P3drOk/P3drOk/ferramentas/RS485_T3D.md

# RS485 com o driver HLTNC T3D — por que não responde

Ferramenta: [`teste_rs485/teste_rs485.ino`](teste_rs485/teste_rs485.ino).
Sketch avulso, não faz parte do firmware da máquina.

---

## Antes de tudo: uma ressalva que pode te poupar dias

Você quer o encoder para detectar perda de passo. **Modbus não é o
caminho certo para isso**, mesmo que funcione.

Cada leitura Modbus custa entre 5 e 20 ms (pergunta, silêncio de quadro,
resposta). Isso dá umas 50 leituras por segundo no melhor caso, e com
jitter. Para mostrar a posição na tela, ótimo. Para pegar o motor
perdendo passo no meio de um cordão, é lento e irregular demais.

O caminho certo para malha fechada é a **saída de pulsos do encoder do
próprio driver** (PA/PB, quadratura) entrando num contador PCNT do
ESP32 — hardware contando, sem software no meio, sem latência. É o que
está no [`ROADMAP.md`](../ROADMAP.md) §1.4.

Então: RS485 vale para ler posição, alarme e parâmetros. Para perda de
passo, PA/PB. Se o RS485 estiver te custando muito tempo, vale trocar de
frente.

---

## 1. O suspeito número um: o conversor de nível

**Só UMA linha precisa de conversão de nível, e o conversor da foto é o
tipo errado para ela.**

Olhe as quatro linhas entre o ESP32 e o MAX485:

| Linha | Sentido | Precisa converter? |
|---|---|---|
| `DI` | ESP32 → MAX485 | **não** |
| `DE` | ESP32 → MAX485 | **não** |
| `RE` | ESP32 → MAX485 | **não** |
| `RO` | MAX485 → ESP32 | **sim**, 5 V → 3,3 V |

As três primeiras são entradas do MAX485, e o `VIH` dele é **2,0 V**. Os
3,3 V do ESP32 são lidos como nível alto sem problema. Passar essas
linhas pelo conversor só adiciona coisa para dar errado.

A quarta, `RO`, sai em 5 V e não pode entrar direto no ESP32.

### Por que aquele conversor azul não serve bem aqui

O módulo da foto é o de MOSFET (BSS138) com resistores de 10 kΩ. Ele foi
desenhado para **I²C**, que é dreno aberto: o barramento é puxado para
baixo ativamente e para cima por resistor.

UART é **push-pull**. Nesse conversor, a subida do sinal depende do
resistor de 10 kΩ carregando a capacitância do fio. Isso arredonda a
borda. A 9600 costuma sobreviver; a 115200, não. E é fácil ligar HV e LV
trocados sem perceber — aí ele simplesmente não passa nada.

### O que usar no lugar

Dois resistores, direto no `RO`:

```
  RO (5 V) ──┬── R1 1 kΩ ──┬── GPIO 22 (ESP32 RX)
             │             │
             │           R2 2 kΩ
             │             │
            ─┴─           GND
```

`5 V × 2 / (1 + 2) = 3,33 V`. Serve qualquer par na proporção 1:2 —
1 k/2 k, 1,5 k/3,3 k, 2,2 k/4,7 k.

Simples, rápido, sem borda arredondada. **Guarde o conversor de MOSFET
para I²C**, que é para o que ele é.

### Alternativa melhor ainda

Trocar o chip do módulo por um **MAX3485** (mesmo encapsulamento SO-8,
mesma pinagem) e alimentar o módulo com **3,3 V**. Aí não precisa de
conversão nenhuma em lado nenhum.

Alimentar um MAX485 comum com 3,3 V está **fora de especificação** (o
mínimo é 4,75 V). Às vezes funciona, às vezes funciona só até certa
distância, e às vezes funciona no bancada e falha na oficina. Não é
lugar de economizar.

---

## 2. Trocar A com B

Segunda causa mais comum, e o teste custa 30 segundos: **desligue,
inverta os dois fios do par, ligue e rode a varredura de novo.**

RS485 é diferencial. Invertido, o receptor lê o complemento de tudo — não
dá erro, não dá aviso, simplesmente nada faz sentido e o CRC nunca bate.

Não confie na serigrafia: fabricantes chamam de `A`/`B`, `D+`/`D-`,
`RS485+`/`RS485-`, e nem todos concordam sobre qual é qual.

---

## 3. GND comum

**O GND do ESP32 tem que estar ligado ao GND de sinal do driver.**

RS485 é diferencial, mas não é mágico: o receptor tem uma faixa de modo
comum (tipicamente −7 V a +12 V). Dois equipamentos com fontes separadas
e sem referência comum saem dessa faixa com facilidade, e aí o receptor
não lê nada — ou lê lixo intermitente, que é pior.

Se o cabo for longo ou o ambiente for de solda, ligue o GND por um
resistor de 100 Ω em vez de direto, para não fechar laço de terra.

---

## 4. Terminação e polarização

- **Terminação:** 120 Ω entre A e B nas **duas pontas** do barramento.
  Em cabo curto de bancada raramente faz diferença; em cabo de oficina,
  faz. Muitos módulos azuis já trazem um 120 Ω soldado — se você puser
  um em cada ponta e o módulo já tiver o dele, ficam três, o que carrega
  demais a linha.
- **Polarização:** com o barramento parado e ninguém dirigindo, A e B
  flutuam e a saída do receptor treme, gerando bits de início falsos.
  Resistores de polarização (tipicamente 10 kΩ de A para VCC e 10 kΩ de B
  para GND) seguram a linha no estado ocioso. Os módulos azuis costumam
  trazer isso; confira com o multímetro se A fica acima de B com o
  barramento em repouso.

---

## 5. O driver pode simplesmente estar com a porta desligada

Esta é a que mais me faria apostar depois do conversor de nível.

Servo driver chinês costuma sair de fábrica com a comunicação **desativada**,
ou num protocolo proprietário em vez de Modbus. Procure no manual, nos
parâmetros do teclado do driver:

- número da estação / endereço do escravo
- velocidade de comunicação (baud)
- protocolo (Modbus RTU × proprietário)
- às vezes um parâmetro separado de *habilitar comunicação*

Enquanto isso não estiver certo, nenhum código do mundo vai receber
resposta.

E confira **quais pinos do RJ45** são A e B. Isso está no manual e não dá
para adivinhar. Vários desses drivers têm dois RJ45 (entrada e saída, para
ligar em cadeia) — os dois são o mesmo barramento.

---

## 6. O atalho que vale mais que tudo isso

Se o driver veio com **software de configuração para PC + adaptador
USB-RS485**:

1. Ligue o adaptador do fabricante e faça o software falar com o driver.
2. Com o barramento funcionando, ligue o seu MAX485 **em paralelo** (A no
   A, B no B, GND comum) — RS485 é multiponto, dá para escutar.
3. Rode o **modo 2 (escutar)** do sketch.

Você vê os quadros que o software do fabricante manda, com endereço,
função e número de registrador. **O mapa Modbus aparece pronto na tela**,
em vez de você ter que descobrir por varredura.

É de longe o caminho mais rápido, e resolve também a dúvida de baud,
paridade e endereço de uma vez só.

---

## 7. Como usar o sketch

Grave `teste_rs485/teste_rs485.ino` sozinho (não é o firmware da máquina)
e abra o monitor serial em **115200**, com final de linha *Nova linha*.

### Ligação

| MAX485 | vai para |
|---|---|
| `RO` | divisor 1 k / 2 k → **GPIO 22** |
| `DI` | **GPIO 21** |
| `DE` | **GPIO 4** |
| `RE` | **GPIO 26** |
| `VCC` | 5 V |
| `GND` | GND, **comum com o ESP32** |
| `A`, `B` | par trançado até o driver |

`DE` e `RE` em pinos **separados** de propósito: é o que permite o
autoteste. Em operação normal eles andariam juntos.

Os quatro pinos estão livres no mapa do firmware
([`LIGACOES.md`](../LIGACOES.md) §1), então dá para migrar isto para a
máquina depois sem remexer em nada.

### A ordem dos testes

**`1` — autoteste do módulo.** Não precisa do driver ligado. Com `DE=1` e
`RE=0` ao mesmo tempo, o MAX485 dirige o par A/B e lê de volta o que ele
mesmo colocou lá.

> Se este falhar, **pare aqui**. O problema está entre o ESP32 e o
> módulo, e procurar o driver é perda de tempo. O sketch diz o que
> costuma ser.

**`3` — procurar o driver.** Varre velocidade × paridade × endereço e
anota **todos** os achados numa tabela, que ele imprime no fim. Depois
adota sozinho a primeira combinação com resposta válida (ou a primeira
com exceção, se não houver nenhuma válida) — os modos seguintes já saem
apontados para o lugar certo.

Reporta três coisas diferentes, e as três são úteis:

| O que aparece | O que quer dizer |
|---|---|
| resposta válida | achou |
| resposta de **exceção** | **achou também.** O driver respondeu "esse registrador não existe" — ou seja, ele está aí e falando. Só faltou o endereço certo. |
| bytes com CRC ruim | a velocidade está perto; a paridade provavelmente está errada |
| silêncio total | veja as seções 1 a 5 acima |

**`4` — varrer registradores.** Lê um por um e mostra o conteúdo.
Exceção **não** é escondida: se o driver recusar a faixa inteira, isso
aparece com o código e o significado. Tela vazia não ensina nada.

**`7` — caçar o encoder.** É o que responde à pergunta de verdade:

1. `7 0 255`
2. Ele lê tudo e pede: *"GIRE O EIXO A MÃO, bastante, e aperte qualquer
   tecla"*
3. Lê de novo e lista **só os registradores que mudaram**, com antes,
   depois e a variação

O que variou muito é a parte baixa da posição; o vizinho que variou
pouco ou nada é a parte alta.

**`6` — monitorar ao vivo.** Confirma o achado: `6 100` lê o registrador
100 e o 101 dez vezes por segundo e mostra, lado a lado, **as duas
montagens possíveis de 32 bits** mais a velocidade em unidades por
segundo.

```
  reg      +1       32b alto|baixo   32b baixo|alto   unid/s
  --------------------------------------------------------
  1204     0        78905344         1204             0.00
  1387     0        90898432         1387             1830.00
```

Isto importa mais do que parece: **muito driver Modbus manda a palavra
baixa primeiro**. Olhando só uma das montagens, a posição parece pular
sem sentido e você conclui que achou o registrador errado. A coluna que
cresce **suave** ao girar o eixo é a certa; a outra dá saltos de dezenas
de milhares — é o sinal clássico de palavra alta e baixa trocadas.

**`5` — quadro cru.** Para o dia em que você tiver o manual: digite os
bytes em hexadecimal sem o CRC, que ele calcula e mostra a resposta crua.

```
5 01 03 00 00 00 02
```

---

## 8. Um erro que este arquivo já cometeu

Na primeira versão, o resumo do modo `3` imprimia `baudAtual` e
`paridadeAtual` — que são as **variáveis do laço da varredura**. No fim
elas ficam com a última combinação *tentada*, não com a que funcionou.

Resultado: a varredura achava o driver de verdade em algum lugar, e o
resumo anunciava `250000 8O1` — que era só a última célula do laço. Os
modos seguintes iam falar em 250000 8O1, não ouviam nada, e a tela
ficava vazia.

Corrigido: os achados vão para uma tabela e o resumo lista **todos**.
Se o seu resultado antigo dizia 250000 8O1, ele provavelmente estava
errado — rode o modo `3` de novo com a versão nova.

## 9. Um detalhe de código que derruba muita gente

Vale conhecer porque é invisível no osciloscópio se você não procurar.

Depois de mandar o quadro, é preciso baixar o `DE` para poder ouvir a
resposta. Mas `Serial.flush()` só garante que a **fila** esvaziou — o
último bit ainda pode estar saindo do registrador de deslocamento. Baixar
o `DE` nesse instante corta o fim do quadro, o CRC não bate no escravo, e
ele **descarta em silêncio**.

Do lado de cá parece que o driver simplesmente não responde.

O sketch espera dois tempos de caractere depois do `flush()` antes de
soltar o `DE`. Se você escrever o seu próprio código depois, não esqueça
disso.

---

## O que foi medido nesta máquina

| | |
|---|---|
| velocidade | **19200 8N1** |
| endereço | **1** |
| função | **3 — holding registers** |
| posição | **registrador 90 (baixa) e 91 (alta)** |
| ordem | **palavra baixa primeiro** |

**Como se provou.** Três caçadas separadas, em posições diferentes do
eixo, montadas como 32 bits com a baixa primeiro:

| caçada | de | para | variou |
|---|---|---|---|
| A | 9 361 | 15 841 | +6 480 |
| B | 15 842 | 124 571 | +108 729 |
| C | 124 574 | 42 069 | −82 505 |

Repare nas emendas: A termina em 15 841 e B começa em 15 842. B termina
em 124 571 e C começa em 124 574. **O valor é contínuo entre caçadas** —
coincidência não é contínua três vezes seguidas.

Na caçada B o registrador 90 deu a volta (passou de 65 535) e o 91 subiu
de 0 para 1, exatamente como uma palavra baixa e uma alta fazem. Na
caçada A, que andou pouco, o 91 nem se mexeu.

### Os registradores 92, 93 e 94 não são a posição

Eles aparecem nas caçadas e confundem. Repare no comportamento: andam
**juntos** (os dois +6, depois os dois −23) e vão para valores negativos
(65 530 = −6). Isso é **erro de seguimento** e velocidade, não posição.
A diferença prática: eles voltam para perto de zero quando o eixo para;
a posição não volta.

É por isso que a caçada, nos modos 7 do programa e no painel, deixou de
listar candidatos e passou a **provar o par**: monta r/r+1 das duas
maneiras e só aponta quando a montagem certa é pelo menos 8× mais mansa
que a errada. Um par que não é de 32 bits não passa nesse crivo.

## Modos novos

| | |
|---|---|
| `8 90` | **mede as contagens por volta.** Marca, você dá uma volta completa no eixo do motor, marca de novo. É o único número do encoder que não dá para descobrir olhando — sem ele a leitura não vira grau |
| `9 90` | **grava a posição em CSV** (`ms,contagem,delta`) para colar numa planilha. É assim que se enxerga passo perdido, folga e ruído, que número na tela não mostra |

O modo 8 encaixa no valor redondo mais próximo quando está dentro de 3%:
uma volta dada à mão nunca fecha exata, e é mais provável que a mão tenha
ficado torta do que o encoder ter um número quebrado.

## Um defeito do próprio programa, corrigido

O autoteste (modo 1) passeia por todas as velocidades e **não devolvia a
linha como estava** — terminava deixando 115200 8O1, e o menu passava a
mentir logo depois de dizer "MODULO OK". Aparece nos logs como
`atual: 115200 8O1` logo abaixo do autoteste. Agora ele guarda e
restaura.

## Escrever no driver — e por que isso mora aqui, e não no firmware

O firmware da máquina **lê e só lê**: `encoder.h` diz isso no cabeçalho e
o banco reprova quem tentar configurar uma função de escrita. Não é
timidez. Ler no registrador errado dá um número errado na tela; escrever
no registrador errado num servo drive pode trocar a engrenagem eletrônica,
o modo de controle, o sentido do eixo ou o limite de torque — e o eixo
pode sair andando.

Enquanto não se souber **com certeza** qual registrador é o quê neste
driver, escrever é experimento de bancada, com o motor desacoplado da
mecânica, e não função de painel. Por isso os modos abaixo estão neste
sketch avulso.

| | |
|---|---|
| `d` / `d 4096 4351` | **foto da faixa.** Lê tudo e guarda. Nada é escrito |
| `d2` | **compara** com a foto e lista o que mudou |
| `w 98 1` | **escreve** 1 no registrador 98 pela função 06, e confere relendo |
| `W 98 1` | o mesmo pela função 16 — há driver que recusa a 06 mesmo para um registrador só |
| `s 98` / `s 98 1 0` | **testa o SON**: habilita, você confere o eixo, desabilita |

### Achar um parâmetro sem escrever nada

É o mesmo raciocínio do modo 7 (achar o encoder movendo o eixo), só que o
que se mexe é um parâmetro em vez do braço:

1. `d` — tira a foto dos registradores.
2. Vá ao **painel do driver** e mude o parâmetro (P098, por exemplo).
3. `d2` — o que mudou entre as duas fotos é o endereço daquele parâmetro.

Zero escrita: se o endereço estiver errado, o pior que acontece é não
achar nada. Deixe o eixo **parado** — a posição muda sozinha e apareceria
na lista junto com o parâmetro.

### Toda escrita é conferida relendo

Driver que responde *aceitei* e guarda outra coisa existe: registrador só
de leitura, escrita bloqueada por nível de acesso, parâmetro que só vale
com o servo desabilitado. Sem reler, o programa diria "pronto" e nada
teria mudado. `w`, `W` e `s` releem e comparam.

### O SON pelo Modbus — agora é assim que a máquina funciona

Este arquivo dizia, com razão, que o `SON` era um **fio** e que trocá-lo
pelo barramento não valia a pena. Na bancada desta máquina o argumento
caiu por baixo: o **P098** do painel governa o torque, e com ele em 1 o
terminal externo não tinha efeito nenhum. O fio do GPIO 23 já era
decorativo antes de sair.

O habilita foi para o Modbus. Medido aqui:

| | |
|---|---|
| registrador | **98** (é o P098 do painel) |
| habilita | **1** |
| desabilita | **0** |
| função | **06** |

**O que isso custa continua verdade e não mudou.** Fio de SON rompido
desabilitava o motor. Fio de RS485 rompido **não desabilita nada** —
deixa o eixo como estava. O caminho do habilita deixou de ser falha
segura.

O que se pôs no lugar:

1. **Contator** em série com a potência dos drivers, aberto pelo contato
   NC da emergência. É o único corte que funciona com o ESP32 morto, e
   deixou de ser recomendação. Ver `LIGACOES.md` §6.
2. Toda escrita é conferida **relendo**, e desabilitar que não confirma
   derruba a máquina em `FALHA` — ver os cenários **V01 a V05** do banco.

O modo `s` continua sendo por onde se descobre o registrador antes de
gravá-lo em **Ajustes → Habilita (SON)**.

## O alarme pelo Modbus

O `ALM` continua sendo fio (GPIO 34/35). Pelo barramento dá para ler o
**código** da falha, e não só "tem falha" — o fio é um bit, o registrador
é o motivo.

| | |
|---|---|
| `a 100` | **ler ao vivo**: mostra o valor em número, hex e bits, e avisa quando muda. Não escreve |
| `a 100 0` | **rearmar**: escreve 0 no 100 e confere se limpou |
| `A 100 0` | o mesmo pela função 16 |

### Achar o registrador do alarme

Mesma receita do P098, com o gatilho trocado:

1. `d` — foto da faixa.
2. **Provoque um alarme de verdade**: desligue o cabo do encoder do
   driver, ou force sobrecarga.
3. `d2` — o que mudou é o alarme.

Depois `a <reg>` com a falha indo e voltando: anote o valor **com** falha
e o valor **sem**. São eles que dizem o que é alarme neste driver.

### Ler e rearmar são coisas diferentes

**Ler** não muda nada e roda com a máquina montada. **Rearmar** escreve, e
só limpa alarme cuja causa já foi resolvida — se o motivo continua lá, o
driver rearma e alarma de novo no mesmo instante. Isso não é defeito do
rearme: é o driver fazendo o trabalho dele.

> **Nunca rearme em laço.** Alarme que volta sozinho é informação: alguma
> coisa está errada na máquina. Rearmar repetido esconde exatamente o que
> você precisa ver, gasta a EEPROM do driver, e deixa o eixo energizando
> e desenergizando sem ninguém no controle.

O firmware **não** rearma alarme. Isso é decisão de quem está na frente
da máquina, com os olhos nela.
