P3drOk/P3drOk/(list of files, cad)

Other CAD files:
testes/interface/amostras/peca.dxf
