P3drOk/P3drOk/MANUAL.md

# Robo2dof — manual do sistema

Braço de solda de **dois eixos**, comandado por um ESP32 que serve um
painel web pela sua própria rede Wi-Fi. Sem nuvem, sem internet, sem
aplicativo para instalar: entra-se na rede do robô e abre-se o painel.

Este documento é o mapa completo. Para a explicação de *como as coisas
foram descobertas* (e dos defeitos que apareceram no caminho), veja
[`ACHADOS.md`](ACHADOS.md).

---

## 1. O que é a máquina

| | |
|---|---|
| Estrutura | braço planar de 2 graus de liberdade (dois eixos girando no mesmo plano horizontal) |
| Motores | 2 × servo AC **80AST-A1C04025** |
| Drivers | 2 × **HLTNC T3D-L20A** |
| Cérebro | ESP32 (WROOM-32), dois núcleos |
| Realimentação | encoder do próprio servo, lido pelo driver por **Modbus RTU / RS485** |
| Interface | página web servida pelo ESP32, na rede Wi-Fi que ele mesmo cria |
| Armazenamento | NVS interna (configuração) + cartão microSD (programas e trajetórias) |

### A regra de ouro do projeto

> **O núcleo 1 manda no motor. O núcleo 0 nunca toca no motor.**

O núcleo 1 roda o `loop()`: geração de pulso, estado da máquina, relé de
solda. O núcleo 0 roda tudo que espera por alguém: servidor web, Wi-Fi,
cartão, leitura do encoder.

A comunicação entre eles é de mão única e por duas estruturas apenas:

- **`Comando`** — o núcleo 0 enfileira, o núcleo 1 consome.
- **`Snapshot`** — o núcleo 1 publica, o núcleo 0 lê.

Nenhum handler web chama `posicaoJ1()`. Nenhuma tarefa de rede move um
eixo. Quando essa regra foi quebrada (aconteceu duas vezes), o sintoma
foi leitura corrompida e quadro perdido — está registrado em `ACHADOS.md`.

---

## 2. Ligações

A tabela oficial e conferida por teste é [`LIGACOES.md`](LIGACOES.md) —
o script `testes/conferir_ligacoes.py` reprova se ela discordar de
`Robo2dof/config.h`. Resumo:

### Motores

| Sinal | GPIO | Observação |
|---|---|---|
| J1 pulso | 16 | vai para `PUL+` via buffer 5 V |
| J1 direção | 17 | `DIR+` |
| J2 pulso | 18 | |
| J2 direção | 19 | |
| Alarme J1 | 34 | **só entrada**, precisa de pull-up externo de 10 k |
| Alarme J2 | 35 | idem |

> **O habilita não está nesta tabela.** Ele deixou de ser fio: vai por
> **Modbus**, no registrador **98** (o `P098` do painel), pelo mesmo
> RS485 que lê o encoder. O GPIO 23 ficou livre. Em troca, o **contator**
> da emergência passou a ser obrigatório — é o único corte que funciona
> com o ESP32 travado. Ver `LIGACOES.md` §3.3 e §6.

> GPIO 34 e 35 não têm pull-up interno. Sem o resistor externo, o pino
> flutua e o firmware lê ruído. O flag `ALARME_FISICO_INSTALADO` fica
> `false` até a fiação existir — foi exatamente esse o travamento da v2.1.

### Solda e emergência

| Sinal | GPIO | Observação |
|---|---|---|
| Relé da solda | 2 | ativo em ALTO, com **pull-down físico de 10 k** para GND |
| Botão de emergência | 27 | contato NC: LOW = emergência |

> O GPIO 2 é o LED da placa — útil na bancada, ruim na máquina: é
> *strapping pin* e pisca sozinho durante o boot, o que num relé de solda
> significa abrir arco na hora de energizar. Na máquina de verdade,
> troque para o 26 (e então `PIN_LED_STATUS` tem de ficar em 255).

### Cartão microSD (SPI)

| Módulo | GPIO | |
|---|---|---|
| 3V3 | 3V3 | **nunca no 5 V** neste módulo: ele não tem regulador |
| CS | 5 | |
| SCK | 14 | |
| MOSI | 13 | |
| MISO | **25** | *não* o 12 |

> O GPIO 12 é o MISO "padrão" do HSPI, e o módulo tem pull-up de 10 k
> nessa linha. O 12 é strapping (MTDI): alto no boot programa o regulador
> do flash para 1,8 V e a placa não dá mais boot. Por isso o MISO vai
> para o 25 — o ESP32 remapeia SPI por matriz, então não se perde nada.
>
> Ponha 10 µF cerâmico entre 3V3 e GND junto ao módulo: o cartão puxa
> picos de ~100 mA na escrita.

### RS485 (leitura do encoder)

| MAX485 | GPIO | |
|---|---|---|
| RO | 22 | via **divisor de 2 resistores**, não conversor de MOSFET |
| DI | 21 | |
| DE | 4 | 1 = transmitindo |
| RE | 26 | 0 = ouvindo |
| A / B | driver | trocados = silêncio absoluto |
| GND | comum | obrigatório |

> **A UART2 do ESP32 tem 16 e 17 como pinos padrão** — que neste projeto
> são o passo e a direção da junta 1. Todo `begin()` deste projeto passa
> RX e TX explicitamente, e o cenário `L01c` reprova se alguém esquecer.

---

## 3. Configuração do driver T3D-L20A

O mapa Modbus do T3D **não é publicado** e muda por versão de firmware.
Os valores abaixo foram **medidos** nesta máquina com
`ferramentas/teste_rs485`.

| | |
|---|---|
| Velocidade | **19200 8N1** |
| Endereço Modbus | **1** (junta 1) |
| Função | **3 — holding registers** |
| Posição | registrador **90** (palavra baixa) e **91** (alta) |
| Ordem | **palavra baixa primeiro** |
| Contagens por volta | **131 072** (encoder de 17 bits) |

### Como esses números foram provados

Três caçadas separadas, em posições diferentes do eixo, montando 90/91
como 32 bits com a baixa primeiro:

| caçada | de | para | variou |
|---|---|---|---|
| A | 9 361 | 15 841 | +6 480 |
| B | 15 842 | 124 571 | +108 729 |
| C | 124 574 | 42 069 | −82 505 |

O valor é **contínuo entre caçadas** — A termina em 15 841 e B começa em
15 842. Coincidência não é contínua três vezes. E na caçada B o
registrador 90 deu a volta e o 91 subiu de 0 para 1, que é exatamente o
que uma palavra baixa e uma alta fazem.

### Registradores que enganam

**92, 93 e 94 não são a posição.** Eles mudam quando o eixo gira e
chegam a dar o maior salto da lista, mas:

- andam **juntos** (os dois +6, depois os dois −23);
- vão para valores negativos (65 530 lidos sem sinal são **−6**);
- **voltam para perto de zero quando o eixo para**.

É erro de seguimento e velocidade. A posição não volta. Por isso a
caçada do sistema exige **dois giros no mesmo sentido** antes de apontar
um par.

### Parâmetros do driver a conferir

Pelo painel do próprio driver (não pelo Modbus — este sistema **nunca**
escreve registrador):

| | |
|---|---|
| Porta RS485 | **habilitada** — muitos T3D saem de fábrica com ela desligada |
| Endereço | 1 na junta 1, 2 na junta 2 (endereços diferentes no mesmo barramento) |
| Velocidade | 19200, 8N1 |
| Engrenagem eletrônica | define os **pulsos por volta** que o firmware precisa saber (`PASSOS_POR_VOLTA_PADRAO`, 10000 de fábrica) |
| Modo de comando | pulso + direção, coletor aberto |

---

## 4. Como o firmware é organizado

| Arquivo | O que faz |
|---|---|
| `Robo2dof.ino` | `setup()`, `loop()`, máquina de estados dos modos, `processarComando()` |
| `config.h` | pinos, limites elétricos e mecânicos, padrões de fábrica |
| `estado.h/.cpp` | `Junta`, `Snapshot`, fila de comandos, configuração e NVS |
| `motores.h/.cpp` | FastAccelStepper, jog, movimento coordenado, parada |
| `cinematica.h/.cpp` | direta e inversa do braço 2R, validação de postura e de caminho |
| `trajetoria.h/.cpp` | gravação e reprodução a mão livre |
| `programa.h/.cpp` | pontos, cordões em reta interpolada, deslocamentos |
| `calibracao.h/.cpp` | as quatro marcas de curso das juntas |
| `solda.h/.cpp` | relé, com as proteções |
| `armazenamento.h/.cpp` | cartão SD, tarefa própria no núcleo 0 |
| `rede.h/.cpp` | ponto de acesso, mDNS, DNS de captura |
| `servidor_web.cpp` | todas as rotas HTTP |
| `encoder.h/.cpp` | mestre Modbus, tarefa própria no núcleo 0 |
| `correcao.h/.cpp` | assentamento de posição pelo encoder, seguir o eixo solto, zero absoluto |
| `aprender.h/.cpp` | modo aprendizado e o botão físico da ponteira |
| `ota.h/.cpp` | atualização de firmware pela rede |
| `pagina_web.h` | a interface inteira, um arquivo — **é aqui que se edita** |
| `pagina_web_gz.h` | gerado; `testes/gerar_pagina_gz.py` refaz |

### Modos da máquina

| Modo | O que acontece |
|---|---|
| `MANUAL` | jog liberado, ajustes permitidos |
| `GRAVANDO` | jog + amostragem da trajetória a mão livre |
| `REPRODUZINDO` | repete a trajetória gravada |
| `EXECUTANDO` | roda o programa de pontos |
| `POSICIONANDO` | indo para um alvo — e, ao chegar, **assentando pelo encoder** |
| `CALIBRANDO` | assistente de curso |
| `FALHA` | parada suave, nada anda |

---

## 5. Funcionalidades

### 5.0 Onde fica cada coisa na tela

A tela de trabalho tem cinco abas, e só elas:

| aba | para quê |
|---|---|
| **Mesa** | traçado, desenho e a vista 2D/3D do braço |
| **Mover** | joystick, ir para ângulo, atalhos |
| **Mão livre** | **ensinar o caminho com a mão** — por pontos ou contínuo |
| **Programa** | editar a lista, ensaiar, soldar, produção |
| **Encoder** | a leitura ao vivo, análise e diagnóstico da linha |

Abaixo das abas há uma **tira fixa** com três coisas: a calibração do braço e
da área da mesa, a **velocidade** e a **partida**. A calibração era a tela mais
procurada e a que morava mais fundo, e agora está a um toque de qualquer aba —
a tira também diz de relance se a máquina já está calibrada. A velocidade e a
partida estão ali porque são os dois ajustes que se mexe **com a máquina
andando**, olhando o braço: um morava dentro da aba Mover e o outro três toques
dentro da gaveta.

É uma tira, e não um cartão, porque no telefone a barra de abas já ocupa o
rodapé — um segundo rodapé gordo comeria a altura mais escassa que a tela tem.
No telefone os três cabem numa linha só: a palavra "velocidade" sai (o `mm/s`
ao lado já diz o que o campo é) e o botão de calibrar encolhe com reticências.

A **Mão livre** vem antes do Programa porque é ali que o trabalho começa:
primeiro se ensina o caminho, depois ele roda. Quem **grava** é ela; quem
**executa** continua sendo o Programa, e os pontos são os mesmos — uma
lista só, vista dos dois lados.

> **Configuração:** cada página da gaveta abre com o **primeiro cartão** à
> vista, e só ele. Antes abriam todos na tela larga, e quem procurava uma coisa
> lia todas. Para varrer os ajustes existe a **busca**, que lê o texto inteiro
> de todos os cartões de todas as páginas.

**Arquivos** saiu daqui: era um terço de coluna ao lado do braço, e ali
uma lista de trabalhos nunca cabia. Virou **gaveta de tela cheia**, no
mesmo molde da Configuração, e se abre pelo atalho **Arquivos** do
cabeçalho. Guardar e abrir trabalho é uma biblioteca — biblioteca quer
largura, e não se olha para o braço enquanto se escolhe arquivo. As duas
gavetas se comportam igual: mesmo lugar do título, mesmo botão Fechar,
**Esc** fecha, tocar fora fecha, e só uma fica aberta por vez.

Tudo que se ajusta **uma vez** mora atrás da **engrenagem** do cabeçalho,
numa gaveta com quatro páginas:

| página | o que tem |
|---|---|
| **Máquina** | **por onde começar**, elos, velocidades, acelerações, resolução, sentido dos eixos, proteções |
| **Calibração** | resolução e redução medidas, curso das juntas, área da mesa |
| **Encoder** | correção de posição, zero absoluto, ligação Modbus |
| **Sistema** | saúde, registro de eventos, QR de conexão, firmware, cópia no cartão, idioma, apagar tudo |

A divisão é essa: **operar** fica nas abas, **instalar** fica na gaveta.

Duas coisas ajudam quem chega:

- **Por onde começar**, no alto da página Máquina: os cinco passos da
  instalação em ordem — medidas, torque, calibração, área da mesa, zero
  absoluto —, cada um dizendo se **já está feito** (lido do estado real
  da máquina) e levando ao cartão onde se faz.
- A **busca**, logo abaixo do título: digite "aceleração" e a gaveta
  mostra os cartões que falam disso, de todas as páginas ao mesmo tempo,
  já abertos. Ela varre o texto inteiro do cartão e ignora acento.

> O **cabeçalho e a barra de abas ficam acima da gaveta**, e continuam
> clicáveis com ela aberta.

> **Onde fica o PARAR.** Ele morava no cabeçalho, visível de toda tela.
> A pedido de quem opera, mudou para a **linha de comando da aba Mover**,
> junto do torque de cada eixo — os três botões que mexem na máquina,
> lado a lado, no alto do painel que a mão já está usando.
>
> O que isso custa, dito claramente: **o PARAR não aparece na aba
> Programa nem com a gaveta de Configuração aberta.** O que para a
> máquina de qualquer lugar passou a ser a **tecla de espaço**, que vale
> em qualquer aba e com a gaveta aberta.
>
> Nada disso é a parada de emergência. A parada de emergência sempre foi
> o **contator no fio**, comandado pelo botão físico NC do GPIO 27: é o
> único corte que funciona com o ESP32 travado, e é ele que a norma
> cobra. O botão da tela é conveniência.

A gaveta fecha pelo X, pelo **Esc**, tocando fora dela, ou escolhendo uma
aba de trabalho. Ela tem o **próprio** botão `?` de explicações, que nasce
desligado: na tela de trabalho as notas são poucas e curtas, mas aqui são
dezenas de parágrafos de manual e cabia uma página de texto entre um
campo e o próximo.

### 5.1 Comando manual

**Joystick** dos dois eixos: quanto mais longe do centro, mais rápido.
Zona morta de 12 %. Exige confirmação a cada 350 ms — se o navegador
travar ou a tela apagar, **o eixo para sozinho**.

**Passo a passo**: setas ↺ / ↻ por junta. O sentido de cada eixo é
invertível (Ajustes, ou durante a etapa de referência da calibração):
nem sempre o sentido das setas bate com o do motor.

**Ir para um ângulo**: um campo **por junta**, e o botão leva as duas numa
tacada. Preencher só um campo move só aquela junta — a outra recebe a própria
contagem do firmware e não anda um pulso. Antes era um campo só, agindo na
junta selecionada em outro canto da tela: quem esquecia de trocar a seleção
mandava a junta errada para o ângulo certo.

**Velocidade: um controle, em mm/s.** Ele está na tira do rodapé e vale para o
jog *e* para o ir-para-ângulo — são o mesmo gesto para quem opera. A conversão
é a do braço esticado (`R = elo1 + elo2`), então é exata com o braço aberto e
conservadora quando dobrado: nunca mais rápido do que se pediu. O equivalente
em `°/s` na junta fica ao lado, pequeno, para conferir.

> Havia quatro maneiras de escolher esse mesmo número — cinco degraus, os
> apelidos *lento/normal/rápido*, o botão **Precisão** e os perfis da aba
> Máquina. Trocar de escala era o que fazia a velocidade parecer que "não
> pegava". Ficou **uma**. O modo Precisão saiu inteiro, firmware incluído:
> "precisão" agora é digitar um número menor, o que é mais direto do que
> lembrar em que modo a máquina está.

**Partida**: ao lado da velocidade, na mesma tira. Quanto maior, mais macia a
partida e a parada. Vale na hora — é olhando o braço arrancar que se decide.
As acelerações por junta continuam na página **Máquina** da gaveta, com o
resto do ajuste direto.

### 5.2 Calibração

Página **Calibração** da gaveta. No topo, o cartão **Calibração guiada**:
quatro passos, **nesta ordem**, porque cada um usa o resultado do
anterior.

| | passo | por que aqui |
|---|---|---|
| 1 | **Sentido dos eixos** | o braço tem de girar para o lado que o desenho mostra — se estiver trocado, tudo o que vier depois é medido ao contrário |
| 2 | **Redução de cada eixo** | é ela que faz o desenho bater com o braço |
| 3 | **Curso das juntas** | até onde cada junta pode ir; é medido em **graus**, então depende da redução |
| 4 | **Área da mesa** | onde a peça fica; os cantos são gravados com a ponta, e a ponta só vai aonde o curso deixa |

O que já estiver pronto aparece marcado, e o cartão diz em palavras qual
é o próximo. **Ele não refaz nenhum passo**: toca-se num e ele abre o
cartão que faz o trabalho, logo abaixo. Duplicar a ação ali seria
duplicar a regra, e regra duplicada é regra que diverge.

O passo do sentido não tem medida — é uma conferência, e a marca dela
fica no navegador, não na máquina.

Gaveta da engrenagem, página **Calibração**. Cinco coisas, medidas em
ordem.

#### A conta que a máquina faz

```
passosPorGrau = passosPorVolta × redução ÷ 360
```

São **dois** números, e cada um erra de um jeito diferente. Por isso os
passos 1 e 2 medem um de cada vez.

#### Passo 1 — Engrenagem eletrônica (sem instrumento)

Quantos passos o driver precisa para dar uma volta no motor. É parâmetro
do T3D e é o número que mais se erra: troca-se o driver, refaz-se um
parâmetro, e o declarado deixa de bater. O sintoma é o braço andar menos
(ou mais) do que a tela diz, sem nada apontar para o culpado.

O encoder mede isso **sozinho**: manda-se um tanto conhecido de passos e
pergunta-se quantas voltas o motor deu.

#### Passo 2 — Redução mecânica

> **Leia isto antes de achar que o encoder resolve sozinho.**
>
> O encoder está no eixo do **motor**, antes do redutor. O ângulo que ele
> mostra na tela já é calculado assim:
>
> `graus da junta = voltas do motor × 360 ÷ redução`
>
> Ou seja: **o ângulo lido já depende da redução.** Não dá para tirar a
> redução dele — seria tirar o número de uma conta que usa o próprio
> número. Isso é física, não limitação de programa: com um sensor só, e
> antes do redutor, a relação do redutor é invisível.

O que o encoder dá de graça, e com muita precisão, é a contagem de
**voltas do motor**. Falta **uma** referência do lado da junta. Com ela a
redução sai exata:

```
redução = voltas do motor × 360 ÷ ângulo real da junta
```

**De onde tirar a referência**, da melhor para a pior:

| | método | por quê |
|---|---|---|
| 1 | **Esquadro (90°)** | preciso, e todo mundo tem um. É o recomendado |
| 2 | **Curso entre batentes** | maior ângulo disponível → menor erro relativo |
| 3 | **Volta completa** | se a junta der uma, não precisa de instrumento nenhum |

**Por que isto é melhor do que a medida antiga.** A anterior contava
*pulsos comandados*: ela erra junto com a engrenagem eletrônica (se
`passosPorVolta` estiver errado, a redução sai errada na mesma proporção)
e erra junto com perda de passo (o eixo escorrega e a conta nem fica
sabendo). Contar voltas reais do motor não tem nenhum dos dois problemas
— o encoder mede o eixo, não a intenção. Cenário **U01** prova exatamente
isso: mede certo com o eixo escorregando metade do caminho.

O que a medida **recusa** (cenário **U02**): menos de um quarto de volta
do motor, ângulo de referência menor que 5°, e qualquer resultado fora de
0,5:1 a 1000:1 — que só pode significar que a referência informada não
bate com o que o eixo andou.

#### Passo 3 — Curso das juntas

O assistente de sempre, agora acessível de dentro da aba. Ver §5.2.1.

#### Passo 4 — Área da mesa

A área útil deixou de ser dois números digitados e passou a ser
**ensinada**: leva-se a ponta a cada canto e grava. O retângulo é a caixa
que contém os cantos ensinados (dois opostos bastam; mais cantos só
melhoram).

Dali para fora **o braço não anda** — nem por programa, nem pelas setas.
A checagem é da **ponta**, não do cotovelo: o cotovelo passa por cima da
mesa o tempo todo e não solda nada.

> Se a ponta parar fora da área, só o movimento que a traz de volta é
> liberado. A área entra na mesma conta de gravidade que os limites de
> curso, então o jog de recuperação funciona igual — **o braço nunca se
> prende do lado de fora da própria mesa**. Cenário **U03f**.

Sem área ensinada a máquina se protege como antes, pelo **Y mínimo** e
pelo **raio morto da base** — que continuam valendo em qualquer caso: o
raio da base é mecânica, não mesa.

#### Passo 5 — Conferir

O quadro do topo da página mostra **comandado × medido** para as duas
juntas, ao vivo. Se os dois andarem juntos depois de um movimento, a
resolução está certa. Se o medido andar menos, a redução declarada está
maior que a real.

#### Onde isto fica guardado

Tudo — resolução, redução, curso, referência e a área da mesa — vai para
a memória da máquina assim que se confirma, e sobrevive à queda de
energia. No cartão, o backup em **Arquivos → ajustes** leva a calibração e
a mesa **junto**. Backup gravado por uma versão anterior não apaga
nenhuma das duas: o que o arquivo não traz, ele não mexe.

### 5.2.1 Calibração: dois batentes, e é opcional

O braço tem **limite físico**: sem saber onde ele está, o firmware não
tem como impedir uma batida. A calibração ensina isso — e **só isso**.

**Calibrar é opcional.** Sem limites medidos a máquina opera igual: jog,
ir para um ângulo, ponto gravado, programa, trajetória, aprendizado e
área da mesa, tudo funciona. O que falta é a proteção de curso. Nada é
recusado por falta de calibração.

**São dois gestos, e nada a digitar:**

1. Toque em **Calibrar**. Os motores **soltam na hora**, e o braço fica
   onde está — ele não sai do lugar.
2. Leve o braço com a mão até o extremo **negativo** — os dois eixos de
   uma vez, que com o braço solto os dois estão soltos — e toque em
   **Salvar**.
3. Dali mesmo, leve até o extremo **positivo** e toque de novo.
4. A máquina grava, religa o torque, espera o rotor segurar
   (`CAL_ESPERA_RELIGAR_MS`) e volta ao zero.

Com o motor solto o operador **sente** o batente. Com torque ele empurra
o eixo contra o ferro e só descobre pelo barulho.

> **Qual lado é o negativo?** A tela diz, por junta, qual seta vai para
> lá — o sentido depende da chave de inversão de cada eixo, e adivinhar
> isso não é trabalho de quem opera.

#### O que a calibração grava — e o que ela não toca

Ela grava **uma coisa só**: até onde cada junta pode ir.

| | |
|---|---|
| **limites** | exatamente os dois batentes marcados |
| **ângulo** | **não muda** |
| **escala do encoder** | **não muda** |
| **origem (zero)** | **não muda** |
| **pulsos por volta** | **não muda** |

Isso é o conserto de um defeito real de bancada: *"os ângulos quando
calibrados ficam todos errados"*. A versão anterior media a escala do
encoder entre os dois extremos e a adotava, remedia os pulsos por volta
nas viagens ao zero e zerava a origem. Como `grausMin`/`grausMax` saem
dos **passos divididos pela régua**, mexer na régua logo depois de gravar
os limites muda o ângulo que esses limites descrevem — marcar 90 e 270 e
depois ver **91 ser recusado como fora de curso** era exatamente isso.
Cenário **V26**.

> **Os limites são os dois batentes, e ponto.** A versão anterior
> esticava o intervalo até incluir o zero. Com os dois batentes do mesmo
> lado — 90 e 270 — ela inventava 90° de percurso que o ferro não tem. Se
> o zero ficar fora do curso, quem diz isso é a ida ao zero, com todas as
> letras: *"o zero está fora do curso calibrado"*.

O único número que continua declarado é a **redução do redutor**. Ela é
mecânica, está escrita no que você comprou, e com um sensor só antes do
redutor nenhuma medida a revela.

> A proteção de curso é **por software**. Ela vale enquanto a calibração
> corresponder à máquina. Trocar a montagem, afrouxar o acoplamento ou
> mexer na redução invalida a calibração — recalibre.

#### Encoder absoluto: a máquina se localiza sozinha

O encoder do servo **guarda a posição com a máquina desligada**. Se
alguém empurrar o braço à mão com tudo apagado, ao ligar ele sabe. Isso
**dispensa fim de curso**: em vez de procurar batente, a máquina lê onde
está.

Para isso ela precisa saber uma coisa só: **qual contagem crua do encoder
corresponde a 0°**. Ensina-se uma vez, na página avançada (aba Encoder →
*Zero absoluto* → cadeado).

| | |
|---|---|
| **Ensinar** | leve o braço a uma postura que você sabe medir, informe o ângulo real. Não precisa ser 0 |
| **Ao ligar** | a contagem de passos é acertada pelo encoder, e a máquina já nasce sabendo onde está |
| **Ir para 0°** | opcional: depois de se localizar, o braço vai para o zero |

**De fábrica o zero NÃO vem ensinado.** Uma máquina recém-montada
acreditaria que a contagem crua 0 do encoder é o zero da junta — um
número arbitrário — e iria para lá sozinha. Enquanto ninguém ensinar, a
máquina liga exatamente como antes.

**O que impede a ida automática ao zero:**

| | |
|---|---|
| zero não ensinado | não há referência em que acreditar |
| **servos desabilitados** | é o intertravamento: habilitar servos é uma ação sua na tela, e enquanto ninguém habilitar o braço não tem como andar |

### Os botões do motor

No alto da tela, ao lado do **PARAR**, visíveis de qualquer aba. São
**dois, um por eixo**: cada driver é um escravo Modbus próprio, e com um
driver só no barramento você precisa poder trabalhar no eixo que existe.

O que cada torque libera:

| | precisa |
|---|---|
| jog de um eixo | o torque **daquele** eixo |
| programa, trajetória, ir ao zero | **os dois** eixos |

Um eixo sem torque não recebe pulso, de propósito: o gerador contaria
passos com o eixo parado e todo limite de curso passaria a apontar para o
lugar errado.

As mesmas duas chaves aparecem em *Ajustes → Preparar a máquina*, uma por
eixo. É o mesmo comando: os botões do cabeçalho são o atalho.

> **Um motor só na bancada.** Habilite o eixo que existe e trabalhe nele.
> Desabilitar o eixo que não está no barramento avisa que aquele driver
> não respondeu e segue — não derruba a máquina, porque um driver que
> nunca teve torque não tem o que cortar.

| cor | o que significa |
|---|---|
| verde | aquele eixo tem torque |
| cinza | sem torque |
| laranja, *...* | pedido feito, os drivers ainda não responderam |
| vermelho, *FALHOU* | o barramento não confirmou — veja `LIGACOES.md` §3.3 |
| vermelho, *SEM REG* | registrador do habilita não configurado |

O laranja é o que importa entender: desde que o habilita foi para o
RS485, **"mandei" e "tem torque" deixaram de ser a mesma coisa**. Enquanto
o botão estiver laranja, ninguém garante que o braço tem torque — e o
firmware não garante também: ele só diz verde depois de reler o
registrador no driver e ver o valor lá.
| sem leitura do encoder | desiste depois de 5 s e avisa — máquina que não liga é pior que máquina desorientada |
| zero fora do curso calibrado | não vai: furar a proteção seria pior que não ir |
| solda ligada, ou fora do manual | não vai |

> A página fica atrás de um cadeado, e o cadeado **volta a fechar em toda
> visita**. Não é senha: é um tranco para não se mexer sem querer. O que
> está atrás dele é a origem de onde os limites de curso são contados —
> errar ali desloca a área útil inteira.

#### Detecção de travamento

Antes do encoder, encostar no batente era invisível para o firmware: ele
continuava contando pulsos, o driver continuava recebendo, e o motor
ficava **forçando contra o ferro**.

Agora isso é mensurável: comando andando + medido parado = o eixo
encostou em alguma coisa (ou o acoplamento soltou, ou o driver desarmou).
O sistema **para o eixo** e avisa. O aviso fica na tela até você dizer que
resolveu — aviso que some sozinho é aviso que ninguém leu.

É deliberadamente conservador, porque um falso positivo pararia o braço
no meio de um cordão:

| | |
|---|---|
| só julga com o comando **claramente** andando | perto de zero a conta não distingue parado de travado — e parado não está forçando nada |
| exige o medido **claramente** parado | menos de um quinto do esperado |
| por **meio segundo** | a leitura vem a 20 Hz: menos que isso seria julgar com duas ou três amostras |
| **sem leitura, se cala** | cabo solto no encoder não pode parar o braço no meio de um cordão |
| **parar exige régua medida** | ele só corta o movimento quando a escala do encoder foi medida (a calibração mede). Sem ela, avisa e não encosta no braço — julgar por número digitado foi o que fazia a máquina travar do nada |
| **silêncio não acusa** | meio segundo de suspeita só vale se tiver sido preenchido por leituras que **chegaram**. Leitura que falha tem a velocidade zerada de propósito (a tela não pode dizer que o eixo gira depois que o fio caiu), e um zero desses é o encoder calado, não o eixo parado. Num barramento ruim uma rajada de falhas enchia a janela sozinha e o braço parava no meio do cordão |

### 5.2.2 O desenho mostra onde o braço ESTÁ

O boneco 2D e o 3D eram desenhados com o ângulo **comandado** — a conta de
pulsos do firmware. Isso desenha a intenção, não o braço: se o eixo
escorregou, a tela continua mostrando tudo no lugar enquanto a peça sai
torta.

Agora o boneco é a posição **medida pelo encoder**, e **só ela**. A
legenda do rodapé diz de onde vem a postura desenhada.

> **O fantasma tracejado saiu.** O comandado chegou a ser desenhado por
> trás, em vermelho tracejado, quando os dois discordavam de mais de meio
> grau — a ideia era dar a *ver* o desvio em vez de obrigar a ler um
> número. Saiu a pedido de quem opera, e o motivo é bom: durante **todo**
> movimento a contagem vai à frente do braço por causa da rampa, então o
> tracejado piscava a cada viagem. Alarme que toca em condição normal
> ensina a ignorar alarme.
>
> Quem compara comandado com medido agora é a **régua do rodapé**, que
> mostra os dois números lado a lado, e o **aviso de desvio** da saúde da
> máquina, que conta e denuncia sem precisar de ninguém olhando.

> **E o comandado não decide para onde o braço vai.** "Ir para o zero" e
> "ir para um ângulo" mandam um destino absoluto **em pulsos**, calculado
> sobre a contagem. Com a contagem adiantada do braço, mover a contagem
> até o alvo deixava o braço parado no tanto do erro. Por isso a contagem
> é **ancorada no encoder antes** de o destino ser calculado, e a máquina
> diz em que conta o movimento saiu. Ver `ACHADOS.md`, R147 e R153, e os
> cenários **V25** e **V26**.

Sem leitura confiável (encoder desligado, cabo solto, leitura fora do
curso) o boneco **congela** na última postura que de fato foi medida —
nunca volta a seguir o comandado. Passo perdido, folga do redutor ou uma
escala mal medida não aparecem no comandado; só aparecem no braço de
verdade, que é o que o encoder vê, e desenhar pelo comandado escondia
justo o caso em que mostrar a diferença importa. A legenda do rodapé diz
qual dos três estados vale: medido, "sem leitura ainda" (nunca mediu) ou
"última posição medida" (mediu, perdeu a leitura agora).

A área da mesa ensinada aparece nas duas vistas, tracejada.

**O 3D também mudou por dentro.** A ordem de desenho era fixa — base, elo
1, cotovelo, elo 2 — e com o cotovelo dobrado *para trás* o elo 2 era
pintado por cima do elo 1 mesmo estando atrás dele na cena. O braço saía
recortado errado em metade das posturas, e era isso que fazia o desenho
parecer quebrado. Agora cada peça declara a profundidade do seu ponto
médio e o conjunto é pintado do fundo para a frente. As caixas dos elos
ganharam tampa nas pontas e as laterais também são ordenadas.

> O achatamento vertical do 3D é **exagero declarado**: um braço de 850 mm
> de alcance tem 110 mm de altura, e na proporção real ele sai achatado a
> ponto de não se ler qual elo passa por cima de qual. O exagero é só no
> Z — X e Y saem na escala.

### 5.3 Mesa de traçado

Vista de cima, em milímetros de verdade. Mostra o braço, o alcance, o
curso calibrado, o programa e a trajetória gravada.

> **Tocar na mesa não move o braço.** O único efeito de um toque é
> **escolher o eixo**: tocando num elo, aquela junta passa a ser a
> selecionada. Existiram aqui um botão `IR` (ligado, o toque mandava a
> ponta até o ponto tocado) e um `DES` (riscar o caminho com o dedo);
> os dois saíram a pedido de quem opera. Levar o braço a um lugar se faz
> pelas setas e por "ir para um ângulo", que dizem para onde vão **antes**
> de ir; o caminho se ensina por pontos gravados ou importando um DXF.

**Explicações ocultáveis** (botão `?` no cabeçalho): as notas em cinza
ensinam quem está começando e atrapalham quem opera todo dia — elas
ocupam mais coluna que os controles. O `?` esconde todas de uma vez, os
controles ficam, e a escolha é gravada.

**Vista 3D** (botão `3D`): a mesma máquina de outro ângulo, com a altura
dos elos e a ferramenta descendo até a peça. Serve para enxergar a
máquina; **escolher pontos continua na vista de cima**, porque
um traço em perspectiva não tem onde cair na mesa.

### 5.4 Programa de pontos

Até **120** pontos. Entre dois pontos, o trecho é:

- **cordão** — reta cartesiana interpolada a cada 1,5 mm, com a solda
  ligada;
- **deslocamento** — interpolação nas juntas, mais rápida, sem solda.

O sistema **recusa** cordões que o braço não consegue percorrer e diz
qual trecho e por quê — inclusive quando o ponto é alcançável mas o
*caminho até ele* não é.

> O ramo do cotovelo é **travado por segmento**. Sem isso a cinemática
> inversa reescolhia o cotovelo a cada 1,5 mm e o braço fazia uma
> circunferência no meio da reta. Está em `ACHADOS.md`, achado A13.

### 5.4.0 Mão livre: os dois modos de ensinar

Aba **Mão livre**. A única função em que o operador **ensina** em vez de
digitar: solta o braço, leva a ponta com a mão e a máquina guarda o
caminho. Os dois modos não diferem em conforto, diferem em o que
conseguem guardar.

| modo | o que grava | quando usar |
|---|---|---|
| **Por pontos** | os vértices; entre eles a ponta anda em **reta** | o caminho que se edita depois, ponto a ponto |
| **Contínuo** | o percurso inteiro, amostrado enquanto o botão está pressionado | curva, contorno, forma livre — o que não cabe em vértices |

**A tecla `G` marca o ponto.** Com o braço solto as duas mãos estão nele,
e alcançar o mouse é justamente o gesto que move a ponta que se acabou de
posicionar. A tecla vale só com esta aba aberta, e nunca dentro de um
campo de digitação.

**No modo contínuo se SEGURA para gravar.** Com um botão para começar e
outro para terminar, o operador tem de largar o braço para encerrar — e o
último pedaço do caminho sai a mão dele voltando para a tela. Segurando, a
gravação acaba onde a mão acaba.

> **Reta precisa de dois eixos.** Entre dois pontos a ponta anda em linha
> reta, com arco ou sem — num caminho ensinado à mão, quem levou o braço
> quase sempre desviou de alguma coisa, e uma curva passaria por fora do
> que ele mostrou. Um trecho cujo **meio** saia da área alcançável é
> recusado na partida, em vez de o braço dar a volta por fora.
>
> Com **uma junta só**, porém, a ponta não tem como andar em reta: o único
> caminho que existe é o arco que ela descreve. Ali o movimento volta a ser
> a interpolação nas juntas — e é o mesmo critério que valida e que executa.

**Com um eixo só funciona.** Uma junta que não está no barramento não tem
peso próprio para cair nem contagem para desencontrar: o braço solta, os
pontos gravam com 0 naquela junta, e a reprodução move o eixo que existe.
A proteção continua inteira onde ela tem sentido — junta que **está** no
barramento e ninguém mede segura o torque, e a tela diz qual é.

### 5.4.1 Modo aprendizado: ensinar o caminho com a mão

Módulo `aprender.h/.cpp`. Um botão físico na ponteira (GPIO 32) com dois
gestos, e o mesmo modo disponível na tela para quem não instalou o botão.

| gesto | o que faz |
|---|---|
| **segurar 1,5 s** | entra ou sai do modo aprendizado |
| **toque curto** | grava o ponto onde a ponta está agora |

Dentro do modo, se der para soltar o braço, o torque cai e você leva a
ponteira com a mão: encosta no início do cordão e toca, leva até o fim e
toca. O programa nasce da peça, não da tela.

**O que faz isso ser possível.** Motor solto anda sem que nenhum pulso
saia no fio — a contagem do firmware ficaria parada e todo ponto sairia
gravado no mesmo lugar. Quem resolve é `seguirEixoSolto()`
(`correcao.h`), que acerta a contagem pelo encoder absoluto enquanto o
braço está solto. É por isso que o modo depende do encoder, e não de
mais um sensor.

**Quando o braço NÃO é solto.** Só quando as duas juntas estão no
barramento com o zero absoluto ensinado. O habilita é um comando só para
os dois drivers: soltar por causa da junta 1 solta a 2 junto, e uma junta que
cai sem ninguém medindo grava ponto torto sem avisar. Faltando isso o
modo entra assim mesmo, com torque — você posiciona pelas setas e grava
igual. A tela diz qual dos dois está valendo.

**As regras duras:**

1. Só a partir do modo `MANUAL` e com o braço parado. **Calibração não é
   exigida**: um ponto gravado é um par de contagens na mesma régua com
   que será perseguido.
2. O arco é desligado ao entrar. Ninguém ensina caminho soldando.
3. Sair do modo manual (executar, reproduzir, calibrar, falha) encerra o
   aprendizado. O botão vermelho também.
4. **O torque não volta sozinho na saída.** Habilitar servo é ação
   explícita do operador em todo o resto do sistema, e aqui — com a mão
   dele dentro da área do braço — mais ainda.
5. Botão preso desde o boot não vale como gesto: sem isso um fio em
   curto soltaria o braço na hora de ligar.
6. Contato mecânico repica; o filtro de 40 ms garante **um toque, um
   ponto**. Sem ele um toque viraria meia dúzia de pontos, e o operador
   só descobriria na hora de soldar.

> Com o braço solto ele desce pelo próprio peso. Apoie a ponta antes de
> entrar no modo.

Banco de testes: cenários **P01 a P06** (o gesto, o repique, o toque
fora do modo, o botão preso no boot, o caso sem encoder, o que encerra o
modo, e a mesma coisa pela tela) e **M05** (quando a contagem segue o
eixo movido à mão — e quando não segue).

### 5.4.2 Produção: pausa, repetição, contagem e desfazer

O que separa um braço de bancada de um equipamento de produção não é
precisão — é o que acontece na centésima peça.

**Pausar** (`progPausar`) guarda em que trecho e **a que fração dele** o
cordão parou, e retomar continua dali em vez de refazer por cima do que
já foi soldado. O arco **fecha** na pausa, sempre: arco aberto com o
braço parado fura a chapa em segundos, então não existe pausa "segurando
o arco". Ao retomar ele reabre com o mesmo tempo de abertura do início de
qualquer cordão, porque a poça esfriou. Cenário **Q01**.

**Mais uma peça** (`/api/prog/repetir`) roda o mesmo programa sem
reabrir o arquivo. É o caso normal de produção, e exige a mesma
confirmação do arco.

**Contador de peças** (`Producao`, em `estado.h`), gravado em NVS:

| | |
|---|---|
| peças prontas | execução **com arco** que chegou ao fim |
| interrompidas | execução com arco parada no meio |
| tempo de arco | segundos de arco aberto acumulados — é o número que diz quando trocar bico e difusor |
| desde a manutenção | zerado pelo botão **Registrar manutenção feita** |

Ensaio **não** conta: não gasta consumível nem produz peça. Cenário
**Q02**.

**Desfazer** (`progDesfazer`), um nível, cobre o estrago que não tem
volta pela tela: apagar um programa de trinta pontos ensinados à mão, ou
remover um ponto no meio de um cordão. Desfazer duas vezes volta ao que
estava — um Ctrl+Z apertado sem querer não pode deixar o operador pior do
que começou. Cenário **Q03**.

**Abrir o arco pede dois toques** na tela — *e* `conf=1` na requisição. A
tela pedir confirmação não protege nada se a rota abre o arco para
qualquer chamada, e ela é alcançável por qualquer coisa na rede da
máquina. Cenário **Q04**.

### 5.4.3 Biblioteca do cartão, com miniatura

A gaveta **Arquivos** tem **uma** lista, com programas e trajetórias
juntos: um campo de nome, um **Salvar** e as linhas do cartão, cada uma
com a etiqueta do seu tipo. O tipo é informação de conferência, não uma
decisão a tomar antes de começar.

O que o **Salvar** vai gravar se decide sozinho quando a máquina só tem
uma das duas coisas — e só aparece como escolha na tela quando ela tem
as duas ao mesmo tempo.

Cada programa do cartão tem um botão **ver**: ele lê
o arquivo para uma área de troca e **desenha** a peça — cordões em linha
grossa, deslocamentos tracejados — sem tocar no programa que está na
máquina. Ver a peça errada é barato; abrir a peça errada custa uma
chapa.

A miniatura também acende o **aviso de peça errada**: um programa feito
com outros comprimentos de elo aponta para outro lugar da chapa com os
mesmos ângulos, e o aviso mostra os dois pares de números.

### 5.5 Leitura do encoder

Aba/coluna **Encoder**. No computador ela fica **aberta o tempo todo** ao
lado da mesa: a leitura existe para ser acompanhada *enquanto* se mexe no
resto. No celular volta a ser aba.

Mostra: comandado, medido, erro, velocidade, RPM, sentido, passos
andados, inversões, faixa percorrida, gráficos de erro e de posição,
tabela das amostras e **CSV** com a janela inteira.

Ferramentas de diagnóstico embutidas:

| | |
|---|---|
| **quadro cru** | os bytes que saíram e voltaram, em hexadecimal |
| **Testar a linha agora** | eco no MAX485 + sondagem do driver, *dentro* do sistema rodando |
| **Procurar o registrador** | acha o par da posição movendo o braço duas vezes no mesmo sentido |
| **Voltar aos padrões medidos** | desfaz configuração antiga herdada do NVS |

O diagnóstico sai **também no monitor serial**, uma linha a cada 5 s
enquanto falha.

#### A leitura que teleporta

Um quadro pode passar no CRC e ainda assim não ser o eixo: palavra baixa
de um instante casada com a alta do seguinte, contador dando a volta,
corrupção que calhou de fechar a conta. Chegam como um inteiro
perfeitamente plausível — o que os denuncia não é o valor, é a
**distância até a leitura anterior**.

Obedecer é caro, porque essa leitura vira tudo: o desenho salta, a
contagem de passos é reescrita com o número errado e o movimento seguinte
arranca de um lugar onde o braço nunca esteve.

Então a leitura passa por um limite de **velocidade**: no máximo 3 voltas
de motor por segundo de variação, medidas sobre o intervalo real entre as
amostras (com um piso, para o barramento poder atrasar uma resposta). Em
voltas de motor, e não em graus de junta, o limite não depende da redução
configurada — que é justamente uma das coisas que podem estar erradas.

**Mas um salto não é descartado de cara.** Alguém empurrando o braço com
a mão produz uma variação igualmente grande, e verdadeira — recusá-la
deixaria a máquina cega na hora em que ela mais precisa enxergar. O que
separa os dois casos não é o tamanho, é a **repetição**: o quadro
corrompido vem uma vez e o seguinte volta para perto; o eixo que foi mesmo
para longe continua lá. Por isso o salto fica **pendente** e a amostra
seguinte decide — se confirmar, a posição é aceita e o custo total foi
uma amostra (50 ms); se voltar, era defeito e nada foi obedecido.

Essas recusas aparecem como **saltos** junto das outras na tela do
encoder. Saltos ocasionais são a proteção funcionando. Saltos constantes
são o barramento pedindo cabo, terminação ou aterramento — e aí veja
também a taxa de acerto em **Máquina → Saúde**.

#### A máquina mede a própria engrenagem

`passos por grau = pulsos por volta × redução / 360`. Os dois são **digitados**,
e o mais errado dos dois costuma ser o primeiro: pulsos por volta é parâmetro do
**drive**, muda quando alguém troca o drive ou refaz uma configuração, e nada na
tela denuncia. O sintoma é o braço passar do ângulo pedido — sempre pelo mesmo
fator.

O encoder mede esse número sozinho, e a conta dispensa a redução:

```
pulsos por volta = |pulsos| × contagens por volta / |contagens|
```

Os dois lados são por volta do **motor**, que é justamente onde o encoder está.
Entre o pulso e a contagem não há mecânica nenhuma, então nem folga nem redutor
entram — e não é preciso ter calibrado a máquina, nem saber a redução.

A medida acontece no fim de **todo movimento**, com o eixo parado e antes de
qualquer retoque. A máquina exige um décimo de volta do motor e 200 pulsos para
aceitar; abaixo disso a medida seria curta demais.

> **O primeiro movimento depois de instalar ainda passa do ponto.** É ele que
> carrega a medida — o assentamento traz o braço de volta e a régua fica certa.
> Do segundo em diante o braço cai no ângulo pedido sozinho. Se isso se repetir
> em todo movimento, o encoder não está sendo lido: veja a taxa de acerto em
> **Máquina → Saúde**.

A régua corrigida é gravada quando muda mais de meio por cento, então ela
sobrevive ao desligamento e converge em dois ou três movimentos.

### 5.6 Correção de posição pelo encoder

**O encoder é a posição.** O braço desenhado na tela é o desenho do
encoder: se ele diz 3°, o braço está em 3°. Pedir "ir para 3°" é ler onde
o braço está, andar a diferença e parar — **um tiro**.

Para o tiro acertar, `passosPorGrau` tem de bater com o ferro. Ele sai de
dois números digitados (`passosPorVolta × redução ÷ 360`), e o mais
errado dos dois costuma ser o primeiro: é parâmetro do **driver**, muda
quando alguém troca o drive, e nada na tela denuncia. Com ele errado por
um fator de dois, pedir 3° manda o braço a 6° e o assentamento o traz de
volta em passos de no máximo 3° — o braço vai, volta e hesita para fechar
três graus.

**A máquina mede esse número sozinha.** Todo movimento tem pulso contado
de um lado e voltas do motor do outro; a redução cancela na divisão. A
medida aparece na página Máquina, ao lado do campo, sempre que discorda
dele — e **quem escreve a régua é você**.

> **Por que ela não adota sozinha.** Foi tentado duas vezes. No fim de
> cada movimento, fazia o braço perseguir um destino que andava junto com
> a régua — *passa do ponto e nunca chega*. Com o braço parado, antes do
> movimento seguinte, foi pior: numa bancada com 7 % de falha no
> barramento, uma leitura **parada** enquanto o eixo anda produz uma
> engrenagem enorme, e régua enorme faz o braço **dar voltas** para um
> pedido de três graus. Duas medidas concordando não salvam: se a causa é
> leitura parada, as duas concordam no mesmo número errado.

#### A rampa leva o eixo, e o encoder confere

Ir a um ângulo são **três coisas em ordem**, e nenhuma delas adivinha nada:

1. **Ancorar.** Com o eixo parado, a contagem de passos é reescrita pelo que
   o encoder mede. Dali em diante ela descreve o braço, e não a soma dos
   pulsos que o firmware acha que emitiu.
2. **Uma rampa.** O destino em passos se calcula a partir dessa medida e sai
   um `moveTo()`: o gerador acelera, cruza, desacelera e para **exatamente**
   no passo comandado. A distância de frenagem é a biblioteca que calcula —
   não há nada a inventar aqui.
3. **Assentar.** Parado, o encoder diz onde o braço ficou de verdade, e o que
   sobrou fecha em retoques curtos e cada vez mais lentos.

##### O que isto substituiu, e por quê

Havia aqui uma **busca**: o eixo andava em velocidade constante e parava
quando a medida batia no alvo. Ela nasceu de um pedido legítimo —

> *"Não quero uma matemática complexa pra tentar acertar a posição, só quero
> que ele acerte."*

— e de uma propriedade real: não dependia de `passosPorGrau` estar certo.

Mas ela é um controlador **liga-desliga com sensor atrasado**, e isso não
para num ponto. O comando de parar só sai quando a medida diz que **já
passou**, e até a medida chegar o eixo andou. O excesso era assumido em
"cerca de um grau"; na bancada, com o barramento real, virava o vai-e-vem
que o operador descreveu. Não é defeito de ajuste — é o desenho. Nenhuma
constante conserta tempo morto.

E ela **cancelava a rampa**: `buscaDefinir()` mandava `runForward()`, que
descarta o alvo do `moveTo()` que acabara de ser programado. Os dois
controladores brigavam pelo mesmo eixo dentro do mesmo movimento.

A troca não é matemática complexa: é usar o `moveTo()` que a biblioteca já
calcula sozinha, e apagar a busca — **menos** código. É o mesmo mecanismo
que programa, DXF e trajetória sempre usaram, e não é de posicionamento que
ninguém reclama neles.

Medido no banco, cinco ângulos seguidos (3, 45, −30, 0 e 12,5):

| | erro final | passou do alvo | inversões de sentido |
|---|---|---|---|
| régua certa | **0,012°** | **0,000°** | **0** |
| régua errada por 2×, da 2ª viagem em diante | **0,012°** | **0,000°** | **0** |
| régua errada por 2×, **na 1ª viagem** | 0,048° | 3,05° (o freio pega) | 2 |

Cenário **V29**. A primeira viagem é contada à parte de propósito: antes de
andar, a máquina não tem como saber que a régua digitada está errada — a
razão entre passo e grau só aparece depois de um percurso. O que fica preso
é que **isso não se repete** depois que ela se mediu.

#### O freio de fuga: a rede, não a lei de controle

Com `passosPorGrau` muito errado o destino em passos cai longe do ângulo
pedido, e a rampa levaria o eixo até lá sem hesitar. Era esta a propriedade
boa da busca, e ela continua de pé — por outro caminho.

Enquanto o braço anda, a cada ciclo:

```
a medida passou do alvo, no sentido da viagem, em mais de 1,0°?
   isso se confirmou em DUAS leituras NOVAS seguidas?
                                        então para, pela rampa.
```

Não há ganho, não há velocidade escolhida ali, não há alvo sendo reescrito.
Quem leva o eixo continua sendo o `moveTo()` programado na largada; o freio
só pode **encurtar** a viagem, nunca redirecioná-la.

> **As duas confirmações são o conserto do "para do nada".** A busca decidia
> por **uma** amostra: bastava um quadro corrompido que passasse pelas
> guardas e caísse além do alvo para ela mandar parar, e o braço congelava
> onde estivesse, num ponto aleatório. Um glitch não se repete; um destino
> errado se repete. Cenário `W05`.

A margem de 1,0° existe para o freio **nunca** encostar num movimento
saudável: com a régua certa a rampa para no alvo sem nunca passar dele, e o
freio termina a viagem sem ter feito nada — que é como ele deve terminar
quase sempre.

E ele não age calado: ao chegar, a tela diz *"Posicionado — mas o encoder
teve de FREAR a viagem"*. É a única pista, no instante em que acontece, de
que `passosPorVolta` está errado.

#### O fator da régua: dois usos da mesma medida

`passosPorGrau` errado escala **tudo** — a distância (pedir 40 graus anda
160) e a velocidade (pedir 12 °/s anda 48). O encoder mede a **junta**,
então ele é o único que sabe a verdade.

No fim de cada viagem a máquina faz **uma** conta: quantos graus a régua
mandou andar, contra quantos graus o encoder mediu. A razão entre os dois é
o exagero da régua.

**Uma conta por viagem, e não uma por leitura.** A viagem dura segundos e usa
as duas pontas; medir dentro de uma janela de 217 ms usa dois números
vizinhos e ruidosos, e dá um resultado diferente a cada vez.

Três detalhes decidem se ela funciona:

- **as duas pontas se tomam com o eixo parado.** Uma leitura de 217 ms atrás
  conta onde a junta *estava*. Parado isso não importa; a 48 °/s importa dez
  graus;
- **o teto vale no resultado, nunca na medida.** O ruído de uma régua *certa*
  cai dos dois lados de 1; travando um dos lados, só o outro entra na conta e
  o fator desce sozinho viagem após viagem;
- **a primeira medida entra inteira**, as seguintes pela metade. Antes de
  andar, o 1,0 não é conhecimento — é a suposição de que a régua está certa.

Dessa medida saem **dois** números, com limites diferentes porque servem a
coisas diferentes:

| | onde entra | limites | o que resolve |
|---|---|---|---|
| `govFator` | na **velocidade** | ≤ 1,0 (só segura) | régua grande demais fazia o eixo sair no talo |
| `Junta.fatorEscala` | na **distância** | 0,25 a 4,0 | é o que faz a rampa cair no ângulo pedido |

O teto de 1,0 do primeiro é deliberado — ele só pode conter o eixo, nunca
acelerá-lo. Para a distância isso não serve: régua **menor** que a real faz o
braço andar de menos, e ali o fator precisa passar de 1. Cenário `W06`, com a
régua quatro vezes menor: a primeira viagem chega pelo assentamento e mede
`fatorEscala = 4,0`; a terceira cai no ponto com **zero** retoques.

> **Por que isto não é a adoção automática que já deu errado duas vezes.**
> Ela reescrevia `passosPorVolta`, mudando **todos** os ângulos da máquina
> por baixo dos limites e dos pontos gravados; media a cada leitura, dentro
> de uma janela de 217 ms, onde uma leitura parada com o eixo andando produz
> uma engrenagem enorme; e o teto que havia era 200 vezes o valor real.
> Este fator multiplica **um deslocamento**, uma vez, naquele movimento; sai
> de uma conta por viagem entre duas pontas com o eixo parado; e acima dele
> está o freio de fuga — mesmo no teto, o eixo para quando a medida diz que
> passou.

O fator é **persistido**, porque a régua da máquina também é: sem isso o
primeiro movimento depois de cada boot repetiria o erro inteiro. E ele
**cai sozinho quando alguém corrige `passosPorVolta`** — corrigir a régua é o
conserto de verdade, e um fator sobrevivente passaria a compensar um erro que
acabou de deixar de existir.

> **A tela avisa.** Quando qualquer um dos dois sai de 1, a página de Encoder
> passa a dizer, em destaque, quantas vezes a régua digitada está fora e em
> que percentual o eixo está sendo segurado ou corrigido. O firmware contém o
> estrago; quem escreve `passosPorVolta` é uma pessoa.

#### O ritmo do barramento

Corrigir o eixo **enquanto ele anda** a partir de uma medida só converge se a
próxima medida chegar a tempo de mostrar o resultado. Num barramento lento a
máquina age, o eixo anda, e só muito depois ela vê onde parou.

Com a rampa levando, isso deixou de importar durante o voo: o encoder é usado
na **largada** (ancorar) e na **chegada** (assentar), e não entre as duas. É a
arquitetura que menos depende do cabo.

O assentamento só age com o eixo **parado**, e já espera uma leitura nova de
depois da parada — uma leitura a cada 100 ms é de sobra para quem precisa de
uma. Ele **não** é mais gateado pelo ritmo.

> **Isto já esteve errado, e de um jeito difícil de ver.** O portão exigia 10
> leituras por segundo. Mas o ciclo de leitura pergunta a **uma junta por
> vez**, com o intervalo valendo para o ciclo inteiro: com as duas juntas
> ligadas, cada uma é lida a cada **dois** períodos, mais a transação Modbus.
> A máquina de duas juntas não conseguia satisfazer o próprio portão com
> nenhum período confortável — e dizia *"barramento lento"* sobre um
> barramento saudável, deixando o braço onde a rampa o largou. Com um driver
> só o ritmo cabia; era por isso que o defeito aparecia depois de ligar o
> segundo. Cenário `W03`.

O ritmo **medido pelo firmware** — com as falhas incluídas, e não o período
configurado — agora aparece na aba Encoder como *"ritmo real"*, por junta,
com a palavra *lento* ao lado quando passa de 100 ms. É esse número que
descreve o barramento, e não o que está digitado no campo.

> Um barramento a 4,6 leituras por segundo é um problema de bancada, não de
> firmware: cabo, terminação de 120 Ω nas duas pontas, ou aterramento. O que
> o firmware faz é não depender dele mais do que precisa.

Cenário **V30**: com o barramento a 217 ms, o braço para em 45,000° com
**zero** inversões e **zero** retoques.

### O assentamento fecha o que a rampa deixou

Chegando o braço, o encoder diz onde ele **realmente** parou e o sistema dá
um retoque curto no que sobrou.

> **Ele vale para as duas juntas, sempre.** Havia aqui uma exceção: a junta
> que a busca tivesse levado era dada como chegada, qualquer que fosse o
> erro. Fazia sentido enquanto a busca existia — duas malhas discutindo pelo
> mesmo eixo eram o vai-e-vem —, mas custava caro: no caminho "ir a um
> ângulo", que era o único que buscava, o assentamento ficava **desligado por
> construção**. Quando a busca desistia, ninguém fechava o resto, e a máquina
> ainda escrevia *"Posicionamento concluído"* com o braço fora do ponto.
> Agora quem leva o eixo é a rampa, que não é malha nenhuma: ela para onde
> foi mandada, e o assentamento não tem com quem discutir.

**Não é malha fechada de servo.** Cada leitura Modbus custa 5 a 20 ms com
jitter — corrigir o eixo *enquanto ele anda* faria o braço oscilar. É
assentamento no fim do movimento, e é isso que resolve o incômodo real:
*sair de uma posição e voltar cair no mesmo lugar*.

Duas coisas fazem isso funcionar de verdade:

1. **O erro se mede contra o alvo, não contra o comandado.** O comandado
   sai da contagem de passos, e a contagem anda junto com o retoque:
   medir contra ela daria sempre a mesma diferença e o retoque nunca
   fecharia.
2. **No fim, a contagem volta ao alvo** (sem emitir pulso). Sem isso o
   desvio não some — ele só muda de lugar, e o próximo movimento absoluto
   nasce errado pelo mesmo tanto.

**Oito regras, todas com cenário no banco de testes:**

| | |
|---|---|
| 1 | só com o eixo **parado** |
| 2 | só com leitura **válida e recente** |
| 3 | nunca fora do curso — **quando o limite está ligado** |
| 4 | **nunca com a solda ligada** |
| 5 | erro grande se fecha **em passos**, nunca de uma vez |
| 6 | insiste enquanto **aproxima** |
| 7 | a chegada é **suave** |
| 8 | o retoque **aprende a escala** da própria máquina |

As regras 5 e 6 já foram outra coisa, e a troca vale explicar. Elas
diziam "erro acima do teto não se corrige, se denuncia" e "no máximo
três tentativas". A intenção era boa — vários graus de erro não é folga,
e empurrar o braço achando que está consertando é a maneira mais rápida
de bater a ferramenta. Só que **recusar deixava o braço parado no tanto
do erro**, que era exatamente o defeito: pedia-se zero grau e quem
chegava era a contagem, não o braço.

Hoje o teto é o tamanho de **um passo**: cada retoque anda no máximo
`maxCorrecaoGraus`, relê o encoder e repete. O braço nunca lança vários
graus de uma vez — e o erro fecha assim mesmo. E o que denuncia
acoplamento solto deixou de ser um número de tentativas: é o retoque
**não diminuir o erro**. Enquanto cada passo aproxima pelo menos 15%,
continua; parou de aproximar, desiste e diz.

A regra 8 é a que resolve "chega perto, passa do ponto e não volta". O
retoque anda em **pulsos** (graus ÷ `passosPorGrau`, do catálogo), mas o
erro é medido em graus do **encoder**. Quando as duas réguas discordam —
e discordar é o normal antes de calibrar — pedir "ande 2 graus" faz o
eixo andar 4: passa, volta passando, e o assentamento desiste. Não há por
que adivinhar essa razão: **o retoque anterior a mede**. Pediu tanto, o
encoder andou tanto; o seguinte já sai dividido por ela e cai no ponto. O
ganho é propriedade da máquina, então o segundo posicionamento já nasce
certo.

Se o eixo simplesmente não seguir, o assentamento nem chega a rodar: o
**vigia de travamento** pega antes (comando andando, medido parado) e
para o eixo dizendo qual junta. Esse vigia exige **duas coisas** para
acusar: o pulso claramente correndo **e** o encoder claramente parado.
A conta proporcional (que compara o esperado com o medido) só *refina* —
ela pega escorregão parcial, mas nunca inventa um travamento sozinha.
Fazia: dividindo pelo catálogo e comparando com o medido, uma régua
discordante transformava braço andando em braço travado meio segundo
depois de arrancar. Ver `ACHADOS.md`, R156, e o cenário **M09**.

Ajustes: tolerância (0,10° de fábrica), tamanho do passo do retoque
(3°), aviso de desvio (1°), tentativas sem progresso (3). Tudo
desligável.

**Vigilância**: com o eixo parado, se o erro passar do limite por mais de
um segundo, o painel avisa. Não mexe no motor — só conta e avisa.

**Leitura de ângulo na tela.** A régua do topo mostra, para cada junta,
o ângulo **comandado** (a conta de pulsos do firmware) e logo abaixo o
**medido** pelo encoder, com a diferença. Abaixo de 0,5° a diferença fica
discreta — é o tremor normal de um encoder de 17 bits; acima disso fica
vermelha. É o que transforma "acho que está em 30 graus" em "está em
30,12 graus", e o que denuncia um desvio antes de ele virar peça torta.

**Braço movido à mão** (`seguirEixoSolto()`): com o torque **desligado**
o braço está solto e o encoder é a única coisa que sabe onde ele foi
parar. A contagem é acertada pela leitura, e "movi com a mão" passa a
dar o mesmo resultado que "mandei ir".

> **Toda leitura passa por um teste de possibilidade física.** Nenhuma
> junta desta máquina está a 170 mil graus: leitura além de **720°** é
> defeito de configuração (registrador do vizinho, contagens por volta
> erradas, 32 bits trocado) e nunca vira posição. Esse teto vale sempre,
> calibrado ou não. Sem ele, uma leitura errada virava a posição oficial
> da máquina e o "ir ao zero" mandava um curso inteiro de pulso contra o
> batente. Ver `ACHADOS.md`, R78 e R103, e os cenários **T01** e **V12**.
>
> **O curso medido só confere quando o limite está ligado.** Enquanto o
> limite de curso é opção desligada, o braço anda livre pela mesa — e
> leitura fora da faixa medida é leitura *boa* de um lugar onde o braço
> legitimamente está. Conferir assim mesmo produzia o pior defeito
> possível: uma calibração abortada, com quatro graus de faixa, calava o
> encoder da máquina inteira — sem reancoragem, sem seguir o braço à
> mão, sem assentamento, e com o desenho congelado. Ligado o limite, a
> conferência volta (10° de folga para o batente) e a leitura de fora é
> denunciada com o número. Ver `ACHADOS.md`, R143, e o cenário **V24**.

> **Só com o torque desligado.** Com servo ligado o motor segura a
> posição: se o eixo saiu do lugar mesmo assim, isso é **perda de
> passo**, não movimento à mão. Seguir a contagem ali esconderia o
> defeito e o assentamento nunca traria o braço de volta — seria trocar
> uma correção por um disfarce. Cenário **M05** do banco.

### 5.7 Solda

Relé com proteções: não liga sem servos, não fica ligado com o braço
parado por engano, e a parada de emergência corta o arco antes de
qualquer outra coisa.

### 5.8 Cartão SD

Programas, trajetórias e cópias de configuração. Tarefa própria no núcleo
0. Ver [`CARTAO_SD.md`](CARTAO_SD.md).

### 5.9 Rede

A máquina **cria** a rede `Robo2dof`. Não entra na rede de ninguém, não
procura roteador, não fala com a internet.

| Como chegar | |
|---|---|
| IP | `192.168.4.1` |
| Nome | `robo2dof.local` (precisa de mDNS/Bonjour no Windows) |

Ao entrar na rede, **o painel abre sozinho**: as sondas de captive portal
do Windows, Android e iPhone levam redirecionamento para 192.168.4.1.

---

### 5.10 Apagar tudo, e o que ele não apaga

Na gaveta, página **Sistema**, cartão *Apagar tudo*. São **dois botões no
mesmo cartão**, de propósito — a diferença entre eles é a instalação
inteira, e o operador precisa vê-los lado a lado antes de escolher.

| | apaga | não apaga |
|---|---|---|
| **Restaurar padrões** | velocidades, aceleração, resolução, medidas dos elos, proteções | calibração, mesa ensinada, zero absoluto, encoder |
| **Apagar tudo** | a memória interna **inteira** — inclusive calibração, mesa, zero, encoder e contadores | o cartão SD |

**Apagar tudo limpa o espaço de NVS inteiro e reinicia a placa.** Limpar o
espaço, em vez de reescrever chave por chave, é o que faz sumir também
uma chave deixada por uma **versão anterior** do firmware — que é
exatamente o tipo de resíduo que ninguém lista e ninguém encontra.

Reinicia porque metade das variáveis vivas só nasce no `setup()`: zerar o
NVS sem reiniciar deixaria a RAM com a configuração velha e o NVS vazio,
um terceiro estado que ninguém pediu. Antes de reiniciar, o comando
**desliga o torque** — reiniciar com o eixo energizado deixa o driver
sozinho por um segundo.

**O cartão SD não é tocado.** As peças salvas são trabalho seu, não
configuração da máquina; um botão de reset que levasse junto meses de
programa gravado seria uma armadilha. Apagar peça continua sendo na aba
Arquivos, uma a uma.

Para confirmar é preciso **digitar a palavra APAGAR** — não basta um
toque. Toque errado na tela acontece; digitar APAGAR por engano, não. A
rota exige o texto de novo (`conf=APAGAR`): a tela pode ter um defeito, a
porta não pode confiar nela. Só funciona com o robô parado no modo
manual.

Depois de apagar, **o braço opera sem proteção de curso** até ser
calibrado de novo. Antes de
trabalhar.

### 5.11 Máquina: saúde, registro, conexão, firmware e idioma

Aba **Máquina**.

### Saúde (`GET /api/saude`)

Uma tela só com tudo que se pergunta quando algo está estranho: há quanto
tempo está ligada, peças prontas e interrompidas, tempo de arco,
memória, ocupação da partição, cartão, travamentos, e — o mais
útil — a **taxa de acerto** de cada encoder. 100% é barramento saudável;
60% não é "meio quebrado", é cabo, terminação ou aterramento, e vai
piorar.

Antes disso, a resposta a "está tudo bem?" era abrir o monitor serial com
um cabo — que só existe na bancada, nunca na fábrica.

### Registro de eventos (`GET /api/registro`)

As últimas 24 linhas saem de um **anel na RAM**, então funcionam sem
cartão — que é justamente quando a pergunta "o que aconteceu?" é feita. O
registro completo continua indo para `/log/s####.csv` no cartão.

### Conectar (QR)

Dois códigos: o primeiro entra na rede Wi-Fi da máquina (formato
`WIFI:...`, lido por Android e iPhone), o segundo abre o painel.

O gerador de QR é **próprio** — a máquina não tem internet, então CDN não
é opção — e é conferido por `testes/conferir_qr.py`, que renderiza os
códigos e os **lê de volta com um decodificador de verdade**. Um QR
desenhado errado fica quadradinho e bonito e não abre em celular nenhum;
nenhuma inspeção visual pega isso.

### Atualizar o firmware (OTA)

> **Limite real.** O `partitions.csv` deste projeto dá 3 MB de app e
> **não tem partição de OTA**. Gravado assim, o robô não tem para onde
> escrever a imagem nova, e o painel diz isso em vez de fingir.

Para ter OTA, grave **uma vez pelo USB** com `partitions_ota.csv` (duas
partições de 1,9 MB); daí em diante as atualizações vão pela rede. Não há
meio-termo: a imagem nova é escrita na partição que **não** está rodando.
Com uma partição só, gravar seria escrever por cima do próprio código em
execução — o processador trava no meio, com o relé de solda em estado
indefinido.

O `nvs` fica no mesmo lugar nos dois esquemas, então **a calibração já
salva continua valendo** depois de trocar de partição.

Antes de começar, o módulo desabilita os servos: o ESP32 reinicia no fim,
e um driver habilitado com o gerador de pulso morto é um eixo que ninguém
está comandando.

### Idiomas

**Português e inglês, e só. O padrão é português.** Traduz o que o
operador toca: abas, botões, rótulos, a tela de saúde e a tira de estado.
**As notas longas de explicação continuam em português** — elas são o
manual embutido desta máquina, escritas para quem a monta, e traduzir mal
um texto que explica por que o arco fecha na pausa é pior do que
deixá-lo como está.

> O **modo operador** foi removido. Ele escondia as abas de instalação
> atrás de uma senha que não era segurança de rede — quem está no Wi-Fi
> da máquina alcança a API direto — e obrigava toda tela a consultar mais
> um estado. As quatro páginas da gaveta ficam sempre à mão.

---

---

## 6. Rotas HTTP

Conferidas por `testes/conferir_rotas.py`, que reprova rota registrada e
nunca chamada, ou chamada e nunca registrada.

| Rota | |
|---|---|
| `GET /api/status` | tudo que a tela mostra, num JSON |
| `POST /api/jogxy`, `/api/jog` | comando manual |
| `POST /api/mover`, `/api/moverxy` | ir para ângulos / coordenada |
| `POST /api/parar` | parada |
| `POST /api/solda` | relé |
| `POST /api/prog/*` | programa de pontos |
| `POST /api/traj/*` | trajetória a mão livre |
| `POST /api/calib/*` | as quatro marcas da calibração |
| `POST /api/config` | parâmetros da máquina |
| `POST /api/config/reset` | restaura os **parâmetros** de fábrica |
| `POST /api/apagar/tudo` | apaga a memória interna inteira e reinicia — exige `conf=APAGAR` |
| `POST /api/sentido` | inverter o sentido de um eixo |
| `POST /api/referenciar` | zerar a máquina na posição atual |
| `GET  /api/encoder` | leitura, derivados, configuração e quadro cru |
| `POST /api/encoder/config` | ligação Modbus |
| `POST /api/encoder/padroes` | volta aos padrões medidos |
| `POST /api/encoder/testar`, `GET /api/encoder/teste` | autoteste da linha |
| `POST /api/encoder/cacar` | caçada do registrador |
| `POST /api/encoder/zerar` | zera a contagem aqui |
| `POST /api/correcao` | assentamento pelo encoder |
| `POST /api/travamento/ok` | limpa o aviso de travamento |
| `POST /api/zero/config` | o que fazer ao ligar a máquina |
| `POST /api/zero/ensinar` | ensina a referência absoluta de uma junta |
| `POST /api/zero/esquecer` | volta a ligar como antes |
| `POST /api/aprender` | entra/sai do modo aprendizado (`on=1`, `on=0`, `on=-1` alterna) |
| `POST /api/prog/pausar` | pausa (`on=1`) e retoma (`on=0`) o programa |
| `POST /api/prog/repetir` | mais uma peça — exige `conf=1` |
| `POST /api/prog/desfazer` | desfaz a última alteração do programa |
| `POST /api/prog/executar` | com `ensaio=0` **exige `conf=1`** |
| `POST /api/manutencao/ok` | zera o contador de peças desde a manutenção |
| `GET  /api/saude` | tudo que responde "está tudo bem?" |
| `GET  /api/registro` | as últimas linhas do log, da memória |
| `POST /api/ota` | envio do firmware (multipart) |
| `POST /api/sd/prever`, `GET /api/sd/previa` | miniatura de uma peça do cartão |
| `GET  /api/calibracao` | tudo da aba Calibração, num JSON |
| `POST /api/mesa/canto` | ensina um canto na posição atual da ponta |
| `POST /api/mesa/limpar` | apaga a área ensinada |
| `GET  /api/sd/*`, `POST /api/sd/*` | cartão |
| `GET  /api/rede` | por onde chegar no painel |

---

## 7. Bancos de teste

Duas suítes, ambas rodam no PC, sem hardware.

```sh
./testes/compilar.sh          # firmware de verdade, com mocks só no hardware
./testes/interface/rodar.sh   # a página num Chromium de verdade
```

O firmware **não é reescrito** para testar: os módulos de `Robo2dof/`
entram como estão. O que é substituído por mock é só o que depende de
hardware — e a regra é dura:

> **A assinatura do mock é a assinatura do core, não a conveniente.**

Um mock que aceita mais que a biblioteca de verdade deixa o banco passar
limpo e joga o erro na IDE do operador. Isso aconteceu, está registrado,
e a regra nasceu daí.

O mock do driver Modbus responde de verdade: CRC, ordem das palavras,
exceção, silêncio, driver que recusa pergunta dupla, e um eixo que
**gira entre as leituras**.

Guardas automáticas: `conferir_ligacoes.py`, `conferir_rotas.py`,
`gerar_pagina_gz.py --conferir`, e uma varredura que clica em **todo**
controle da interface.

---

## 8. Ferramentas de bancada

`ferramentas/` tem dois programas independentes, para gravar no lugar do
firmware:

| | |
|---|---|
| [`teste_rs485/`](ferramentas/teste_rs485/) | diagnóstico do barramento: autoteste do módulo, procura o driver, varre registradores, **caça o registrador da posição**, mede as contagens por volta, CSV |
| [`monitor_encoder/`](ferramentas/monitor_encoder/) | monitor ao vivo: posição, velocidade, RPM, sentido, passos, gráfico ASCII, CSV |

Eles rodam com o ESP32 **sozinho** na placa. É isso que separa "o
barramento não presta" de "algo no sistema atrapalha o barramento" — e foi
exatamente assim que se achou o defeito do DE.

---

## 9. Manutenção

### Editar a interface

Edite `Robo2dof/pagina_web.h` e rode:

```sh
python3 testes/gerar_pagina_gz.py
```

O banco reprova se o comprimido ficar velho.

### Gravar

Arduino IDE, placa ESP32 Dev Module, **Partition Scheme: Huge APP
(3 MB No OTA)**. O firmware avisa no boot se a partição estiver errada.

### Depois de gravar uma versão nova

Atualizar o firmware **não apaga o NVS**. Configuração gravada por uma
versão anterior continua valendo e ganha do padrão novo. Se algo parou de
funcionar depois de uma atualização, **"Voltar aos padrões medidos"** é o
primeiro a tentar.

### Quando o encoder não lê

Nesta ordem:

1. **Voltar aos padrões medidos** — o mais barato.
2. **Testar a linha agora** — a linha do `eco` decide: voltou = ESP32↔MAX485
   está bom e o problema é o barramento; não voltou = o problema nem
   chegou no par A/B.
3. Olhe o **quadro cru**: `(silencio)` = ninguém respondeu (fio A/B,
   DE/RE, endereço); bytes sem leitura = respondeu outra coisa (função ou
   registrador).
4. Grave `ferramentas/monitor_encoder` e veja se ele lê. Se ele lê e o
   sistema não, a diferença está no sistema.
