P3drOk/P3drOk/Robo2dof/correcao.cpp

#include "correcao.h"
#include "encoder.h"
#include "motores.h"
#include "cinematica.h"
#include "solda.h"
#include "programa.h"    // progDeslocarPassos(): a renumeracao anda com os pontos
#include "trajetoria.h"  // idem, para o que foi gravado a mao livre
#include "armazenamento.h"
#include <string.h>
#include <math.h>

// Tudo aqui roda no CORE 1, junto com o motor. E a regra de ouro do
// projeto: quem manda no motor e um nucleo so.

static ResumoCorrecao r;
static uint32_t esperaAte = 0;
// Onde o movimento pediu para parar. O retoque anda ALEM disso para levar
// o eixo ao lugar certo; no fim a contagem volta para ca, senao o desvio
// nao some -- so muda de lugar.
//
// GUARDADO EM GRAUS, e nao so em passos. O alvo tem de significar a mesma
// POSTURA do comeco ao fim do assentamento, e passo nao e uma unidade
// estavel: a maquina afere a propria engrenagem (ver aferirEngrenagem
// abaixo), e quando ela corrige a regua no meio do caminho, um mesmo
// numero de passos passa a descrever outro angulo. Recalcular o alvo a
// partir da contagem a cada ciclo movia o alvo junto com a regua -- o
// braco perseguiria um destino que anda.
//
// A contagem original fica junto so como rede: com regua invalida
// (passosPorGrau <= 0) nada se move mesmo, e devolver a contagem exata e
// mais seguro do que converter por uma escala que nao existe.
static long  alvo1Original = 0, alvo2Original = 0;
static float alvoGraus1 = 0.0f, alvoGraus2 = 0.0f;

// O ANGULO QUE O OPERADOR PEDIU, guardado quando o movimento comeca.
//
// Nao e a mesma coisa que converter a contagem de destino pela regua:
// com a regua errada os dois divergem, e quem manda e o que foi pedido.
// E dele que sai o freio do encoder.
static float  alvoPedido[2]  = {0.0f, 0.0f};
// O FREIO DE FUGA: o encoder para o eixo se o destino cair longe.
//
// Quem leva o braco a um angulo e a RAMPA -- moveTo() acelera, cruza,
// desacelera e para exatamente no passo comandado. Isso e exato quando
// passosPorGrau descreve a maquina, e e a unica coisa que para num ponto
// com um sensor que chega atrasado.
//
// Quando a regua digitada esta muito errada, porem, o destino em passos
// cai longe do angulo pedido, e a rampa levaria o eixo ate la sem
// hesitar. O freio e a rede embaixo disso: ele NAO corrige, nao tem
// ganho, nao decide velocidade. Ele so olha a medida e, se ela disser que
// o eixo passou do alvo com folga, manda parar pela rampa.
//
// E ele exige CONFIRMACAO. Uma leitura solta que pule alem do alvo nao
// pode parar o braco no meio do curso -- era isso, exatamente, o "para do
// nada em um ponto aleatorio": a busca decidia por uma amostra so.
static int8_t   freioSentido[2] = {0, 0};   // sentido da viagem, pela medida
static uint8_t  freioConfirma[2] = {0, 0};  // leituras seguidas dizendo "passou"
static uint32_t freioConta[2]   = {0, 0};   // contador de leituras ja visto
static bool     freioFreou[2]   = {false, false};

// AS DUAS PONTAS SO VALEM COM O EIXO PARADO.
//
// Uma leitura de 217 ms atras conta onde a junta ESTAVA. Com o eixo
// parado isso nao importa -- parado, o angulo de 217 ms atras e o de
// agora. Com o eixo andando a 48 graus/s, importa dez graus.
//
// Emparelhar a contagem de passos de AGORA com um angulo de 217 ms atras
// erra o percurso nos dois sentidos ao mesmo tempo: a regua parece ter
// andado menos e o encoder parece ter andado mais. Foi assim que a
// maquina "aprendeu" que a regua era oito vezes maior quando ela era
// quatro, e o braco passou a andar a 6,6 graus/s com 12 pedidos.
//
// Por isso a ponta de partida e tomada em correcaoAlvoPedido(), com o
// eixo ainda parado, e a de chegada so depois que uma leitura NOVA
// chegou com o eixo ja parado.
static float largadaGraus[2]  = {0.0f, 0.0f};
static long  largadaPassos[2] = {0, 0};
static bool  largadaValida[2] = {false, false};
static uint32_t contaNaParada[2] = {0, 0};
static bool     esperandoParada[2] = {false, false};
static uint32_t prazoAprender[2]   = {0, 0};

// O FATOR PERSISTE ENTRE OS MOVIMENTOS.
//
// Ele mede o quanto a regua da maquina exagera, e isso e propriedade da
// MAQUINA, nao do movimento. Guardado, a largada seguinte ja sai no
// ritmo certo -- inclusive quando a primeira leitura do movimento falha,
// que num barramento com 4% de falhas acontece.
static float govFator[2] = {1.0f, 1.0f};
// Se ja houve uma viagem longa o bastante para medir. Antes dela o 1,0
// acima nao e conhecimento, e so a suposicao de que a regua digitada
// esta certa -- e a primeira medida de verdade vale mais do que uma
// suposicao, entao ela entra inteira em vez de pela metade.
static bool govAprendeu[2] = {false, false};

// A MESMA MEDIDA, aplicada na DISTANCIA -- mora em Junta.fatorEscala.
//
// govFator[] segura a velocidade e e travado em 1,0 de proposito: ele so
// pode conter o eixo, nunca acelera-lo. Para a distancia isso nao serve --
// regua MENOR que a real faz o braco andar de menos, e ali o fator precisa
// ser maior que 1. Por isso sao dois numeros da mesma medida, com limites
// diferentes.
//
// Ele fica na Junta, ao lado de fatorVel e passosPorVolta, porque e
// propriedade da MAQUINA e nao deste modulo -- e e assim que ele
// sobrevive ao desligamento junto com o resto da regua. Sem isso o
// primeiro movimento depois de cada boot repetiria o erro inteiro.

static bool   temAlvoPedido  = false;

// Depois que o eixo para, a ultima leitura do encoder ainda e de antes
// da parada. O ciclo le a 20 Hz e o valor leva um tempo para assentar --
// retocar em cima de leitura de meio segundo atras e mover o braco
// baseado em onde ele estava.
static const uint32_t ESPERA_ASSENTAR_MS = 250;

static void dizer(const char* m) {
  strncpy(r.motivo, m, sizeof(r.motivo) - 1);
  r.motivo[sizeof(r.motivo) - 1] = '\0';
}

// ---------------------------------------------------------------------
// Quanto falta para o eixo chegar no ALVO, em graus, SE der para confiar.
//
// Repare que NAO se usa L.erro (comandado menos medido). O comandado sai
// da contagem de passos, e a contagem ANDA JUNTO com o retoque: medir
// contra ela daria sempre a mesma diferenca, o retoque nunca fecharia, e
// o eixo iria embora um pouco a cada tentativa. O alvo, ao contrario,
// esta parado -- e e nele que o operador quer o braco.
// ---------------------------------------------------------------------
static bool faltaPara(uint8_t junta, float alvoGraus, float& falta) {
  // NAO exige curso medido. O encoder mede a junta com ou sem
  // calibracao, e exigi-la aqui era o mesmo defeito de R143: uma junta
  // sem curso -- ou com um curso pela metade -- ficava sem assentamento
  // nenhum, e o braco parava onde o erro deixasse. leituraConfiavel()
  // cobre registrador, validade, idade e possibilidade fisica.
  if (!leituraConfiavel(junta)) return false;

  const LeituraEncoder L = encoderLer(junta);
  falta = alvoGraus - L.graus;   // graus da junta que faltam andar
  return true;
}

// Teto absoluto de retoques. Nao e criterio de qualidade -- quem julga
// isso e o progresso, logo abaixo. E so a garantia de que nenhum defeito
// novo consegue prender o core 1 num laco.
static const uint8_t RETOQUES_MAXIMOS = 40;

// Acima disto o retoque anda a meia velocidade; abaixo, proporcional.
static const float GRAUS_VEL_CHEIA = 3.0f;

// Maior |erro| do ciclo anterior, e quantos ciclos seguidos nao
// aproximaram. E o que separa "esta convergindo" de "esta martelando".
static float   erroAnterior = 0.0f;
static uint8_t semProgresso = 0;
// Quanto o passo anterior tinha COMO fechar, em graus medidos. E a regua
// contra a qual o progresso e julgado -- ver a Regra 6 la embaixo.
static float   fechavelAnterior = 0.0f;

// =====================================================================
//  O RETOQUE APRENDE A ESCALA DA PROPRIA MAQUINA
//
//  O retoque anda em PULSOS: graus de erro viram passos por
//  passosPorGrau, que sai do catalogo (pulsos por volta x reducao). O
//  erro, porem, e medido em graus do ENCODER. Quando as duas reguas
//  discordam -- e discordar e o normal antes de calibrar --, pedir "ande
//  2 graus" faz o eixo andar 4, ou 1. Ai o retoque passa do ponto,
//  volta passando do ponto de novo, e o assentamento desiste dizendo que
//  nao aproxima. Era o "chega perto, passa, e nao tem ajuste que
//  conserte".
//
//  Nao ha por que adivinhar essa razao: o retoque anterior a mede. Foi
//  comandado tanto, o encoder andou tanto -- a divisao e o ganho real da
//  maquina, do jeito que ela esta agora. O proximo retoque ja sai
//  dividido por ele e cai no ponto.
//
//  O ganho e propriedade da MAQUINA, nao de um movimento: sobrevive de
//  um posicionamento para o outro, entao o segundo ja nasce certo.
// =====================================================================
static float ganhoRetoque[2]   = {1.0f, 1.0f};
static bool  ganhoAprendido[2] = {false, false};
// COM QUE REGUA aquele ganho foi medido.
//
// O ganho e a razao entre graus PEDIDOS e graus ANDADOS, e o pedido sai
// em pulsos por passosPorGrau. Mude passosPorGrau e o mesmo eixo passa a
// andar outra coisa pelo mesmo pedido: o ganho guardado deixa de
// descrever a maquina. Sem isto ele so era esquecido em
// correcaoReiniciarTeste(), que so existe no banco -- ou seja, NUNCA em
// producao: um ganho medido uma vez num regime atipico governava todo
// retoque ate o proximo boot.
static float ganhoRegua[2]     = {0.0f, 0.0f};
static float retoquePedido[2]  = {0.0f, 0.0f};   // graus comandados
static float medidoAntes[2]    = {0.0f, 0.0f};   // encoder antes do retoque
static bool  temMedidoAntes[2] = {false, false};

// Enquanto o ganho nao foi medido, o retoque sai amortecido: passar do
// ponto custa outra viagem, e chegar em dois passos curtos e melhor que
// bater e voltar.
static const float AMORTECIMENTO_SEM_GANHO = 0.7f;
// Faixa em que um ganho medido e crivel. Fora dela a medida veio de
// ruido -- retoque curto demais, leitura tremida -- e nao vira regua.
static const float GANHO_MIN = 0.15f;
static const float GANHO_MAX = 6.0f;

static void esquecerGanho() {
  ganhoRetoque[0] = ganhoRetoque[1] = 1.0f;
  ganhoAprendido[0] = ganhoAprendido[1] = false;
  ganhoRegua[0] = ganhoRegua[1] = 0.0f;
  retoquePedido[0] = retoquePedido[1] = 0.0f;
  temMedidoAntes[0] = temMedidoAntes[1] = false;
}

// A REGUA MUDOU: o que foi medido com a antiga nao vale mais.
//
// Vale para as DUAS memorias que dependem dela -- o ganho do retoque e o
// fator de escala. As duas dizem "pedindo X, o eixo anda Y", e X so
// significa alguma coisa junto com passosPorGrau. Corrigir a regua e o
// conserto de verdade, e e a tela que pede que a pessoa o faca: um fator
// sobrevivente compensaria um erro que acabou de deixar de existir, e o
// braco andaria de menos exatamente pelo tanto que a regua melhorou.
//
// Conferido no comeco de todo movimento, e nao num gancho dentro de
// recalcularResolucao(): estado.cpp e a camada de baixo e nao pode passar
// a depender daqui. Assim tambem pega quem mexer na resolucao por
// qualquer caminho -- tela, calibracao, restaurar backup.
static void esquecerGanhoSeAReguaMudou() {
  for (uint8_t i = 0; i < 2; i++) {
    Junta& j = (i == 0) ? J1 : J2;
    if (ganhoAprendido[i] &&
        fabsf(j.passosPorGrau - ganhoRegua[i]) > 0.0001f) {
      ganhoRetoque[i]   = 1.0f;
      ganhoAprendido[i] = false;
      ganhoRegua[i]     = 0.0f;
      logEvento("junta %u: a resolucao mudou -- o ganho medido foi esquecido",
                (unsigned)(i + 1));
    }
    if (j.escalaAprendida &&
        fabsf(j.passosPorGrau - j.escalaRegua) > 0.0001f) {
      j.fatorEscala     = 1.0f;
      j.escalaAprendida = false;
      j.escalaRegua     = 0.0f;
      logEvento("junta %u: a resolucao mudou -- o fator de escala foi "
                "esquecido, e a proxima viagem mede de novo",
                (unsigned)(i + 1));
    }
  }
}

// Limita a MAGNITUDE de um retoque, guardando o sinal.
static float comTeto(float v, float teto) {
  if (v >  teto) return  teto;
  if (v < -teto) return -teto;
  return v;
}

// =====================================================================
//  A MAQUINA AFERE A PROPRIA ENGRENAGEM
//
//  `passosPorGrau = passosPorVolta x reducao / 360`. Os dois sao
//  DIGITADOS, e o mais errado dos dois costuma ser o primeiro: pulsos por
//  volta e parametro do DRIVER, muda quando alguem troca o drive ou refaz
//  uma configuracao, e nada na tela denuncia. O sintoma e o braco andar
//  mais (ou menos) do que a tela diz -- e, no fim de todo movimento,
//  passar do angulo pedido pelo mesmo fator, sempre.
//
//  E POR QUE A REDUCAO NAO ENTRA NESTA CONTA: o encoder esta no eixo do
//  MOTOR, antes do redutor. Pulso e contagem estao os dois do mesmo lado
//  dele, entao a reducao cancela:
//
//      passosPorVolta = |pulsos| x contagensPorVolta / |contagens|
//
//  Isso importa mais do que parece. Quer dizer que a maquina consegue
//  acertar a regua do movimento SEM calibracao guiada, sem transferidor e
//  sem saber a reducao -- que e justamente a situacao de quem so ligou a
//  maquina e mandou ir a um angulo. A reducao errada desloca as duas
//  leituras JUNTO (o encoder tambem divide por ela), entao o braco
//  continua chegando onde o operador pediu na escala que a tela mostra.
//
//  A conta nasceu na calibracao guiada, na viagem ao zero. So que essa
//  viagem so acontece em uma calibracao -- e a maquina do relato nunca
//  fez nenhuma. Agora ela e feita tambem no fim de qualquer movimento
//  comum, que e a mesma medida com outro nome: pulso contado de um lado,
//  voltas do motor do outro.
// =====================================================================
bool aferirEngrenagem(uint8_t junta, long dPasso, int32_t dCont) {
  if (junta != 1 && junta != 2) return false;
  const uint8_t i = junta - 1;
  Junta& j = (junta == 1) ? J1 : J2;

  const float cv = configEncoder.contagensPorVolta[i];
  if (cv < 1.0f) return false;

  const long  passos = labs(dPasso);
  const float voltas = fabsf((float)dCont) / cv;
  if (voltas < AFERIR_VOLTAS_MIN || passos < AFERIR_PASSOS_MIN) return false;

  const long novo = lroundf((float)passos / voltas);
  // Fora desta faixa nao e engrenagem: e leitura estragada, e obedecer a
  // ela reescreveria a regua da maquina inteira com lixo.
  if (novo < 100 || novo > 2000000L) return false;
  if ((uint32_t)novo == j.passosPorVolta) return false;

  const uint32_t velho = j.passosPorVolta;
  const float    rel   = velho ? fabsf((float)novo - (float)velho) / (float)velho
                               : 1.0f;

  // ELA MEDE E GUARDA. NINGUEM ADOTA SOZINHO.
  //
  // Aqui ela escrevia `j.passosPorVolta = novo; recalcularResolucao();`
  // -- no fim de cada movimento, DENTRO do ciclo de assentamento. E dai
  // vinha o "passa do ponto e nunca chega".
  //
  // O alvo do assentamento e congelado EM GRAUS quando o movimento
  // comeca (alvoGraus1/2, la em cima). Trocar passosPorGrau depois disso
  // nao move o numero -- move o LUGAR que aquele numero descreve. O
  // retoque entao levava o braco para um angulo que ninguem pediu.
  //
  // O momento certo de adotar e o contrario deste: com o braco parado e
  // NENHUM alvo congelado, logo antes de o proximo movimento ser
  // calculado. Ai a regua e o destino nascem juntos e valem o movimento
  // inteiro.
  //
  j.ppvMedido = (uint32_t)novo;
  logEvento("junta %u: engrenagem MEDIDA em %ld pulsos por volta "
            "(configurada %lu) -- %ld pulsos em %.3f voltas do motor",
            (unsigned)junta, novo, (unsigned long)velho, passos, (double)voltas);
  (void)rel;
  return false;   // adotar nao e aqui
}

// =====================================================================
//  O FREIO DO ENCODER
//
//  "Se o encoder diz 3 graus, ele esta em 3 graus." Entao o movimento
//  nao tem por que continuar depois que o encoder diz que chegou --
//  qualquer que seja a regua com que os pulsos foram calculados.
//
//  Isto NAO e malha fechada de servo: nao se corrige o eixo enquanto ele
//  anda (leitura Modbus custa 5 a 20 ms com jitter, e retocar em cima
//  disso faria o braco oscilar). E um FIM DE CURSO por medida: enquanto
//  o movimento acontece, so se olha se ja passou do alvo, e se passou,
//  para. Um teste, uma decisao, sem ganho nenhum no meio.
//
//  E o que torna impossivel "dar voltas sem parar": por pior que esteja
//  passosPorGrau, o braco anda no maximo ate o angulo pedido mais o
//  atraso da leitura. O resto quem fecha e o assentamento.
// =====================================================================
void correcaoAlvoPedido(float t1, float t2, bool valido) {
  temAlvoPedido = valido;
  for (uint8_t i = 0; i < 2; i++) {
    freioSentido[i]  = 0;
    freioConfirma[i] = 0;
    freioConta[i]    = 0;
    freioFreou[i]    = false;
  }
  if (!valido) return;
  // DESLIGAR A CORRECAO PELO ENCODER DESLIGA O FREIO JUNTO.
  //
  // A chave diz "nao use o encoder para mexer no meu posicionamento", e o
  // freio e isso -- so que durante o movimento, em vez de depois. Com ela
  // desligada o braco anda pela contagem de passos e para no destino em
  // passos, como antes de existir encoder.
  if (!configCorrecao.ativa) return;

  alvoPedido[0] = t1;
  alvoPedido[1] = t2;
  largadaValida[0]   = largadaValida[1]   = false;
  esperandoParada[0] = esperandoParada[1] = false;

  for (uint8_t k = 1; k <= 2; k++) {
    const uint8_t i = k - 1;
    const Junta& j = (k == 1) ? J1 : J2;
    if (!j.motor || !j.habilitado) continue;
    if (!leituraConfiavel(k)) continue;   // sem medida nao ha o que vigiar

    // A PONTA DE PARTIDA, com o eixo ainda parado: e o unico instante em
    // que a contagem de passos e a leitura do encoder falam do mesmo
    // momento, por mais velho que seja o ultimo quadro do barramento.
    largadaValida[i] = true;
    largadaGraus[i]  = encoderLer(k).graus;
    largadaPassos[i] = (k == 1) ? posicaoJ1() : posicaoJ2();

    // O SENTIDO DA VIAGEM, pela MEDIDA. E contra ele que o freio julga
    // "passou": passar e a medida ir alem do alvo no sentido em que o
    // eixo estava indo, e nao simplesmente ficar do outro lado do numero.
    const float falta = alvoPedido[i] - largadaGraus[i];
    freioSentido[i] = (falta > 0.0f) ? (int8_t)+1 : (int8_t)-1;
    freioConta[i]   = encoderLer(k).leituras;
  }

  // A RAMPA FOI PROGRAMADA COM A REGUA DIGITADA.
  //
  // Com ela maior que a real o eixo sai rapido demais -- 12 graus/s
  // pedidos viram 48 no ferro. O fator ja medido corrige a VELOCIDADE, e
  // isso continua valendo mesmo agora que a distancia tambem e corrigida:
  // sao dois efeitos da mesma regua errada, e cada um tem seu remedio.
  for (uint8_t k = 1; k <= 2; k++) {
    const uint8_t i = k - 1;
    Junta& j = (k == 1) ? J1 : J2;
    if (!j.motor || govFator[i] >= 0.999f) continue;
    uint32_t hz = velProgramadaPub(i);
    if (hz < 1) continue;
    hz = (uint32_t)((float)hz * govFator[i]);
    if (hz < 1) hz = 1;
    programarVelocidadePub(j, i, hz);
  }
}

// =====================================================================
//  O FREIO DE FUGA. Chamado a cada ciclo enquanto o braco anda.
//
//  Um teste e uma decisao, e nenhuma conta:
//
//    a medida passou do alvo, no sentido da viagem, com folga?
//    isso se confirmou em duas leituras NOVAS seguidas?
//                                            entao para, pela rampa.
//
//  Nao ha ganho, nao ha velocidade escolhida aqui, nao ha alvo em passos
//  sendo reescrito. Quem leva o eixo continua sendo o moveTo() programado
//  na largada; este so pode ENCURTAR a viagem, nunca redireciona-la.
//
//  A folga de FREIO_MARGEM_GRAUS existe para o freio nao encostar num
//  movimento saudavel: com a regua certa a rampa desacelera e para no
//  alvo sem nunca passar dele, e o freio termina a viagem sem ter feito
//  nada -- que e como ele deve terminar quase sempre.
// =====================================================================
void correcaoFrearNoAlvo() {
  if (!temAlvoPedido) return;
  if (!configCorrecao.ativa) return;

  for (uint8_t k = 1; k <= 2; k++) {
    const uint8_t i = k - 1;
    Junta& j = (k == 1) ? J1 : J2;
    if (!j.motor || !j.habilitado) continue;
    if (freioFreou[i] || freioSentido[i] == 0) continue;
    if (!j.motor->isRunning()) continue;      // parado nao ha o que frear
    if (!leituraConfiavel(k)) continue;

    // SO LEITURA NOVA CONTA. Sem isto a mesma amostra seria contada em
    // todos os ciclos ate a proxima chegar, e as "duas confirmacoes"
    // aconteceriam em dois milissegundos -- ou seja, uma confirmacao so,
    // que e exatamente o que este freio existe para nao ser.
    const LeituraEncoder L = encoderLer(k);
    if (L.leituras == freioConta[i]) continue;
    freioConta[i] = L.leituras;

    const float alem = (float)freioSentido[i] * (L.graus - alvoPedido[i]);
    if (alem <= FREIO_MARGEM_GRAUS) { freioConfirma[i] = 0; continue; }

    if (++freioConfirma[i] < FREIO_CONFIRMACOES) continue;

    freioFreou[i] = true;
    j.motor->stopMove();
    logEvento("junta %u: o encoder diz %.2f graus com o alvo em %.2f -- "
              "freado", (unsigned)k, (double)L.graus, (double)alvoPedido[i]);
    definirMensagem("Junta %u parou pelo encoder a %.2f graus (pedido %.2f): "
                    "o destino calculado passou do ponto -- confira pulsos "
                    "por volta", (unsigned)k, (double)L.graus,
                    (double)alvoPedido[i]);
  }
}

bool correcaoFreou(uint8_t junta) {
  return (junta == 1 || junta == 2) ? freioFreou[junta - 1] : false;
}

float correcaoFatorEscala(uint8_t junta) {
  if (junta != 1 && junta != 2) return 1.0f;
  return (junta == 1) ? J1.fatorEscala : J2.fatorEscala;
}

void correcaoEscalaZerar() {
  J1.fatorEscala = J2.fatorEscala = 1.0f;
  J1.escalaAprendida = J2.escalaAprendida = false;
  J1.escalaRegua = J2.escalaRegua = 0.0f;
}

// =====================================================================
//  O QUE A VIAGEM ENSINOU SOBRE A REGUA DIGITADA.
//
//  Chamada uma vez, quando o movimento termina. Compara os graus que a
//  REGUA mandou andar (passos percorridos / passosPorGrau) com os graus
//  que o ENCODER mediu. A razao entre os dois e o exagero da regua, e o
//  fator do governador e o seu inverso.
//
//  Uma conta por viagem, usando as duas pontas de um percurso de
//  segundos. A versao anterior fazia essa conta a cada leitura, dentro
//  de uma janela de 217 ms: dois numeros vizinhos, ruidosos, e um
//  resultado diferente a cada vez.
//
//  Isto NAO adota a regua medida. O fator so entra na VELOCIDADE, nunca
//  na distancia -- adotar a regua por baixo do pano ja foi tentado duas
//  vezes e as duas terminaram com o braco dando voltas (ver o comentario
//  em Robo2dof.ino, "A ADOCAO AUTOMATICA DA ENGRENAGEM SAIU DAQUI").
// =====================================================================
void correcaoAprenderDaViagem() {
  for (uint8_t k = 1; k <= 2; k++) {
    const uint8_t i = k - 1;
    if (!largadaValida[i]) continue;

    // A PONTA DE CHEGADA ESPERA UMA LEITURA NOVA.
    //
    // O eixo acabou de parar, mas o ultimo quadro do barramento e de
    // antes da parada -- num barramento de 217 ms, de ate 217 ms antes,
    // com o eixo ainda andando. Usar esse quadro conta um percurso mais
    // curto do que o de verdade, e a maquina "aprende" uma regua maior
    // do que a que tem.
    //
    // Contando LEITURAS, e nao relogio: o que interessa e que o quadro
    // tenha sido pedido depois de o eixo parar, e nao quantos
    // milissegundos passaram.
    //
    // E ESTE E O UNICO INSTANTE POSSIVEL.
    //
    // Colher no comeco do movimento seguinte nao serve: ancorarNoEncoder()
    // roda antes dele e REESCREVE a contagem de passos para casar com o
    // angulo medido. Depois disso o percurso em passos da viagem que
    // acabou nao existe mais -- os dois lados da conta viram o mesmo
    // numero e a razao sai 1, isto e, "a regua esta certa", justamente
    // quando ela nao esta.
    //
    // Por isso o robo espera aqui, em POSICIONANDO, ate a leitura
    // chegar. O prazo evita que um barramento mudo prenda a maquina.
    if (!esperandoParada[i]) {
      esperandoParada[i] = true;
      contaNaParada[i]   = encoderLer(k).leituras;
      const uint32_t ritmo = correcaoRitmoMs(k);
      const uint32_t espera = (ritmo > 0 && ritmo * 3 > 500) ? ritmo * 3 : 500;
      prazoAprender[i] = millis() + espera;
      continue;
    }
    if (encoderLer(k).leituras == contaNaParada[i]) {
      if ((int32_t)(millis() - prazoAprender[i]) < 0) continue;
      // Prazo vencido: esta viagem nao ensina, e a maquina segue.
      largadaValida[i]   = false;
      esperandoParada[i] = false;
      continue;
    }

    largadaValida[i]   = false;
    esperandoParada[i] = false;

    Junta& j = (k == 1) ? J1 : J2;
    if (j.passosPorGrau <= 0.0f) continue;
    if (!leituraConfiavel(k)) continue;

    const long  passosAgora = (k == 1) ? posicaoJ1() : posicaoJ2();
    const float grausRegua  =
        fabsf((float)(passosAgora - largadaPassos[i])) / j.passosPorGrau;
    const float grausMedidos = fabsf(encoderLer(k).graus - largadaGraus[i]);

    // Viagem curta nao ensina: a diferenca fica dentro do ruido das duas
    // pontas, e um fator tirado de ruido vale menos que nenhum.
    //
    // A medida e a que manda, e nao a regua: com a regua dobrada, andar
    // 3 graus de verdade sao so 1,5 graus de regua, e exigir 3 dos DOIS
    // fazia justamente as viagens mais reveladoras nao ensinarem nada.
    if (grausMedidos < APRENDER_VIAGEM_MINIMA_GRAUS) continue;

    // graus da regua / graus medidos = 1 / exagero.
    float f = grausRegua / grausMedidos;
    if (f > 4.0f)  f = 4.0f;    // leitura absurda nao ensina nada
    if (f < 0.02f) f = 0.02f;

    // O TETO DE 1 VALE NO RESULTADO, NUNCA NA MEDIDA.
    //
    // Travar a medida em 1 antes da media parece a mesma coisa e nao e:
    // o ruido de uma regua CERTA cai dos dois lados de 1, e travando um
    // dos lados so o outro entra na conta. O fator entao descia sozinho,
    // viagem apos viagem -- 1,000 para 0,987 para 0,97 --, e a maquina
    // acabava rastejando com a regua perfeitamente certa. Foi medido
    // assim no banco, num cenario que nao tinha nada a ver com regua.
    //
    // Medindo dos dois lados, uma regua certa fica em 1 porque o ruido
    // se cancela, e o teto no fim so garante que o fator SEGURE o eixo e
    // nunca o acelere.
    //
    // Meio caminho a cada viagem, e nao o valor cheio: uma unica viagem
    // atipica -- escorregao, batente, leitura ruim numa das pontas --
    // nao pode redefinir sozinha como a maquina anda.
    //
    // Menos na PRIMEIRA: ali o valor antigo nao e uma medida, e o
    // palpite de que a regua digitada esta certa. Ir pela metade entre
    // um palpite e uma medida so atrasa a maquina em duas ou tres
    // viagens -- com a regua quatro vezes errada, era o segundo
    // movimento ainda saindo a 16 graus/s com 12 pedidos.
    if (!govAprendeu[i]) { govAprendeu[i] = true; govFator[i] = f; }
    else                  govFator[i] += (f - govFator[i]) * 0.5f;
    if (govFator[i] > 1.0f)  govFator[i] = 1.0f;
    if (govFator[i] < 0.02f) govFator[i] = 0.02f;

    // E A MESMA MEDIDA VAI PARA A DISTANCIA, sem o teto de 1.
    //
    // A conta e literal: a regua mandou andar grausRegua e o eixo andou
    // grausMedidos. Pedindo grausRegua x f da proxima vez, o eixo anda
    // grausMedidos x f -- que e o que se queria. Regua duas vezes maior
    // da f = 0,5; regua pela metade da f = 2,0, e e por isso que o teto
    // de 1 nao pode valer aqui.
    //
    // Meio caminho a cada viagem, como o governador: uma viagem atipica
    // -- escorregao, batente, leitura ruim numa das pontas -- nao pode
    // redefinir sozinha como a maquina anda. A primeira entra inteira,
    // porque ali o valor antigo nao e medida, e so a suposicao de que a
    // regua digitada esta certa.
    //
    // Se estourar os limites, e regua absurda ou leitura ruim: o valor
    // fica preso na borda e o FREIO cuida do resto. Nenhum fator, em
    // nenhum ponto da faixa, deixa o braco dar voltas -- a medida para o
    // eixo antes.
    if (!j.escalaAprendida) { j.escalaAprendida = true; j.fatorEscala = f; }
    else                     j.fatorEscala += (f - j.fatorEscala) * 0.5f;
    if (j.fatorEscala < ESCALA_MIN) j.fatorEscala = ESCALA_MIN;
    if (j.fatorEscala > ESCALA_MAX) j.fatorEscala = ESCALA_MAX;
    j.escalaRegua = j.passosPorGrau;
    logEvento("junta %u: a viagem mediu escala %.3f (regua %.2f graus, "
              "encoder %.2f) -- fator agora %.3f", (unsigned)k, (double)f,
              (double)grausRegua, (double)grausMedidos,
              (double)j.fatorEscala);
  }
}

bool correcaoAprendendo() {
  for (uint8_t i = 0; i < 2; i++)
    if (largadaValida[i] && esperandoParada[i] &&
        (int32_t)(millis() - prazoAprender[i]) < 0) return true;
  return false;
}

float correcaoFatorRegua(uint8_t junta) {
  if (junta != 1 && junta != 2) return 1.0f;
  return govFator[junta - 1];
}

// ---------------------------------------------------------------------
// A ADOCAO AUTOMATICA FOI TENTADA E RETIRADA.
//
// Ela durou uma rodada. O resultado na bancada foi o pior de todos:
// "quando peco para ir a um angulo ele fica dando voltas sem parar".
//
// A medida e uma divisao entre pulsos contados e voltas lidas. Num
// barramento com 7% de falha e 4,5 leituras por segundo, uma leitura
// PARADA enquanto o eixo anda deixa o divisor pequeno demais e a
// engrenagem sai enorme. Regua enorme transforma um pedido de tres graus
// em centenas de voltas. O teto que existia -- 2 milhoes de pulsos por
// volta -- e duzentas vezes o valor real: nao segurava nada. E exigir
// que duas medidas concordem tambem nao salva, porque se a causa e
// leitura parada as duas concordam no mesmo numero errado.
//
// A medida continua sendo feita e continua aparecendo na tela, ao lado
// do campo. Quem escreve a regua da maquina e uma pessoa.
//
// O que faz o braco chegar sem depender da regua e o FREIO DO ENCODER:
// o alvo pedido fica guardado em graus e o movimento para quando o
// encoder diz que chegou. Ver correcaoAlvoPedido() logo abaixo.
// ---------------------------------------------------------------------

// Instantaneo do inicio do movimento. A afericao compara o comeco com o
// fim, entao ela precisa dos dois -- e de saber que nada estranho
// aconteceu no meio.
static long     engPasso0[2]  = {0, 0};
static int32_t  engBruto0[2]  = {0, 0};
static bool     engValendo[2] = {false, false};
static uint32_t engTravAntes  = 0;

static void esquecerAfericao() {
  engValendo[0] = engValendo[1] = false;
  engPasso0[0] = engPasso0[1] = 0;
  engBruto0[0] = engBruto0[1] = 0;
  engTravAntes = 0;
}

static void marcarInicioParaAfericao() {
  engTravAntes = correcaoTravamento().total;
  for (uint8_t k = 1; k <= 2; k++) {
    const uint8_t i = k - 1;
    const Junta& j = (k == 1) ? J1 : J2;
    engValendo[i] = false;
    // Sem torque quem move o eixo e a mao, e mao nao sai em pulso: a
    // divisao nao mediria engrenagem nenhuma.
    if (!j.habilitado) continue;
    if (configEncoder.reg[i] == 0) continue;
    if (!leituraConfiavel(k)) continue;
    engPasso0[i]  = (k == 1) ? posicaoJ1() : posicaoJ2();
    engBruto0[i]  = encoderLer(k).bruto;
    engValendo[i] = true;
  }
}

// Chamada UMA vez por movimento, depois que o eixo parou e a leitura
// assentou, e antes do primeiro retoque -- o retoque tambem sai em pulso e
// misturaria a medida.
static void aferirEngrenagemDoMovimento() {
  // Travou no meio: o eixo nao andou o que foi mandado, e a divisao daria
  // uma engrenagem inventada. Justamente o caso em que errar e mais caro.
  const bool travou = (correcaoTravamento().total != engTravAntes);
  bool gravar = false;

  for (uint8_t k = 1; k <= 2; k++) {
    const uint8_t i = k - 1;
    if (!engValendo[i]) continue;
    engValendo[i] = false;
    if (travou) continue;
    const Junta& j = (k == 1) ? J1 : J2;
    // O torque caiu no meio do caminho: dali para a frente o encoder viu
    // o ferro, nao o pulso.
    if (!j.habilitado) continue;
    if (!leituraConfiavel(k)) continue;

    const long    dP = ((k == 1) ? posicaoJ1() : posicaoJ2()) - engPasso0[i];
    // Complemento de dois: a volta do contador de 32 bits sai sozinha.
    const int32_t dC =
        (int32_t)((uint32_t)encoderLer(k).bruto - (uint32_t)engBruto0[i]);
    if (aferirEngrenagem(k, dP, dC)) gravar = true;
  }
  // Sobreviver ao desligamento importa: sem isto o primeiro movimento
  // depois de cada boot repetiria o erro inteiro.
  if (gravar) salvarConfiguracoes();
}

// ---------------------------------------------------------------------
void correcaoNovoMovimento() {
  // TODO MOVIMENTO NOVO DESARMA O FREIO.
  //
  // Aqui, e nao em irParaPassos(): a ida automatica ao zero absoluto
  // move o braco por moverCoordenado() direto, sem passar por la. Sem
  // desarmar, ela herdava o alvo do movimento ANTERIOR e o freio a
  // parava no meio do caminho. Quem tem angulo pedido e irParaAngulos(),
  // que arma o freio logo depois de chamar esta funcao.
  correcaoAlvoPedido(0.0f, 0.0f, false);

  r.estado     = CORR_PARADA;
  r.tentativas = 0;
  erroAnterior = 0.0f;
  semProgresso = 0;
  fechavelAnterior = 0.0f;
  esquecerGanhoSeAReguaMudou();
  marcarInicioParaAfericao();
  dizer("");
}

// ---------------------------------------------------------------------
void correcaoIniciar() {
  if (!configCorrecao.ativa) return;
  if (soldaLigada()) return;     // retoque no meio do cordao estraga o cordao

  // O RITMO DO BARRAMENTO NAO DECIDE MAIS SE HA ASSENTAMENTO.
  //
  // Havia aqui um portao: sem 10 leituras por segundo, nada de retoque.
  // Ele foi calibrado para a epoca em que o encoder tinha de guiar o eixo
  // EM VOO -- ali a medida atrasada realmente nao converge. O
  // assentamento nao e isso: ele so age com o eixo PARADO e ja espera uma
  // leitura NOVA de depois da parada (ESPERA_ASSENTAR_MS). Uma leitura a
  // cada 100 ms e de sobra para quem so precisa de uma.
  //
  // E o portao era impossivel de satisfazer na maquina de duas juntas.
  // ciclo(), em encoder.cpp, le UMA junta por vez com o intervalo valendo
  // para o ciclo inteiro: com periodoMs de 50 e as duas juntas ligadas,
  // cada uma e lida a cada 100 ms MAIS a transacao Modbus. O ritmo medido
  // fica logo acima do teto, o assentamento e recusado por aritmetica, e
  // o braco fica onde a rampa o deixou -- dizendo "barramento lento" sobre
  // um barramento que estava funcionando. Com uma junta so o ritmo e ~55
  // ms e tudo andava; era por isso que o defeito aparecia depois de ligar
  // o segundo driver.
  //
  // encoderGuiaOMovimento() continua valendo e continua sendo medido: ele
  // e a resposta certa para quem age COM O EIXO ANDANDO.

  r.estado     = CORR_ESPERANDO;
  r.tentativas = 0;
  erroAnterior = 0.0f;
  semProgresso = 0;
  fechavelAnterior = 0.0f;
  r.erroInicial1 = r.erroInicial2 = 0.0f;
  r.erroFinal1   = r.erroFinal2   = 0.0f;
  alvo1Original = posicaoJ1();
  alvo2Original = posicaoJ2();
  // Congelado agora, com a regua que valia quando o movimento foi pedido.
  alvoGraus1    = passosParaGraus(J1, alvo1Original);
  alvoGraus2    = passosParaGraus(J2, alvo2Original);
  // MAS SE HOUVE UM ANGULO PEDIDO, e ele que manda.
  //
  // Com o freio do encoder o movimento pode ter parado ANTES da contagem
  // de destino -- e ai converter a contagem daria um alvo que ninguem
  // pediu, e o assentamento levaria o braco de volta para o lugar errado.
  // O que o operador quer e o numero que ele digitou.
  if (temAlvoPedido) {
    alvoGraus1 = alvoPedido[0];
    alvoGraus2 = alvoPedido[1];
  }
  esperaAte = millis() + ESPERA_ASSENTAR_MS;
  dizer("assentando");
}

void correcaoCancelar() {
  if (r.estado == CORR_ESPERANDO || r.estado == CORR_RETOCANDO) {
    r.estado = CORR_PARADA;
    dizer("cancelado");
  }
}

bool correcaoEmCurso() {
  return r.estado == CORR_ESPERANDO || r.estado == CORR_RETOCANDO;
}

ResumoCorrecao correcaoResumo() { return r; }

// ---------------------------------------------------------------------
void correcaoAtualizar() {
  if (!correcaoEmCurso()) return;

  // Regra 4: solda ligada cancela na hora, em qualquer fase.
  if (soldaLigada()) {
    r.estado = CORR_RECUSADA;
    dizer("solda ligada: nao se retoca no cordao");
    return;
  }
  // Regra 1: so com o eixo parado.
  if (motoresEmMovimento()) return;
  if ((int32_t)(millis() - esperaAte) < 0) return;

  // O MOVIMENTO QUE ACABOU DE ACONTECER MEDIU A ENGRENAGEM.
  //
  // Aqui, e so aqui: o eixo esta parado, a leitura ja assentou, e nenhum
  // retoque saiu ainda para misturar pulso na conta. Se a regua mudar, o
  // resto deste ciclo ja trabalha com a nova -- o alvo nao se mexe porque
  // esta guardado em graus.
  if (r.tentativas == 0) aferirEngrenagemDoMovimento();

  const float alvoG1 = alvoGraus1;
  const float alvoG2 = alvoGraus2;

  float e1 = 0.0f, e2 = 0.0f;
  const bool t1 = faltaPara(1, alvoG1, e1);
  const bool t2 = faltaPara(2, alvoG2, e2);

  // Regra 2: sem leitura confiavel nao se mexe no motor.
  if (!t1 && !t2) {
    r.estado = CORR_RECUSADA;
    dizer("sem leitura do encoder: nada foi retocado");
    return;
  }

  // O RETOQUE ANTERIOR MEDIU A ESCALA: aproveita antes de calcular o
  // proximo. 'andou' e quanto o encoder se moveu de fato; 'pedido' e
  // quanto foi comandado. A divisao e o ganho real desta maquina.
  for (uint8_t k = 1; k <= 2; k++) {
    const uint8_t i = k - 1;
    if (retoquePedido[i] == 0.0f || !temMedidoAntes[i]) continue;
    if (!leituraConfiavel(k)) { retoquePedido[i] = 0.0f; continue; }
    const float andou = encoderLer(k).graus - medidoAntes[i];
    const float g = andou / retoquePedido[i];
    if (g > GANHO_MIN && g < GANHO_MAX) {
      ganhoRetoque[i] = g;
      ganhoAprendido[i] = true;
      ganhoRegua[i]     = (k == 1) ? J1.passosPorGrau : J2.passosPorGrau;
      logEvento("junta %u: retoque pediu %.3f grau e o eixo andou %.3f "
                "(ganho %.2f)", (unsigned)k, (double)retoquePedido[i],
                (double)andou, (double)g);
    }
    retoquePedido[i] = 0.0f;
  }

  if (r.tentativas == 0) { r.erroInicial1 = e1; r.erroInicial2 = e2; }
  r.erroFinal1 = e1;
  r.erroFinal2 = e2;

  const float m1 = fabsf(e1), m2 = fabsf(e2);
  const float tol = configCorrecao.toleranciaGraus;

  // O ASSENTAMENTO VOLTA A VALER PARA AS DUAS JUNTAS.
  //
  // Havia aqui um terceiro termo: a junta que a BUSCA tivesse levado era
  // dada como chegada, qualquer que fosse o erro. Fazia sentido enquanto
  // a busca existia -- ela era malha fechada, e duas malhas discutindo
  // pelo mesmo eixo eram o vai-e-vem. Mas custava caro: no caminho "ir a
  // um angulo", que era o unico que buscava, o assentamento ficava
  // DESLIGADO por construcao. Quando a busca desistia, ninguem fechava o
  // resto -- e a maquina ainda dizia que tinha chegado.
  //
  // Agora quem leva o eixo e a rampa, que nao e malha nenhuma: ela para
  // onde foi mandada. O assentamento e a unica malha, e nao ha com quem
  // discutir.
  const bool ok1 = !t1 || m1 <= tol;
  const bool ok2 = !t2 || m2 <= tol;

  // Chegou.
  if (ok1 && ok2) {
    // O eixo esta fisicamente no lugar certo. A contagem, porem, ficou
    // adiantada pelo tanto que o retoque andou -- e e ela que o proximo
    // movimento absoluto usa como ponto de partida. Sem devolver a
    // contagem ao alvo, o desvio nao some: ele so passa para o proximo
    // movimento, que e exatamente o incomodo que este modulo existe para
    // resolver.
    //
    // Nenhum pulso sai no fio aqui: o eixo NAO se mexe.
    //
    // A contagem que representa o alvo se refaz da regua DE AGORA: se a
    // engrenagem foi aferida durante este assentamento, o numero de passos
    // que descreve aquele angulo mudou. Devolver o valor velho reporia na
    // contagem justamente o erro que a afericao acabou de tirar.
    //
    // A contagem vai para o ALVO, e nao para onde o braco parou.
    //
    // A versao da busca gravava a MEDIDA nas juntas que ela tinha levado
    // -- o que era coerente com "a busca para onde o encoder mandou", mas
    // tambem era o jeito de um desvio virar verdade quando ela desistia.
    // Agora ha um caso so: o eixo esta dentro da tolerancia do alvo, e a
    // contagem passa a dizer o alvo.
    for (uint8_t k = 1; k <= 2; k++) {
      Junta& j = (k == 1) ? J1 : J2;
      if (r.tentativas == 0) continue;   // nada andou: nada a reescrever
      const float alvoG = (k == 1) ? alvoGraus1 : alvoGraus2;
      const long  orig  = (k == 1) ? alvo1Original : alvo2Original;
      ajustarContagem(j, (j.passosPorGrau > 0.0f)
                         ? grausParaPassos(j, alvoG) : orig);
    }
    r.estado = CORR_PRONTA;
    r.totalOk++;
    dizer("posicao conferida pelo encoder");
    return;
  }

  // REGRA 5, REFEITA: erro grande nao se pula, mas tambem nao se
  // abandona.
  //
  // Antes, erro acima de maxCorrecaoGraus era RECUSADO e o braco ficava
  // onde estava. Era isto que fazia "peco zero grau e quem chega e so o
  // tracejado": com sete graus de diferenca o assentamento se recusava a
  // mexer, o operador via a contagem no alvo e o braco longe dele.
  //
  // O teto passou a ser o tamanho do PASSO, nao um motivo para desistir.
  // Cada retoque anda no maximo maxCorrecaoGraus, le o encoder de novo e
  // repete: sete graus fecham em tres passos, sempre olhando o encoder,
  // e nenhum deles e um pulo. A intencao da regra continua de pe -- o
  // braco nunca lunga varios graus de uma vez.
  const float teto = configCorrecao.maxCorrecaoGraus;

  // REGRA 6, REFEITA DE NOVO: progresso se mede contra o PASSO, nunca
  // contra o erro inteiro.
  //
  // Desistir de nao PROGREDIR (em vez de contar tentativas) foi acerto: o
  // que denuncia acoplamento solto ou reducao errada e o retoque nao
  // diminuir o erro. Mas cobrar 15% DO ERRO TOTAL por passo era um alvo
  // que o proprio teto tornava inalcancavel: um passo de tres graus so
  // consegue 15% enquanto o erro for menor que vinte. Acima disso a
  // desistencia virava ARITMETICA -- o assentamento parava em tres
  // retoques com dezenas de graus na peca, dissesse o que dissesse o
  // encoder, e o operador via "comeca bem, da uns travamentos e nunca
  // chega".
  //
  // A pergunta certa nao e "sobrou pouco?", e "o passo fez o que podia
  // fazer?". Um passo que fechou o que tinha como fechar esta convergindo,
  // por mais que ainda falte caminho.
  const float faltaMaior = ((ok1 ? 0.0f : m1) > (ok2 ? 0.0f : m2))
                             ? (ok1 ? 0.0f : m1) : (ok2 ? 0.0f : m2);
  if (r.tentativas > 0) {
    const float fechou = erroAnterior - faltaMaior;
    // Sem referencia do passo anterior (primeiro ciclo apos um retoque que
    // nao comandou nada), cai no criterio antigo.
    const float podia = (fechavelAnterior > 0.0f) ? fechavelAnterior
                                                  : erroAnterior;
    if (fechou > podia * 0.15f) semProgresso = 0;
    else                        semProgresso++;
  }
  erroAnterior = faltaMaior;

  if (semProgresso >= configCorrecao.tentativas) {
    r.estado = CORR_DESISTIU;
    r.totalDesistiu++;
    dizer("o retoque nao aproxima: veja acoplamento e reducao");
    return;
  }
  // O TETO DE DOIS AJUSTES, quando a MEDIDA confirmou a chegada.
  //
  //   "Se passar um pouquinho, apenas ajustar."
  //
  // A constante existia em config.h com um comentario de catorze linhas
  // explicando o comportamento -- e nao tinha nenhum uso no firmware. Ela
  // vale agora: chegando o eixo perto o bastante para o freio nao ter
  // precisado agir, dois retoques fecham o que sobrou e para. Perseguir o
  // ultimo decimo contra uma tolerancia menor que o ruido da leitura era
  // o "fica oscilando ate acertar o grau certo" da bancada.
  //
  // Quando a medida NAO confirmou nada -- perda de passo, acoplamento
  // solto, freio de fuga acionado -- o teto nao vale: ali o erro e de
  // graus e o braco precisa de quantos passos forem necessarios. Quem
  // julga esse caso continua sendo o progresso, logo acima.
  //
  // "Confirmou a chegada" e sobre COMO O MOVIMENTO TERMINOU, e nao sobre
  // o que ainda falta agora. Julgando pelo que falta, o teto mordia no
  // meio de uma convergencia legitima: sete graus de perda de passo
  // fechavam ate cerca de um grau e ali o assentamento declarava
  // "chegou", deixando na peca exatamente o erro que ele existe para
  // tirar. O que decide e o erro com que o eixo chegou.
  const float chegouCom = (fabsf(r.erroInicial1) > fabsf(r.erroInicial2))
                        ? fabsf(r.erroInicial1) : fabsf(r.erroInicial2);
  const bool chegouPelaRampa = !correcaoFreou(1) && !correcaoFreou(2) &&
                               chegouCom <= configCorrecao.maxCorrecaoGraus;
  if (chegouPelaRampa && r.tentativas >= AJUSTES_APOS_CHEGAR) {
    r.estado = CORR_PRONTA;
    r.totalOk++;
    dizer("assentado: o resto e menor que a medida distingue");
    return;
  }
  // Teto absoluto, so para nunca existir laco infinito no core 1.
  if (r.tentativas >= RETOQUES_MAXIMOS) {
    r.estado = CORR_DESISTIU;
    r.totalDesistiu++;
    dizer("nao fechou na tolerancia");
    return;
  }

  // O retoque. 'falta' e alvo menos medido: positivo quer dizer que o
  // eixo esta ATRAS do alvo e precisa avancar.
  // Graus de erro viram passos direto pela resolucao da junta. Nao se
  // usa grausParaPassos() aqui: aquela funcao converte um ANGULO
  // ABSOLUTO (descontando o zero da maquina), e o que se tem aqui e uma
  // DIFERENCA -- passar diferenca por ela somaria o zero duas vezes.
  // Quanto PEDIR para andar tantos graus de erro: divide pelo ganho
  // medido. Sem ganho medido ainda, sai amortecido -- passar do ponto
  // custa outra viagem.
  const auto passoDe = [](float erro, uint8_t i) {
    return ganhoAprendido[i] ? (erro / ganhoRetoque[i])
                             : (erro * AMORTECIMENTO_SEM_GANHO);
  };

  long alvo1 = posicaoJ1();
  long alvo2 = posicaoJ2();
  float pedido1 = 0.0f, pedido2 = 0.0f;
  if (!ok1) {
    pedido1 = comTeto(passoDe(e1, 0), teto);
    alvo1 += lroundf(pedido1 * J1.passosPorGrau);
  }
  if (!ok2) {
    pedido2 = comTeto(passoDe(e2, 1), teto);
    alvo2 += lroundf(pedido2 * J2.passosPorGrau);
  }

  // QUANTO ESTE PASSO TEM COMO FECHAR, em graus MEDIDOS -- que e a unidade
  // em que o erro e contado. O passo sai em graus COMANDADOS; o eixo anda
  // esses graus multiplicados pelo ganho da maquina. E ele nunca fecha
  // mais do que o erro que existia.
  //
  // E contra este numero que o ciclo seguinte julga o progresso. Sem ele o
  // criterio cobrava do passo mais do que o teto deixava o passo entregar.
  const auto fechavelDe = [&](float erro, float pedido, uint8_t i) {
    if (pedido == 0.0f) return 0.0f;
    const float anda = fabsf(pedido) *
                       (ganhoAprendido[i] ? ganhoRetoque[i] : 1.0f);
    const float e    = fabsf(erro);
    return (anda < e) ? anda : e;
  };
  const float f1 = fechavelDe(e1, pedido1, 0);
  const float f2 = fechavelDe(e2, pedido2, 1);
  fechavelAnterior = (f1 > f2) ? f1 : f2;

  // Regra 3: nunca para fora do curso, QUANDO o curso esta valendo.
  // Com o limite desligado o braco anda livre pela mesa (ver R143), e
  // prender o retoque num curso que nao esta em vigor -- pior, num curso
  // medido pela metade -- era mais um jeito de o braco nao chegar.
  if (protCurso && J1.calibrada) {
    if (alvo1 < J1.passosMin) alvo1 = J1.passosMin;
    if (alvo1 > J1.passosMax) alvo1 = J1.passosMax;
  }
  if (protCurso && J2.calibrada) {
    if (alvo2 < J2.passosMin) alvo2 = J2.passosMin;
    if (alvo2 > J2.passosMax) alvo2 = J2.passosMax;
  }

  if (alvo1 == posicaoJ1() && alvo2 == posicaoJ2()) {
    // O retoque cairia fora do curso: nao ha o que fazer sem furar o
    // limite, e furar o limite nunca.
    r.estado = CORR_DESISTIU;
    r.totalDesistiu++;
    dizer("retoque cairia fora do curso calibrado");
    return;
  }

  // O RETOQUE E MOVIMENTO, e passa pelo mesmo portao que todo o resto.
  //
  // pararTudo() ja cancela o assentamento, entao na pratica ele nao
  // chega aqui com a emergencia acionada. Mas este e o unico caminho do
  // firmware que move o braco sem ter vindo de um comando do operador:
  // depender de um cancelamento la longe para ele nao andar e confiar em
  // ordem de chamada. A trava fica aqui tambem.
  if (!movimentoSeguro) {
    r.estado = CORR_PARADA;
    dizer("assentamento suspenso: intertravamento de seguranca");
    return;
  }

  // SUAVIDADE NA CHEGADA: a velocidade acompanha o que falta.
  //
  // Era fixa em um quarto da normal -- boa para decimos de grau, dura
  // para graus inteiros, e sempre a mesma no ultimo passo, que e onde
  // passar do ponto custa outra viagem. Agora o retoque longe anda a
  // meia velocidade e vai afinando ate o minimo da maquina, entao o
  // ultimo decimo e um encosto e nao um tranco.
  const float cheia = velNormal * 0.5f;
  const float andarMaior = (fabsf(pedido1) > fabsf(pedido2))
                         ? fabsf(pedido1) : fabsf(pedido2);
  float vel = (GRAUS_VEL_CHEIA > 0.001f)
            ? cheia * (andarMaior / GRAUS_VEL_CHEIA) : cheia;
  if (vel > cheia)     vel = cheia;
  if (vel < velMinima) vel = velMinima;
  // Guarda o que foi pedido e de onde partiu: e com esse par que o
  // ciclo seguinte mede o ganho.
  for (uint8_t k = 1; k <= 2; k++) {
    const uint8_t i = k - 1;
    const float ped = (k == 1) ? pedido1 : pedido2;
    retoquePedido[i]  = ped;
    temMedidoAntes[i] = false;
    if (ped != 0.0f && leituraConfiavel(k)) {
      medidoAntes[i]    = encoderLer(k).graus;
      temMedidoAntes[i] = true;
    }
  }

  // A ACELERACAO TAMBEM ACOMPANHA, e nao so a velocidade.
  //
  // Um retoque de um decimo de grau com a aceleracao cheia e todo
  // arranque e freada dentro desse decimo: sai como um tranco, e o
  // operador ve um tique em vez de um encosto. Abaixo de um grau ele anda
  // com um quarto da rampa.
  const float acel = (andarMaior < RETOQUE_SUAVE_GRAUS)
                   ? RETOQUE_SUAVE_ACEL : 1.0f;
  moverCoordenado(alvo1, alvo2, vel, acel);
  r.tentativas++;
  r.estado = CORR_RETOCANDO;
  esperaAte = millis() + ESPERA_ASSENTAR_MS;
  dizer("retocando");
}

// =====================================================================
//  Localizar-se ao ligar. Ver correcao.h.
// =====================================================================
static ResumoZero z;
static uint32_t zeroDesde = 0;
static bool     zeroComecou = false;
// Uma leitura chegou, mas era impossivel. Guardado para a mensagem
// distinguir "o encoder nao respondeu" de "o encoder respondeu besteira"
// -- sao dois defeitos diferentes, com conserto diferente.
static bool  zImplausivel[2]      = {false, false};
static float zGrausImplausivel[2] = {0.0f, 0.0f};

ResumoZero zeroResumo() { return z; }

static void dizerZero(const char* m) {
  strncpy(z.motivo, m, sizeof(z.motivo) - 1);
  z.motivo[sizeof(z.motivo) - 1] = '\0';
}

// Acerta a contagem de passos de uma junta para bater com o encoder.
// Nenhum pulso sai no fio: o eixo NAO se mexe, so a conta muda.
// ---------------------------------------------------------------------
// A leitura e FISICAMENTE possivel?
//
// O encoder e a unica testemunha de onde o braco esta, e escrever a
// leitura na contagem de passos e obedecer a essa testemunha sem
// conferir nada. Se ela mentir uma vez -- registrador errado, contagens
// por volta erradas, ruido que passou no CRC -- a mentira vira a posicao
// oficial da maquina, e a partir dali TODA protecao de curso se apoia num
// numero inventado.
//
// A conferencia nao e estatistica, e fisica: o braco nao pode estar fora
// do curso que o proprio operador mediu. A folga cobre o que sobra
// depois do limite (o batente fica um pouco alem, e da para empurrar o
// braco a mao ate ele). Alem disso nao e posicao, e defeito.
//
// SO QUE ISSO SO VALE SE O CURSO MEDIDO FOR UMA AFIRMACAO SOBRE A
// MAQUINA -- e desde que o limite virou OPCAO, ele nao e.
//
// O operador mede o curso e decide, em separado, se quer que a maquina o
// respeite (protCurso). Com o limite desligado o braco anda livre pela
// mesa, e a leitura do encoder fora daquela faixa e leitura BOA de um
// lugar onde o braco legitimamente esta. Conferir assim mesmo virava o
// pior defeito possivel: um curso medido pela metade -- uma calibracao
// abortada, dois graus de faixa -- calava o encoder na maquina inteira.
// E como calava, calava TUDO: nao havia mais reancoragem, nem
// seguimento de eixo solto, nem assentamento, e o desenho na tela (que
// so obedece ao encoder) congelava. O sintoma era "movo o motor e o
// braco nao acompanha", e a causa era esta linha ignorando o encoder de
// proposito.
//
// Entao: a conferencia contra o curso vale quando o limite esta LIGADO.
// O que separa leitura de lixo em qualquer caso e o teto absoluto
// abaixo, e ele vale sempre.
// ---------------------------------------------------------------------
static const float FOLGA_PLAUSIVEL_GRAUS = 10.0f;

// Teto que vale SEM calibracao nenhuma.
//
// A conferencia contra o curso so existe depois de calibrar, e maquina em
// comissionamento nunca esta calibrada -- entao ali qualquer numero
// passava. Com os dois encoders no barramento e um deles mal configurado
// (contagens por volta erradas, formato de 32 bits errado, registrador do
// vizinho), o angulo saia em dezenas de milhares de graus, era marcado
// CONFIAVEL, ia para a tela e o braco desenhado girava sem parar.
//
// Nao existe junta desta maquina em 170 mil graus, calibrada ou nao. Duas
// voltas completas e folga generosa para qualquer montagem real e ainda
// pega o lixo por ordens de grandeza -- que e o que esta guarda precisa
// fazer: separar leitura de numero, nao medir precisao.
static const float LIMITE_ABSURDO_GRAUS = 720.0f;

static bool leituraPlausivel(uint8_t k, float graus) {
  const Junta& j = (k == 1) ? J1 : J2;
  if (graus != graus) return false;                 // NaN nao e angulo
  // Vale sempre, inclusive sem calibracao. E a unica conferencia que
  // existe durante a montagem, que e justamente quando o encoder esta
  // mal configurado.
  if (graus < -LIMITE_ABSURDO_GRAUS || graus > LIMITE_ABSURDO_GRAUS) return false;
  // Curso medido so e fronteira quando o operador ligou o limite. Ver o
  // bloco acima: com ele desligado o braco anda livre, e leitura fora da
  // faixa e leitura boa de onde o braco de fato esta.
  if (!protCurso) return true;
  if (!j.calibrada) return true;
  return graus >= j.grausMin - FOLGA_PLAUSIVEL_GRAUS &&
         graus <= j.grausMax + FOLGA_PLAUSIVEL_GRAUS;
}

// =====================================================================
//  O ENCODER CHEGA A TEMPO DE GUIAR O MOVIMENTO?
//
//  Corrigir o eixo a partir de uma medida so funciona se a PROXIMA
//  medida chegar a tempo de mostrar o resultado da correcao. Num
//  barramento lento a maquina age, o eixo anda, e so muito depois ela ve
//  onde parou -- e age de novo em cima de um numero velho. Isso nao
//  converge: fica cacando o ponto.
//
//  Da bancada, com 4,6 leituras por segundo: "micro variacao e nunca
//  fica no ponto setado, ele fica tentando acertar. Antes ele ia
//  desacelerando com rampa e parava exatamente."
//
//  Entao o ritmo do barramento decide QUEM leva o eixo:
//
//    rapido  -> o encoder guia: afina ao chegar, freia no alvo, assenta.
//    lento   -> a rampa do gerador de pulso leva, desacelera e para. O
//               encoder segue valendo para dizer onde o braco esta,
//               ancorar a partida, calibrar e avisar de travamento --
//               so nao manda no motor.
//
//  Mede-se o intervalo entre leituras BOAS, suavizado, e nao a taxa
//  nominal configurada: o que importa e o que chega, com as falhas
//  incluidas.
// =====================================================================
static uint32_t ritmoMs[2]     = {0, 0};   // intervalo medio entre leituras
static uint32_t ritmoUlt[2]    = {0, 0};   // instante da ultima leitura nova
static uint32_t ritmoConta[2]  = {0, 0};   // contador visto por ultimo

void correcaoMedirRitmo() {
  const uint32_t agora = millis();
  for (uint8_t k = 1; k <= 2; k++) {
    const uint8_t i = k - 1;
    if (configEncoder.reg[i] == 0) { ritmoMs[i] = 0; continue; }
    const LeituraEncoder L = encoderLer(k);
    if (L.leituras == ritmoConta[i]) continue;   // nada novo
    ritmoConta[i] = L.leituras;
    if (ritmoUlt[i] != 0) {
      const uint32_t dt = agora - ritmoUlt[i];
      // LACUNA NAO E RITMO. Cabo que caiu e voltou, reconfiguracao, a
      // maquina parada num veu de calibracao -- tudo isso produz um
      // intervalo enorme que nao diz nada sobre o barramento. Contar
      // esse numero na media deixaria o encoder "lento" por segundos
      // depois de qualquer pausa. Acima do teto, so recomeca a contar.
      if (dt <= CORR_LACUNA_MS) {
        // Media exponencial: uma leitura atrasada isolada nao decide, e
        // uma degradacao que dura aparece em poucos ciclos.
        ritmoMs[i] = ritmoMs[i] ? (ritmoMs[i] * 3 + dt) / 4 : dt;
      }
    }
    ritmoUlt[i] = agora;
  }
}

bool encoderGuiaOMovimento(uint8_t junta) {
  if (junta != 1 && junta != 2) return false;
  const uint32_t m = ritmoMs[junta - 1];
  if (m == 0) return false;            // ainda nao ha ritmo medido
  return m <= CORR_INTERVALO_MAX_MS;
}

uint32_t correcaoRitmoMs(uint8_t junta) {
  return (junta == 1 || junta == 2) ? ritmoMs[junta - 1] : 0;
}

bool leituraConfiavel(uint8_t junta) {
  if (junta != 1 && junta != 2) return false;
  if (configEncoder.reg[junta - 1] == 0) return false;
  const LeituraEncoder L = encoderLer(junta);
  if (!L.valido || L.idadeMs > ENC_IDADE_MAX_MS) return false;
  return leituraPlausivel(junta, L.graus);
}

static bool localizar(uint8_t k) {
  Junta& j = (k == 1) ? J1 : J2;
  if (configEncoder.reg[k - 1] == 0) return false;   // junta nao ligada
  // Sem zero ensinado a referencia e um numero arbitrario, e acertar a
  // contagem por ela poria o braco em qualquer lugar.
  if (!configZero.ensinado[k - 1]) return false;

  const LeituraEncoder L = encoderLer(k);
  if (!L.valido || L.idadeMs > ENC_IDADE_MAX_MS) return false;
  if (j.passosPorGrau <= 0.0f) return false;

  // Localizar-se por uma leitura impossivel e pior que nao se localizar:
  // a maquina passaria a operar com uma posicao inventada, e o "ir ao
  // zero" mandaria um curso inteiro de pulso contra o batente.
  if (!leituraPlausivel(k, L.graus)) {
    zImplausivel[k - 1] = true;
    zGrausImplausivel[k - 1] = L.graus;
    return false;
  }

  ajustarContagem(j, grausParaPassos(j, L.graus));
  z.graus[k - 1] = L.graus;
  return true;
}

void zeroAtualizar() {
  if (!configZero.sincronizar) { z.estado = ZERO_PRONTO; return; }
  // Nenhuma junta com zero ensinado: nao ha o que recuperar, e a maquina
  // se comporta exatamente como antes do encoder absoluto.
  if (!configZero.ensinado[0] && !configZero.ensinado[1]) {
    if (z.estado == ZERO_ESPERANDO) {
      z.estado = ZERO_PRONTO;
      dizerZero("zero nao ensinado: a maquina liga como antes");
    }
    return;
  }
  if (z.estado == ZERO_PRONTO || z.estado == ZERO_SEM_ENCODER) return;

  if (!zeroComecou) { zeroComecou = true; zeroDesde = millis(); }

  // ---- 1. localizar ----
  if (z.estado == ZERO_ESPERANDO) {
    // Nao se acerta contagem com o eixo andando: entre ler e escrever o
    // eixo teria andado mais, e a conta nasceria torta.
    if (motoresEmMovimento()) return;

    bool alguma = false;
    for (uint8_t k = 1; k <= 2; k++) {
      if (z.localizou[k - 1]) { alguma = true; continue; }
      if (localizar(k)) { z.localizou[k - 1] = true; alguma = true; }
    }

    // Junta nao ligada nao impede: uma bancada com um driver so tem de
    // conseguir ligar a maquina.
    bool faltaAlguma = false;
    for (uint8_t k = 1; k <= 2; k++)
      if (configEncoder.reg[k - 1] != 0 && configZero.ensinado[k - 1] &&
          !z.localizou[k - 1]) faltaAlguma = true;

    if (!faltaAlguma && alguma) {
      z.estado = ZERO_LOCALIZADO;
      dizerZero("posicao recuperada do encoder");
      definirMensagem("Posicao recuperada do encoder: %.2f / %.2f graus",
                      (double)z.graus[0], (double)z.graus[1]);
      return;
    }

    // Cinco segundos sem leitura: segue como antes do encoder. Uma
    // maquina que nao liga porque o encoder nao respondeu e pior que uma
    // maquina que liga sem saber onde esta.
    if ((uint32_t)(millis() - zeroDesde) > 5000) {
      z.estado = ZERO_SEM_ENCODER;
      // "Nao respondeu" e "respondeu besteira" pedem conserto diferente:
      // um e cabo, o outro e registrador ou contagens por volta.
      if (zImplausivel[0] || zImplausivel[1]) {
        const uint8_t k = zImplausivel[0] ? 1 : 2;
        dizerZero("leitura fora do curso: nao me localizei");
        definirMensagem("Junta %u: o encoder diz %.1f graus, fora do curso "
                        "%.0f a %.0f. Confira registrador e contagens por volta",
                        (unsigned)k, (double)zGrausImplausivel[k - 1],
                        (double)((k == 1) ? J1.grausMin : J2.grausMin),
                        (double)((k == 1) ? J1.grausMax : J2.grausMax));
      } else {
        dizerZero("sem encoder no boot: posicao nao recuperada");
        definirMensagem("Sem leitura do encoder ao ligar: refira a maquina a mao");
      }
    }
    return;
  }

  // ---- 2. ir para o zero ----
  if (z.estado == ZERO_LOCALIZADO) {
    if (!configZero.irParaZero) {
      z.estado = ZERO_PRONTO;
      dizerZero("localizado (ir ao zero desligado)");
      return;
    }
    // O INTERTRAVAMENTO: nada anda antes de o operador habilitar os
    // servos, que e uma acao explicita dele na tela.
    if (!servosLigados) return;
    if (soldaLigada()) return;
    if (modoAtual != MODO_MANUAL) return;
    if (motoresEmMovimento()) return;

    // Ja esta no zero? Nao mexe.
    const float g1 = passosParaGraus(J1, posicaoJ1());
    const float g2 = passosParaGraus(J2, posicaoJ2());
    if (fabsf(g1) <= configZero.toleranciaGraus &&
        fabsf(g2) <= configZero.toleranciaGraus) {
      z.estado = ZERO_PRONTO;
      dizerZero("ja estava no zero");
      return;
    }

    // O zero tem de caber no curso calibrado. Se nao couber, ir para la
    // seria furar a protecao -- e a protecao existe justamente porque
    // nao ha fim de curso.
    if ((J1.calibrada && (grausParaPassos(J1, 0.0f) < J1.passosMin ||
                          grausParaPassos(J1, 0.0f) > J1.passosMax)) ||
        (J2.calibrada && (grausParaPassos(J2, 0.0f) < J2.passosMin ||
                          grausParaPassos(J2, 0.0f) > J2.passosMax))) {
      z.estado = ZERO_PRONTO;
      dizerZero("o zero esta fora do curso: nao fui");
      definirMensagem("Nao fui ao zero: ele esta fora do curso calibrado");
      return;
    }

    z.estado = ZERO_INDO;
    dizerZero("indo para o zero");
    definirMensagem("Indo para 0 grau (o encoder disse onde o braco estava)");
    correcaoNovoMovimento();
    moverCoordenado(grausParaPassos(J1, 0.0f), grausParaPassos(J2, 0.0f),
                    velAuto);
    modoAtual = MODO_POSICIONANDO;
    return;
  }

  // ---- 3. chegou ----
  if (z.estado == ZERO_INDO) {
    if (motoresEmMovimento() || modoAtual == MODO_POSICIONANDO) return;
    z.estado = ZERO_PRONTO;
    dizerZero("no zero");
  }
}

// =====================================================================
//  Seguir o eixo movido a mao. Ver correcao.h.
// =====================================================================
// Avisa, no maximo uma vez a cada 10 s por junta: com o eixo solto a
// leitura ruim se repete 20 vezes por segundo, e uma tira de mensagem
// piscando esconde tudo o que importa.
static void avisarImplausivel(uint8_t k, float graus) {
  static uint32_t ultimo[2] = {0, 0};
  const uint32_t agora = millis();
  if (ultimo[k - 1] && (uint32_t)(agora - ultimo[k - 1]) < 10000) return;
  ultimo[k - 1] = agora;
  const Junta& j = (k == 1) ? J1 : J2;
  definirMensagem("Junta %u: encoder diz %.1f graus, fora do curso %.0f a %.0f. "
                  "Posicao nao acompanhada", (unsigned)k, (double)graus,
                  (double)j.grausMin, (double)j.grausMax);
}

// A contagem de passos parou de descrever o braco: reescreve pelo
// encoder. Ver DIVERGENCIA_MAXIMA_GRAUS em config.h para o porque.
//
// Roda com o servo LIGADO, que e onde o assentamento manda -- mas so
// acima do teto em que o assentamento ja desistiu. Abaixo dele nada
// muda: divergencia pequena continua sendo perda de passo, e continua
// sendo do assentamento.
// A maquina esta REALMENTE parada, e nao apenas entre dois pulsos.
//
// isRunning() do gerador de pulso responde "esta saindo pulso agora?",
// e entre mandar um destino e o primeiro pulso sair ela responde NAO.
// Nessa fresta a contagem era reescrita, o destino que acabara de ser
// calculado sobre a contagem antiga virava outro lugar, e o braco
// arrancava e parava -- que e exatamente o que se via na tela: "comeca a
// se mover, da uma atualizacao e para".
//
// Duas condicoes fecham a fresta: o modo tem de ser MANUAL (posicionar,
// executar e reproduzir sao movimento em curso, com ou sem pulso neste
// instante) e o gerador tem de estar quieto ha um tempo.
static const uint32_t QUIETO_MS = 300;

static bool bracoQuieto() {
  static uint32_t ultimoMovimentoMs = 0;
  if (motoresEmMovimento()) { ultimoMovimentoMs = millis(); return false; }
  if (modoAtual != MODO_MANUAL) { ultimoMovimentoMs = millis(); return false; }
  if (ultimoMovimentoMs == 0) return true;
  return (uint32_t)(millis() - ultimoMovimentoMs) > QUIETO_MS;
}

static void reancorarSeAContagemSePerdeu() {
  if (!bracoQuieto()) return;
  if (correcaoEmCurso()) return;

  for (uint8_t k = 1; k <= 2; k++) {
    const uint8_t i = k - 1;
    Junta& j = (k == 1) ? J1 : J2;
    if (configEncoder.reg[i] == 0) continue;
    if (j.passosPorGrau <= 0.0f) continue;
    if (!leituraConfiavel(k)) continue;

    const LeituraEncoder L = encoderLer(k);
    const float conta = passosParaGraus(j, (k == 1) ? posicaoJ1() : posicaoJ2());
    const float dif   = L.graus - conta;
    if (fabsf(dif) < DIVERGENCIA_MAXIMA_GRAUS) continue;

    ajustarContagem(j, grausParaPassos(j, L.graus));
    // Dizer sempre: reescrever a posicao da maquina em silencio seria a
    // tela mudando de numero sem ninguem entender por que.
    definirMensagem("Junta %u: a contagem tinha se perdido (%.0f graus de "
                    "diferenca) e foi reancorada no encoder, que mede "
                    "%.2f graus", (unsigned)k, (double)dif, (double)L.graus);
    logEvento("contagem reancorada na junta %u: %.1f -> %.1f graus",
              (unsigned)k, (double)conta, (double)L.graus);
  }
}

// SO UMA VEZ POR LEITURA.
//
// Reescrever a referencia nao atualiza leitura[].graus: aquele numero so
// se refaz quando a proxima resposta do barramento chega. Sem esta
// guarda a funcao lia o mesmo 360 a cada ciclo de 1 ms, deslocava de
// novo, e o angulo fugia em multiplos de 360 ate a leitura seguinte --
// seis voltas por vez, num barramento de 20 ms. E a mesma disciplina do
// freio de fuga, pelo mesmo motivo: agir duas vezes sobre a mesma
// amostra e agir sobre um numero que ainda nao viu o que se fez.
static uint32_t voltaConta[2] = {0, 0};

void normalizarVolta() {
  // As mesmas guardas do seguidor: eixo parado, em MANUAL, sem solda e
  // sem assentamento. Renumerar no meio de uma rampa mudaria o destino
  // que o gerador de pulso ja esta perseguindo.
  if (modoAtual != MODO_MANUAL) return;
  if (motoresEmMovimento() || correcaoEmCurso()) return;
  if (soldaLigada()) return;

  for (uint8_t k = 1; k <= 2; k++) {
    Junta& j = (k == 1) ? J1 : J2;
    if (!j.motor || j.passosPorGrau <= 0.0f) continue;
    if (configEncoder.reg[k - 1] == 0) continue;
    if (!leituraConfiavel(k)) continue;

    const uint8_t i = k - 1;
    const LeituraEncoder L = encoderLer(k);
    if (L.leituras == voltaConta[i]) continue;   // amostra ja considerada
    voltaConta[i] = L.leituras;

    // A FAIXA DE TRABALHO comeca no curso calibrado; sem calibracao, meia
    // volta para cada lado do zero.
    //
    // A DOBRA E MEIO-ABERTA -- [lo, lo+360) --, e isso nao e preciosismo.
    // A primeira versao dobrava para o MEIO da faixa, com lroundf: num
    // curso de 0 a 360 o meio e 180, e 0 e 360 ficam os DOIS a exatamente
    // meia volta dele. lroundf desempata para longe do zero, entao 360
    // virava 0 e 0 virava 360, para sempre, um a cada leitura. Com o piso
    // nao ha empate: cada angulo tem um lugar so na faixa.
    // E A FAIXA PRECISA FAZER SENTIDO.
    //
    // grausMin sai de passosMin dividido por passosPorGrau, e os dois
    // andam por caminhos diferentes: o curso foi medido com a regua de
    // ontem e a resolucao pode ter mudado depois. Uma faixa maior que uma
    // volta nao escolhe volta nenhuma -- todas cabem nela --, e uma faixa
    // absurda escolhe a errada. Nos dois casos vale meia volta para cada
    // lado do zero, que nao depende de calibracao nenhuma.
    const float faixa = j.grausMax - j.grausMin;
    const bool  cursoUtil = j.calibrada && faixa > 1.0f && faixa <= 360.5f;
    const float lo    = cursoUtil ? j.grausMin : -180.0f;
    const float agora = L.graus;
    const long  n     = (long)floorf((agora - lo) / 360.0f);
    if (n == 0) continue;

    // Contagens por grau DA JUNTA, na mesma conta que encoder.cpp faz
    // para produzir o angulo: escala ensinada quando existe, senao o par
    // contagens-por-volta + reducao.
    const float cpgCfg = configEncoder.contagensPorGrau[i];
    const float cv     = configEncoder.contagensPorVolta[i];
    const float red    = (j.reducao > 0.001f) ? j.reducao : 1.0f;
    const float cpg    = (fabsf(cpgCfg) > 0.0001f) ? cpgCfg : (cv * red / 360.0f);
    if (fabsf(cpg) < 0.0001f) continue;

    // graus = (bruto - referencia)/cpg + grausHome. Para o angulo CAIR
    // 360n, a referencia SOBE 360n*cpg. O bruto nao e tocado -- ele e o
    // que o ferro respondeu, e continua sendo.
    const int32_t dRef = (int32_t)lroundf(360.0f * (float)n * cpg);
    const long    dPas = -lroundf(360.0f * (float)n * j.passosPorGrau);

    encoderCarregarReferencia(k, encoderReferencia(k) + dRef);
    ajustarContagem(j, ((k == 1) ? posicaoJ1() : posicaoJ2()) + dPas);
    // E o que estava gravado anda junto: os pontos descrevem lugares
    // FISICOS, e nenhum deles se mexeu -- so a origem da regua.
    progDeslocarPassos(k == 1 ? dPas : 0, k == 2 ? dPas : 0);
    trajDeslocarPassos(k == 1 ? dPas : 0, k == 2 ? dPas : 0);

    logEvento("junta %u: %.1f graus e a mesma postura que %.1f -- a "
              "numeracao voltou para a faixa de trabalho",
              (unsigned)k, (double)agora, (double)(agora - 360.0f * (float)n));
  }
}

void seguirEixoSolto() {
  // A contagem perdida se conserta com servo ligado ou desligado: e o
  // caso em que ela deixou de significar qualquer coisa.
  reancorarSeAContagemSePerdeu();

  if (!bracoQuieto()) return;
  if (correcaoEmCurso()) return;

  for (uint8_t k = 1; k <= 2; k++) {
    const uint8_t i = k - 1;
    Junta& j = (k == 1) ? J1 : J2;

    // A regra e POR JUNTA, e nao pela maquina inteira.
    //
    // Era "servosLigados" -- que so e verdade com AS DUAS juntas
    // energizadas. Numa bancada com um driver so isso nunca acontece, e
    // o seguimento de eixo solto ficava permanentemente ligado sobre uma
    // junta COM torque: a contagem era reescrita pelo encoder a cada
    // ciclo, inclusive logo depois de um destino ter sido calculado a
    // partir dela. Com torque, divergencia e perda de passo, e quem
    // cuida disso e o assentamento -- nao esta funcao.
    if (j.habilitado) continue;

    // Sem zero ensinado a leitura nao tem do que ser medida.
    if (!configZero.ensinado[i]) continue;
    if (configEncoder.reg[i] == 0) continue;
    if (j.passosPorGrau <= 0.0f) continue;

    const LeituraEncoder L = encoderLer(k);
    if (!L.valido || L.idadeMs > ENC_IDADE_MAX_MS) continue;
    // Mao nenhuma leva o braco para fora do curso que ele tem. Leitura
    // dali para fora nao e o eixo: e defeito, e obedecer a ela poria a
    // maquina inteira operando com uma posicao inventada.
    if (!leituraPlausivel(k, L.graus)) {
      avisarImplausivel(k, L.graus);
      continue;
    }

    const float conta = passosParaGraus(j, (k == 1) ? posicaoJ1() : posicaoJ2());
    const float dif = L.graus - conta;
    // Zona morta: encoder de 17 bits treme, e reescrever a contagem a
    // cada tremor encheria o barramento de nada. Dois decimos de grau e
    // menos que qualquer movimento de mao.
    if (fabsf(dif) < 0.2f) continue;

    ajustarContagem(j, grausParaPassos(j, L.graus));
  }
}

// =====================================================================
//  Travamento
// =====================================================================
static Travamento trav = {false, 0, 0};

Travamento correcaoTravamento() { return trav; }
void correcaoLimparTravamento() { trav.ativo = false; trav.junta = 0; }

// Quanto o eixo DEVERIA estar andando, em contagens do encoder por
// segundo, para a velocidade de pulso que esta saindo agora.
static float esperadoContagensPorSeg(uint8_t k) {
  const Junta& j = (k == 1) ? J1 : J2;
  const float hz = (k == 1) ? velocidadeJ1Hz() : velocidadeJ2Hz();

  // A ESCALA MEDIDA vem primeiro.
  //
  // Este vigia PARA o braco. Ele nao pode decidir isso a partir de dois
  // numeros de catalogo que ninguem conferiu: bastava o driver estar
  // configurado com outro numero de pulsos por volta para o esperado sair
  // varias vezes maior que o real, e ai um braco andando normalmente era
  // declarado travado meio segundo depois de arrancar -- "comeca a se
  // mover, aparece um aviso e para".
  //
  // Quando ha escala ensinada, ela e a regua certa: contagens por grau
  // medidas na propria maquina, do mesmo lado de onde vem a leitura que
  // vai ser comparada.
  const float cpg = configEncoder.contagensPorGrau[k - 1];
  if (j.passosPorGrau > 0.0f && (cpg > 0.0001f || cpg < -0.0001f))
    return fabsf(hz) / j.passosPorGrau * fabsf(cpg);

  // Sem escala ensinada, o caminho antigo: pulsos por volta do motor e
  // contagens por volta do encoder.
  const float cv = configEncoder.contagensPorVolta[k - 1];
  if (j.passosPorVolta == 0 || cv <= 0.0f) return 0.0f;
  // passos/s -> voltas do motor/s -> contagens/s
  return fabsf(hz) / (float)j.passosPorVolta * cv;
}

static void vigiarTravamento() {
  static uint32_t desde[2] = {0, 0};
  // Quantas leituras boas o encoder ja tinha entregue quando a suspeita
  // comecou. A diferenca ate agora diz se a janela foi preenchida por
  // medida ou por silencio.
  static uint32_t lidasAoArmar[2] = {0, 0};
  const uint32_t agora = millis();

  for (uint8_t k = 1; k <= 2; k++) {
    const uint8_t i = k - 1;

    // Sem leitura, sem julgamento: um cabo solto no encoder nao pode
    // parar o braco no meio de um cordao.
    // Leitura que nao merece confianca nao pode PARAR o braco no meio de
    // um cordao. "Confiavel" aqui e o mesmo criterio de todo o resto:
    // valida, recente e fisicamente possivel.
    if (!leituraConfiavel(k)) { desde[i] = 0; continue; }
    const LeituraEncoder L = encoderLer(k);

    // DOIS CRITERIOS, E O SEGUNDO NAO PRECISA DE ESCALA NENHUMA.
    //
    // Com escala medida da para exigir proporcao: "o eixo entrega menos
    // de um quinto do que deveria". E preciso, e pega ate escorregao
    // parcial.
    //
    // Sem escala medida essa conta sai de dois numeros de catalogo, e um
    // deles errado transforma braco andando em braco travado -- foi o que
    // fazia a maquina parar do nada. Mas ha um sinal que independe de
    // escala: o gerador de pulso claramente correndo e o encoder
    // claramente PARADO. Eixo que gira produz contagem, seja qual for a
    // escala; entao aqui nao existe falso positivo por numero errado.
    const float cpg = configEncoder.contagensPorGrau[i];
    const bool reguaMedida = (cpg > 0.0001f || cpg < -0.0001f);
    const float hz = (k == 1) ? velocidadeJ1Hz() : velocidadeJ2Hz();

    // O CRITERIO SEM ESCALA MANDA, SEMPRE.
    //
    // A conta proporcional parece a melhor das duas, e e -- quando as
    // duas reguas conversam. So que ela divide por passosPorGrau, que
    // vem do CATALOGO (pulsos por volta x reducao), e compara com
    // contagensPorGrau, que foi MEDIDO. Numa maquina em que os dois
    // discordam -- e discordar e o normal antes de calibrar --, o
    // esperado sai varias vezes maior que o real e um eixo andando
    // perfeitamente e declarado travado meio segundo depois de arrancar.
    // Era o "vai bem e no meio do caminho trava".
    //
    // Eixo que gira produz contagem, seja qual for a escala. Entao o
    // teste sem escala -- pulso claramente correndo, encoder claramente
    // PARADO -- e o unico que nao pode mentir por numero errado, e ele
    // passou a ser condicao NECESSARIA. Travamento de verdade passa nos
    // dois: eixo preso nao produz contagem nenhuma.
    if (hz < TRAV_HZ_MINIMO) { desde[i] = 0; continue; }
    if (fabsf(L.velocidade) > TRAV_CONTAGENS_QUIETO) { desde[i] = 0; continue; }

    // Com escala medida a conta proporcional ainda serve para REFINAR:
    // ela pega escorregao parcial que o teste acima deixaria passar. Mas
    // so estreita o criterio -- nunca inventa um travamento sozinha.
    if (reguaMedida) {
      const float esperado = esperadoContagensPorSeg(k);
      // Perto de zero a conta nao distingue eixo parado de eixo travado,
      // e nao precisa: eixo parado nao esta forcando contra nada.
      if (esperado < 200.0f) { desde[i] = 0; continue; }
      if (fabsf(L.velocidade) > esperado * 0.2f) { desde[i] = 0; continue; }
    }

    if (!desde[i]) { desde[i] = agora; lidasAoArmar[i] = L.leituras; continue; }
    // Meio segundo dando pulso sem o eixo responder. A leitura vem a 20
    // Hz: menos que isso seria julgar com duas ou tres amostras.
    //
    // E A JANELA TEM DE ESTAR CHEIA DE MEDIDA, nao so de tempo.
    //
    // Quando uma leitura falha, `velocidade` e zerada de proposito -- a
    // tela nao pode dizer que o eixo gira depois que o fio caiu. Mas esse
    // zero e o encoder CALADO, nao o eixo parado, e o teste acima nao
    // distingue os dois. Como a leitura so deixa de ser confiavel depois
    // de um segundo inteiro, sobrava meio segundo em que uma rajada de
    // falhas enchia a janela sozinha: o braco parava com "Junta travada"
    // no meio do cordao por causa do BARRAMENTO, nao do eixo. Num
    // barramento ruim -- que e exatamente quando isso acontece -- bastavam
    // tres respostas perdidas seguidas.
    //
    // Contando amostras que CHEGARAM, silencio nunca mais acusa: ou o
    // encoder respondeu e disse "parado", ou nao ha o que julgar.
    if ((uint32_t)(agora - desde[i]) > 500 &&
        (uint32_t)(L.leituras - lidasAoArmar[i]) >= TRAV_AMOSTRAS_MINIMAS) {
      desde[i] = 0;
      {
        // Parar o eixo e a acao, nao o aviso: continuar forcando contra o
        // batente aquece o servo e torce a mecanica.
        //
        // Quem observa `trav.total` la no laco principal interrompe o
        // movimento automatico -- programa, trajetoria, posicionamento.
        // Contar sem parar seria o movimento morrendo sem ninguem ter
        // mandado.
        if (trav.ativo) continue;
        trav.ativo = true;
        trav.junta = k;
        trav.total++;
        jogZerar();
        pararSuave();
        definirMensagem("Junta %u travada: o comando anda e o eixo nao. "
                        "Encostou no batente?", (unsigned)k);
      }
    }
  }
}

// ---------------------------------------------------------------------
// Vigilancia. Nao mexe no motor: so conta e avisa.
// ---------------------------------------------------------------------
static uint32_t alertas = 0;

uint32_t correcaoAlertas() { return alertas; }

// ---------------------------------------------------------------------
// Zona morta do ancoramento. O encoder de 17 bits treme; reescrever a
// contagem por centesimos nao muda nada e so gasta ciclo. Cinco
// centesimos de grau esta abaixo de qualquer coisa que o operador veja e
// bem acima do tremor.
static const float ANCORA_MORTA_GRAUS = 0.05f;

Ancoragem ancorarNoEncoder() {
  Ancoragem a = {0.0f, false, 0, false};

  // Nunca sobre eixo andando: reescrever a contagem no meio da rampa
  // muda o destino que o gerador de pulso ja esta perseguindo. Mas isso
  // TEM de aparecer: o movimento seguinte sai pela contagem, e quem
  // pediu um angulo pelo encoder precisa saber que nao foi assim.
  if (motoresEmMovimento() || correcaoEmCurso()) { a.andando = true; return a; }

  for (uint8_t k = 1; k <= 2; k++) {
    Junta& j = (k == 1) ? J1 : J2;
    // Junta sem encoder configurado nao e falha: e uma maquina que se
    // escolheu operar pela contagem, e ali nao ha nada a avisar.
    if (configEncoder.reg[k - 1] == 0) continue;
    if (j.passosPorGrau <= 0.0f) continue;
    // leituraConfiavel() ja cobre validade, idade e possibilidade fisica.
    if (!leituraConfiavel(k)) { a.semLeitura |= (uint8_t)(1u << (k - 1)); continue; }

    a.comEncoder = true;
    const LeituraEncoder L = encoderLer(k);
    const float conta = passosParaGraus(j, (k == 1) ? posicaoJ1() : posicaoJ2());
    const float dif   = L.graus - conta;
    if (fabsf(dif) < ANCORA_MORTA_GRAUS) continue;

    ajustarContagem(j, grausParaPassos(j, L.graus));
    if (fabsf(dif) > a.ajuste) a.ajuste = fabsf(dif);
    logEvento("contagem ancorada no encoder na junta %u: %.2f -> %.2f graus",
              (unsigned)k, (double)conta, (double)L.graus);
  }
  return a;
}

void correcaoVigiar() {
  if (!configCorrecao.vigiar) return;
  vigiarTravamento();

  // Enquanto o eixo anda, comandado e medido divergem de propria conta:
  // o encoder ve onde o eixo ESTA e o firmware conta onde ele MANDOU
  // estar, e entre os dois ha a rampa. Vigiar em movimento acusaria erro
  // que nao existe. So parado.
  if (motoresEmMovimento()) return;
  if (correcaoEmCurso()) return;

  static uint32_t desde[2] = {0, 0};
  static bool     avisado[2] = {false, false};
  const uint32_t agora = millis();

  for (uint8_t k = 1; k <= 2; k++) {
    // Aqui o alvo E o comandado: nao ha retoque em curso, entao a
    // contagem esta parada e as duas medidas coincidem.
    const float cmd = (k == 1) ? passosParaGraus(J1, posicaoJ1())
                               : passosParaGraus(J2, posicaoJ2());
    float e = 0.0f;
    if (!faltaPara(k, cmd, e) || fabsf(e) <= configCorrecao.alertaGraus) {
      desde[k - 1] = 0;
      avisado[k - 1] = false;
      continue;
    }
    if (!desde[k - 1]) { desde[k - 1] = agora; continue; }
    // Um segundo fora do limite, parado: nao e transiente de leitura.
    if (!avisado[k - 1] && (uint32_t)(agora - desde[k - 1]) > 1000) {
      avisado[k - 1] = true;
      alertas++;
      definirMensagem("Junta %u fora de posicao: %+.2f graus pelo encoder",
                      (unsigned)k, (double)e);
    }
  }
}

#ifdef ROBO2DOF_TESTE
void correcaoReiniciarTeste() {
  zImplausivel[0] = zImplausivel[1] = false;
  zGrausImplausivel[0] = zGrausImplausivel[1] = 0.0f;
  memset(&r, 0, sizeof(r));
  esperaAte = 0;
  alvo1Original = alvo2Original = 0;
  alvoGraus1 = alvoGraus2 = 0.0f;
  erroAnterior = 0.0f;
  semProgresso = 0;
  fechavelAnterior = 0.0f;
  esquecerGanho();
  esquecerAfericao();
  alertas = 0;
  // O fator do governador e a memoria de quanto a REGUA daquela maquina
  // exagera. Na maquina ele so some quando ela reinicia; no banco, um
  // cenario nao pode herdar o que o anterior aprendeu, senao a ordem em
  // que os cenarios rodam vira parte do resultado.
  govFator[0] = govFator[1] = 1.0f;
  govAprendeu[0] = govAprendeu[1] = false;
  voltaConta[0]    = voltaConta[1]    = 0;
  freioSentido[0]  = freioSentido[1]  = 0;
  freioConfirma[0] = freioConfirma[1] = 0;
  freioConta[0]    = freioConta[1]    = 0;
  freioFreou[0]    = freioFreou[1]    = false;
  correcaoEscalaZerar();
  largadaValida[0] = largadaValida[1] = false;
  temAlvoPedido = false;
  trav.ativo = false; trav.junta = 0; trav.total = 0;
  memset(&z, 0, sizeof(z));
  zeroDesde = 0; zeroComecou = false;
}
#endif
