P3drOk/P3drOk/Robo2dof/estado.cpp

#include "estado.h"
#include "armazenamento.h"   // logEvento no apagar tudo
#include "encoder.h"
#include <Preferences.h>
#include <stdarg.h>
#include <string.h>

Junta J1;
Junta J2;

float velNormal      = VEL_NORMAL_PADRAO;
float velMinima      = VEL_MIN_PADRAO;
float velMaxima      = VEL_MAX_PADRAO;
float velAuto        = VEL_AUTO_PADRAO;
float velCordaoMmS   = VEL_CORDAO_PADRAO;

float elo1Mm     = ELO1_PADRAO_MM;
float elo2Mm     = ELO2_PADRAO_MM;
float folgaDobra = FOLGA_DOBRA_PADRAO;
float envYMin    = ENV_Y_MIN_PADRAO;
float envRaioMin = ENV_RAIO_MIN_PADRAO;

bool protCurso    = PROT_CURSO_PADRAO;
bool protDobra    = PROT_DOBRA_PADRAO;
bool protEnvelope = PROT_ENVELOPE_PADRAO;

uint16_t escalaVelocidadeTraj = 100;
uint8_t  suavidadePartida     = SUAVIDADE_PADRAO;

ConfigEncoder configEncoder = {
  true, ENC_BAUD_PADRAO, ENC_PARIDADE_PADRAO, ENC_FUNCAO_PADRAO,
  ENC_PERIODO_PADRAO, true, ENC_BAIXA_PRIMEIRO,
  // Junta 2 nasce com registrador 0 = NAO LIGADA. Perguntar a um driver
  // que nao existe so gasta metade do barramento com tempo esgotado, e
  // enche a tela de falha que nao e falha.
  {1, 2}, {ENC_REG_PADRAO, 0},
  {ENC_CONTAGENS_PADRAO, ENC_CONTAGENS_PADRAO},
  // Escala direta NAO ensinada de fabrica: enquanto for 0 vale o caminho
  // antigo inteiro, e quem ja tinha a maquina andando continua andando.
  {0.0f, 0.0f}
};
// Assentamento: ligado de fabrica, com numeros conservadores.
//
// 0,10 grau de tolerancia: abaixo disso o retoque seria menor que a
// propria resolucao de leitura em muitas montagens, e o eixo ficaria
// cutucando sem parar.
//
// 3 graus de teto: acima disso o problema nao e folga. E acoplamento
// solto, registrador errado ou reducao errada -- e empurrar o braco tres
// graus achando que esta consertando e o jeito mais rapido de bater a
// ferramenta em alguma coisa.
ConfigCorrecao configCorrecao = {
  true,    // ativa
  0.10f,   // toleranciaGraus
  3.00f,   // maxCorrecaoGraus
  3,       // tentativas
  true,    // vigiar
  1.00f,   // alertaGraus
};

// A maquina se localiza sozinha ao ligar, e vai para o zero.
//
// Ir para o zero SO acontece depois que o operador habilita os servos --
// que e uma acao explicita dele, na tela. E o intertravamento natural:
// enquanto ninguem habilitar, o braco nao tem como andar, por mais que
// esta chave esteja ligada.
ConfigZero configZero = { true, true, 0.30f, {false, false} };

// O habilita, agora que ele mora no barramento e nao num pino. Os
// padroes sao os PROVADOS na bancada desta maquina (teste_rs485, modos
// d/d2/s): P098 do painel = registrador 98, 1 habilita, 0 desabilita,
// pela funcao 06.
ConfigSon configSon = {
  SON_REG_PADRAO, SON_VAL_LIGA_PADRAO, SON_VAL_DESL_PADRAO, false
};

ConfigEncoder encoderPendente = configEncoder;

Modo        modoAtual     = MODO_MANUAL;
EstadoCalib estadoCalib   = CAL_INATIVO;
bool        servosLigados = false;
bool        movimentoSeguro = false;
char        ultimaMensagem[96] = "Sistema iniciado";

QueueHandle_t filaComandos = nullptr;

volatile bool pedidoParada    = false;
bool          movimentoLiberado = false;

ConfigPendente configPendente;

volatile uint32_t ultimoContatoOperadorMs = 0;

static Snapshot      snapshotAtual;
static portMUX_TYPE  muxSnapshot = portMUX_INITIALIZER_UNLOCKED;
static Preferences   prefs;

// ---------------------------------------------------------------------
// A resolucao de cada junta vem da engrenagem eletronica do driver
// multiplicada pela reducao mecanica daquele eixo. Sao numeros
// CONHECIDOS, nao medidos. Os limites em graus sao reconvertidos aqui
// para nunca ficarem incoerentes com a resolucao vigente.
void recalcularResolucao() {
  Junta* js[2] = { &J1, &J2 };
  for (uint8_t i = 0; i < 2; i++) {
    Junta& j = *js[i];
    j.passosPorGrau = (j.passosPorVolta * j.reducao) / 360.0f;
    if (j.passosPorGrau > 0.0f) {
      j.grausMin = j.passosMin / j.passosPorGrau + j.grausHome;
      j.grausMax = j.passosMax / j.passosPorGrau + j.grausHome;
    }
  }
}

// ---------------------------------------------------------------------
bool enviarComando(TipoComando tipo, int32_t a, int32_t b, float f1, float f2) {
  if (!filaComandos) return false;
  Comando c;
  c.tipo = tipo; c.a = a; c.b = b; c.f1 = f1; c.f2 = f2;
  c.nome[0] = '\0';
  return xQueueSend(filaComandos, &c, 0) == pdTRUE;
}

bool enviarComandoNomeado(TipoComando tipo, const char* nome,
                          int32_t a, int32_t b) {
  if (!filaComandos) return false;
  Comando c;
  c.tipo = tipo; c.a = a; c.b = b; c.f1 = 0.0f; c.f2 = 0.0f;
  strncpy(c.nome, nome ? nome : "", MAX_NOME_ARQ);
  c.nome[MAX_NOME_ARQ] = '\0';
  return xQueueSend(filaComandos, &c, 0) == pdTRUE;
}

// A parada nao passa pela fila: ver estado.h.
void solicitarParada() {
  pedidoParada = true;
}

void limparFilaComandos() {
  if (!filaComandos) return;
  Comando descarte;
  while (xQueueReceive(filaComandos, &descarte, 0) == pdTRUE) { }
}

void registrarContatoOperador() {
  ultimoContatoOperadorMs = millis();
}

// ---------------------------------------------------------------------
void publicarSnapshot(const Snapshot& s) {
  portENTER_CRITICAL(&muxSnapshot);
  snapshotAtual = s;
  portEXIT_CRITICAL(&muxSnapshot);
}

void lerSnapshot(Snapshot& destino) {
  portENTER_CRITICAL(&muxSnapshot);
  destino = snapshotAtual;
  portEXIT_CRITICAL(&muxSnapshot);
}

// definirMensagem() e chamada de dentro do laco de 1 ms do core 1 (o jog
// de recuperacao chamava a cada ciclo). Serial.print() BLOQUEIA quando o
// buffer de TX enche, e quem trava e o laco que roda supervisionar() -
// uma frase informativa passando na frente da supervisao de seguranca.
//
// A mensagem sempre atualiza (a interface ve tudo). O eco na serial e que
// e poupado: repeticao identica nao imprime, e ha um piso de 50 ms entre
// impressoes, o que limita a UART a ~9% da banda.
void definirMensagem(const char* fmt, ...) {
  static uint32_t ultimoEcoMs = 0;

  char buf[sizeof(ultimaMensagem)];
  va_list args;
  va_start(args, fmt);
  vsnprintf(buf, sizeof(buf), fmt, args);
  va_end(args);

  const bool repetida = (strcmp(buf, ultimaMensagem) == 0);
  memcpy(ultimaMensagem, buf, sizeof(ultimaMensagem));
  if (repetida) return;

  const uint32_t agora = millis();
  if (ultimoEcoMs != 0 && (agora - ultimoEcoMs) < 50) return;
  ultimoEcoMs = agora;

  Serial.print("[MSG] ");
  Serial.println(ultimaMensagem);
}

// ---------------------------------------------------------------------
// Configuracao: preparo no core 0, aplicacao no core 1.
// ---------------------------------------------------------------------
void prepararConfigPendente() {
  configPendente.velNormal    = velNormal;
  configPendente.velMinima    = velMinima;
  configPendente.velMaxima    = velMaxima;
  configPendente.velAuto      = velAuto;
  configPendente.fVel1        = J1.fatorVel;
  configPendente.fVel2        = J2.fatorVel;
  configPendente.velCordaoMmS = velCordaoMmS;
  configPendente.acel1        = J1.aceleracao;
  configPendente.acel2        = J2.aceleracao;
  configPendente.ppv1         = J1.passosPorVolta;
  configPendente.ppv2         = J2.passosPorVolta;
  configPendente.red1         = J1.reducao;
  configPendente.red2         = J2.reducao;
  configPendente.inv1         = J1.inverterDir;
  configPendente.inv2         = J2.inverterDir;
  configPendente.escalaTraj   = escalaVelocidadeTraj;
  configPendente.suavidade    = suavidadePartida;
  configPendente.elo1         = elo1Mm;
  configPendente.elo2         = elo2Mm;
  configPendente.folgaDobra   = folgaDobra;
  configPendente.envY         = envYMin;
  configPendente.envRaio      = envRaioMin;
  configPendente.protCurso    = protCurso;
  configPendente.protDobra    = protDobra;
  configPendente.protEnvelope = protEnvelope;

  // A area de preparo e tambem a forma canonica do backup: quem a
  // preenche a partir do estado vivo esta descrevendo a maquina inteira,
  // e a calibracao faz parte dela.
  configPendente.temCalib = true;
  configPendente.cal1  = J1.calibrada;   configPendente.cal2  = J2.calibrada;
  configPendente.p1Min = J1.passosMin;   configPendente.p1Max = J1.passosMax;
  configPendente.p2Min = J2.passosMin;   configPendente.p2Max = J2.passosMax;
  configPendente.home1 = J1.grausHome;   configPendente.home2 = J2.grausHome;

  configPendente.temMesa      = true;
  configPendente.mesaDefinida = areaMesa.definida;
  configPendente.mesaCantos   = areaMesa.cantos;
  configPendente.mesaXMin     = areaMesa.xMin;
  configPendente.mesaXMax     = areaMesa.xMax;
  configPendente.mesaYMin     = areaMesa.yMin;
  configPendente.mesaYMax     = areaMesa.yMax;
}

void aplicarConfigPendente() {
  velNormal         = configPendente.velNormal;
  velMinima         = configPendente.velMinima;
  velMaxima         = configPendente.velMaxima;
  velAuto           = configPendente.velAuto;
  J1.fatorVel       = configPendente.fVel1;
  J2.fatorVel       = configPendente.fVel2;
  velCordaoMmS      = configPendente.velCordaoMmS;
  J1.aceleracao     = configPendente.acel1;
  J2.aceleracao     = configPendente.acel2;
  J1.passosPorVolta = configPendente.ppv1;
  J2.passosPorVolta = configPendente.ppv2;
  J1.reducao        = configPendente.red1;
  J2.reducao        = configPendente.red2;
  J1.inverterDir    = configPendente.inv1;
  J2.inverterDir    = configPendente.inv2;
  escalaVelocidadeTraj = configPendente.escalaTraj;
  suavidadePartida     = configPendente.suavidade;
  elo1Mm            = configPendente.elo1;
  elo2Mm            = configPendente.elo2;
  folgaDobra        = configPendente.folgaDobra;
  envYMin           = configPendente.envY;
  envRaioMin        = configPendente.envRaio;
  protCurso         = configPendente.protCurso;
  protDobra         = configPendente.protDobra;
  protEnvelope      = configPendente.protEnvelope;

  // A calibracao so e tocada quando o arquivo REALMENTE tem uma. Um
  // backup gravado pela versao anterior nao carrega estes campos, e
  // aplicar zeros ali apagaria o curso medido da maquina.
  if (configPendente.temCalib) {
    J1.calibrada = configPendente.cal1;
    J2.calibrada = configPendente.cal2;
    J1.passosMin = configPendente.p1Min;  J1.passosMax = configPendente.p1Max;
    J2.passosMin = configPendente.p2Min;  J2.passosMax = configPendente.p2Max;
    J1.grausHome = configPendente.home1;
    J2.grausHome = configPendente.home2;
  }

  // Mesma regra da calibracao: so mexe quando o arquivo REALMENTE traz
  // uma mesa. Backup antigo nao apaga a area ensinada.
  if (configPendente.temMesa) {
    areaMesa.definida = configPendente.mesaDefinida;
    areaMesa.cantos   = configPendente.mesaCantos;
    areaMesa.xMin     = configPendente.mesaXMin;
    areaMesa.xMax     = configPendente.mesaXMax;
    areaMesa.yMin     = configPendente.mesaYMin;
    areaMesa.yMax     = configPendente.mesaYMax;
  }

  recalcularResolucao();
}
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
