P3drOk/P3drOk/(commit log)

2026-08-21 Banco de testes executavel e relatorio de anomalias do RoboCNC v6
    Compila os modulos reais do firmware contra mocks de Arduino,
    FastAccelStepper, NVS e FreeRTOS, e roda 14 cenarios de operacao no PC.
    15 anomalias reproduzidas, entre elas:
    - CMD_PARAR descartado quando a fila enche de heartbeat de jog, com o
    handler HTTP respondendo "ok" mesmo assim
    - jog e reproducao movem o contador de passos com os drivers desabilitados
    - faixa da margem de seguranca sem saida: posturaValida() usa a margem e
    gravidadeViolacao() nao, entao o jog de recuperacao nunca libera
    - calibracao aceita curso de 0,4 grau e tranca os dois eixos
    - queda de conexao durante a solda nao chama progParar(): estado conge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
2026-08-21 Corrige as anomalias de severidade 1 do RoboCNC (mais S2.1, S2.2, S3.1)
    Banco de testes: 2 passaram/15 anomalias -> 26 passaram/1 anomalia.
    Seguranca
    - parada de emergencia sai da fila: solicitarParada() escreve uma flag
    volatil testada no topo do loop(), e pararTudo() descarta a fila para
    que os heartbeats de jog pendentes nao religuem o movimento; os demais
    handlers respondem 503 quando enviarComando() falha, em vez de "ok"
    - emergencia fisica vira condicao de nivel: CMD_SERVOS(1) recusado
    enquanto o botao estiver acionado e torque derrubado a cada ciclo
    - portao unico movimentoLiberado (servos, alarme, estop, emergencia,
    conexao, falha) barra jog, reproducao, programa e posic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
    [Arduino.h, FastAccelStepper.h, RoboCNC.ino, WebServer.h, banco.cpp, calibracao.cpp, cinematica.cpp, cinematica.h]
2026-08-21 Cartao microSD, joystick proporcional e interface como aplicativo
    Tres frentes, sem quebrar nada do que ja existia: banco de firmware em
    45 passaram / 1 anomalia (a que resta e a A13, severidade 3 conhecida e
    nao corrigida) e banco de interface em 24 passaram / 0 falharam.
    CARTAO MICROSD
    - novo modulo armazenamento.h/.cpp com tarefa dedicada no core 0. O core
    1 nunca toca no SPI: gravar num SD leva de dezenas a centenas de ms e
    dentro do laco de 1 ms pararia a supervisao de seguranca junto
    - conversa entre nucleos por area de troca (staging de programa, area de
    config pendente, ou o buffer de trajetoria emprestado) mais um Comando
    na fila; Comando ganhou campo de nome de arquivo
    - /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
    [FS.h, RoboCNC.ino, SD.h, SPI.h, armazenamento.cpp, armazenamento.h, banco.cpp, config.h]
2026-08-21 Corrige controles mortos na interface e documenta as ligacoes do ESP32
    O relato era "Gravar ponto" e "Ir para o zero" nao fazem nada. A
    auditoria clicou todo controle num Chromium de verdade e comparou as
    rotas registradas no firmware com as chamadas da interface.
    CAUSA DOS DOIS BOTOES
    - a sanfona era global: abrir uma secao removia .aberta de TODAS as .et
    da pagina, nao so as do mesmo painel. Como a aba Mover tem uma secao
    so, abrir "Ensaiar sem arco" na aba Programa recolhia o joystick,
    "Gravar ponto" e "Ir para o zero" -- que ao voltar pareciam mortos.
    Agora fecha apenas dentro do .pane, e so em cabecalho que tem seta;
    joystick e cartao nao recolhem
    - botao desabilitado era mud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
    [conferir_ligacoes.py, servidor_falso.py, testar_ui.js]
2026-08-21 Recusas com contexto, conferencia por trecho e controle por Bluetooth
    A queixa era "ponto do cordao no fim do curso mesmo estando dentro".
    Reproduzido no banco antes de mexer em qualquer linha: a maquina estava
    CERTA. Num braco 2R, aproximar a ponta da base obriga o cotovelo a
    dobrar, e a reta cartesiana entre dois pontos folgados pode exigir muito
    mais curso do que as pontas -- no cordao do teste, theta2 = 80 nas pontas
    e 133 no meio, com curso de 90. A mensagem e que nao dizia nada.
    MENSAGENS DE RECUSA
    - struct Violacao carrega causa, junta, valor exigido, limite e a fracao
    do percurso; violacaoTexto() monta a frase
    - relata a PIOR violacao do percurso, nao a primeira: a primeira desse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
2026-08-22 Particao de 3 MB no projeto e pagina servida comprimida
    "Sketch too big": 1721921 bytes contra os 1310720 da particao padrao do
    ESP32. Nao e o codigo, e o mapa de memoria do flash -- Wi-Fi + servidor
    web + BLE nao cabem em 1,25 MB.
    PARTICAO
    - partitions.csv na pasta do sketch com 3 MB de app. O nucleo
    Arduino-ESP32 usa esse arquivo quando ele esta junto do .ino, entao a
    particao certa passa a fazer parte do projeto em vez de depender de
    alguem lembrar de um menu. Menu (Huge APP) continua documentado como
    alternativa
    - o nvs fica no mesmo endereco e tamanho do esquema padrao: a calibracao
    ja salva sobrevive a troca
    - com 3 MB o mesmo sketch ocupa 55%, com 1,4 MB de sobra
    PAGINA CO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
    [partitions.csv]
2026-08-22 Remove o controle por Bluetooth
    Pedido para reduzir o tamanho do sketch: a pilha BLE era de longe o maior
    pedaco do firmware. Removido por inteiro, nada de flag desligada deixando
    codigo morto no repositorio.
    FIRMWARE
    - controle_bt.h/.cpp apagados
    - config.h: BLUETOOTH_INSTALADO, BT_NOME, BT_TIMEOUT_JOG_MS e
    BT_DEBOUNCE_MS fora
    - .ino: btIniciar()/btAtualizar() fora; a tarefa de rede volta a ser so o
    servidor web
    - servidor_web.cpp: campo "bt" fora do JSON de status (pior caso do
    buffer volta de 893 para 882 bytes)
    - pagina_web.h: lampada e nota do gamepad fora; pagina comprimida
    regenerada (74502 -> 21553 bytes)
    - estado.h: registrarContatoOperador() continua com o nome, que descre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
    [partitions.csv]
2026-08-22 Calibracao afere a resolucao e a origem; curso calibrado aparece na tela
    A pergunta era: com os fins de curso calibrados, como o firmware sabe em
    quantos graus a junta esta? Ele conta PULSOS -- a medicao e do robo --
    mas a conversao para graus dividia por passosPorGrau, que vem de dois
    numeros DIGITADOS. Errado qualquer um, o braco real fica numa posicao e o
    da tela em outra. Faltava tambem a origem: a cinematica chama de zero o
    braco esticado apontando para +X, e o HOME zerava onde quer que o
    operador estivesse, o que gira o desenho inteiro.
    AFERICAO DA ESCALA
    - a ultima etapa do assistente mostra o curso calculado e pergunta quanto
    ele foi de verdade. Informado, o firmware refaz a conta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
2026-08-22 Modo de instalacao, apagar calibracao e inverter sentido do eixo
    Tres queixas, tres causas distintas.
    1. BRACO TRAVANDO DURANTE A CALIBRACAO
    O comentario de posturaValidaDet dizia "sem calibracao nao existe
    geometria confiavel para proteger nada", mas so a checagem de CURSO
    honrava isso: protDobra e protEnvelope seguiam ativas sobre um angulo que
    ainda e pulso dividido por um numero digitado, mais o offset da
    calibracao anterior. Com a resolucao errada, um movimento pequeno lia
    |theta2| > 160 e o jog era recusado -- travando justamente o assistente
    que existe para estabelecer a referencia.
    - sem calibracao valida, posturaValidaDet devolve true e gravidadeViolacao
    devolve zero: modo de ins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
2026-08-22 Velocidades em graus/s e area alcancavel desenhada em polares
    Duas queixas com a mesma raiz e uma de desenho.
    UM BRACO MAIS RAPIDO QUE O OUTRO
    Hz significa coisas diferentes em cada junta. Com a engrenagem do
    operador -- reducao 16,5 na junta 1 e 4 na junta 2 -- os mesmos 3000 Hz
    davam 6,5 graus/s numa e 27 na outra: 4,1 vezes de diferenca, sem ajuste
    que igualasse sem refazer a conta a mao. A rampa tinha o mesmo problema:
    17 graus/s2 numa e 72 na outra.
    - velNormal, velPrecisao, velAuto passam a ser GRAUS/s; a rampa de cada
    junta passa a ser GRAUS/s2. Cada eixo converte com o seu proprio
    passosPorGrau e FREQ_PULSO_MAX_HZ segue sendo o teto do driver
    - moverCoordenado passa a receber gr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
    [banco.cpp, calibracao.cpp, config.h, estado.cpp, estado.h, motores.cpp, motores.h]
2026-08-22 Desenho na mesa, zerar na posicao, aferir reducao e rampa em S
    Cinco queixas de uso real, todas reproduzidas antes de mexer no codigo.
    Velocidade de cordao nao salvava. handleConfig aceitava "velC" (nome
    antigo) e "velCordao", mas dava prioridade ao antigo usando o valor VIVO
    como padrao dele. Como a pagina so manda "velCordao", o ausente sempre
    vencia com o valor que ja estava. Agora o handler olha qual dos dois
    nomes realmente veio.
    Tranco na partida. Aceleracao constante entra de uma vez no instante da
    partida, e e isso que se sente. suavidadePartida (0-255, padrao 120, NVS
    "suav") liga a rampa em S do FastAccelStepper nas duas juntas. Alem
    disso, seguirSetpoint() parou de chamar setSpe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
2026-08-22 Trava o ramo do cotovelo no cordao: era o braco "fugindo" no ziguezague
    Queixa: com varios pontos em ziguezague o braco largou a reta e fez uma
    volta. Reproduzido, e a causa e a A13 -- a anomalia que este banco
    carregava desde a primeira rodada.
    resolverXY() escolhe entre os dois ramos do cotovelo pelo criterio "o que
    exige menos movimento agora", e atualizarReta() o chamava a cada 1,5 mm
    do cordao. Perto do braco esticado os dois ramos praticamente coincidem:
    um ruido de arredondamento troca a escolha no meio da reta, e a troca de
    ramo e uma descontinuidade de ate 2 x |theta2| no espaco das juntas. Na
    chapa isso e o braco largar a reta e ir ate a postura espelhada.
    Com os elos do operador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
    [banco.cpp, cinematica.cpp, cinematica.h, config.h, motores.cpp, programa.cpp, programa.h]
2026-08-22 Importar DXF, posicionar na mesa e salvar sem botao mudo
    DXF
    ---
    O arquivo e lido no navegador; o ESP32 recebe a lista de pontos pronta,
    pela mesma rota POST /api/prog/desenho do traco a dedo -- mesma
    validacao, mesma area de troca, mesmo CMD_ARQ_APLICAR_PROG. Um DXF de
    300 kB nao cabe na RAM do ESP32, e um leitor de DXF em C ocuparia flash
    que a maquina precisa para o resto.
    - Entidades: LINE, LWPOLYLINE (com bulge), POLYLINE, ARC, CIRCLE. Texto,
    cotas e hachuras sao contados e ignorados.
    - Contornos com as pontas encostadas sao emendados: um retangulo sai do
    CAD como quatro LINE soltas e viraria quatro cordoes. Depois sao
    ordenados pelo mais proximo do fim do anterior.
    - Arcos e cir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
    [peca.dxf]
2026-08-22 Documenta o cartao SD: por que ele nao amplia memoria e o que fazer
    CARTAO_SD.md responde a pergunta de fundo com o motivo tecnico: o ESP32
    executa da flash interna porque a MMU a MAPEIA no espaco de enderecos
    (execute in place); o cartao e um dispositivo de bloco num barramento
    SPI, sem endereco no mapa de memoria -- busca de instrucao nao pode
    passar por driver. Pelo mesmo motivo ele tambem nao vira malloc.
    Junto: os dois limites que se esgotam por motivos diferentes (3 MB de
    flash para codigo, 320 kB de RAM para dados), de onde veio o "Sketch too
    big" (esquema padrao de 1,25 MB, nao o partitions.csv do projeto), as
    saidas reais (remover o spiffs, modulo N8/N16, WROVER com PSRAM,
    streamin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
2026-08-22 ROADMAP.md: o que o software e hoje e o que falta
    Avaliacao pedida pelo operador. Separa as tres perguntas de valor que sao
    sempre confundidas (custo de reposicao, valor embutido na maquina,
    licenciamento) e diz o que hoje derruba o valor -- e nada disso e codigo:
    falta avaliacao de risco NR-12, o botao de emergencia fisico nao esta
    instalado, os fios ALM dos drivers nao estao ligados e o sistema roda em
    malha aberta.
    Melhorias em quatro niveis, ordenadas por retorno. As tres primeiras
    (sensores de origem com homing automatico, realimentacao de encoder dos
    T3D, emergencia fisica e ALM) sao hardware barato com mudanca pequena de
    firmware, e valem mais que qualquer funcao nova.
    Co-Authored-B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
2026-08-23 Rede: ponto de acesso proprio e rede da oficina ao mesmo tempo
    O radio sobe em WIFI_AP_STA. O Wi-Fi da propria maquina nunca sai do ar,
    mesmo com ela dentro da rede da oficina -- e a saida de emergencia
    quando o roteador cai, a senha muda ou o sinal nao chega no fundo do
    galpao. Nao ha como desliga-lo, e e de proposito: um equipamento que se
    move nao pode ficar inacessivel por causa da rede de outra pessoa.
    Endereco sempre o mesmo:
    http://192.168.4.1 pelo Wi-Fi da maquina (IP fixado pelo projeto em
    WIFI_AP_IP, nao herdado do padrao da biblioteca)
    http://robo2dof.local por qualquer uma das duas, via mDNS anunciado
    nas duas interfaces; tamb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
    [Arduino.h, ESPmDNS.h, Preferences.h, RoboCNC.ino, WebServer.h, WiFi.h, banco.cpp, config.h]
2026-08-23 Corrige rede.cpp na IDE e o mock de WiFi que escondeu o erro
    Erro do operador ao compilar:
    cannot convert 'String' to 'const char*' -- WiFi.SSID(i)
    invalid user-defined conversion from 'IPAddress' to 'const char*'
    -- WiFi.localIP()
    O codigo estava errado, mas o defeito de fundo e do banco: o mock de WiFi
    devolvia const char* onde o core do ESP32 devolve String e IPAddress.
    Compilou limpo aqui e falhou na maquina do operador.
    - rede.cpp guarda WiFi.SSID(i) numa String com nome (o c_str() de um
    temporario e ponteiro pendurado) e usa WiFi.localIP().toString().
    - O mock devolve String e IPAddress; IPAddress ganhou toString() e NAO
    converte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
    [Arduino.h, Preferences.h, WiFi.h, pagina_web_gz.h, rede.cpp]
2026-08-23 Remove o modo estacao: um radio so nao divide sem custo
    Pedido do operador, com a queixa certa -- a maquina ficou mais lenta e o
    joystick com atraso depois que o modo estacao entrou. A queixa tem
    mecanismo:
    O ESP32 tem UM radio. Em WIFI_AP_STA o ponto de acesso e obrigado a
    acompanhar o canal do roteador e o radio divide tempo de antena entre as
    duas redes. O heartbeat do jog, que corta o movimento se faltar por
    350 ms, e justamente o trafego que nao pode atrasar. Rede de terceiro nao
    vale latencia no controle de uma maquina que se move.
    Removido: varredura de redes, escolha e senha pelo painel, credenciais no
    NVS (wssid/wsenha), CMD_APLICAR_REDE, RedePendente, aplicarRedePendente,
    a maqui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
2026-08-23 Sentido do eixo: rotulo honesto e conserto dentro da calibracao
    Queixa: "clico na seta para a esquerda na calibracao e o braco vai no
    sentido horario". Eram duas coisas diferentes, e so uma era a que o
    operador achava.
    1. O rotulo estava errado, nao o movimento.
    Os botoes de jog eram <- -> na junta 1 e v ^ na junta 2. Junta e coisa
    que GIRA: seta para os lados nao quer dizer nada, porque para que lado a
    ponta anda depende de onde o braco esta. A convencao e theta crescente no
    anti-horario, entao <- (theta-) girava no horario -- correto pela
    convencao e ilegivel na tela.
    Os botoes passaram a falar em rotacao: anti-horario e horario, olhando o
    eixo de cima. As setas do teclado acompanham. A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
2026-08-23 Ferramenta de diagnostico de RS485/Modbus para o driver T3D
    Sketch avulso (ferramentas/teste_rs485/), fora do firmware da maquina,
    mais um documento com a parte de hardware -- que e onde provavelmente
    esta o problema.
    O sketch NAO chuta registrador. O mapa Modbus do T3D varia por versao de
    firmware e nao esta publicado; endereco pronto aqui seria adivinhacao. O
    que ele faz e descobrir:
    1 autoteste do modulo por loopback (DE=1 e RE=0 juntos: o MAX485 dirige
    o par e le de volta o que ele mesmo colocou la). Prova a fiacao
    ESP32<->MAX485 sem depender do driver. Se falhar, procurar o driver e
    perda de tempo.
    2 escuta: dump de quadros com CRC conferido. O caminho mais rapido de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
    [teste_rs485.ino]
2026-08-23 ROADMAP: Modbus nao substitui o encoder para perda de passo
    Cada leitura Modbus custa de 5 a 20 ms com jitter alto. Serve para
    mostrar posicao e ler alarme; para malha fechada o caminho e a saida
    PA/PB do driver num contador PCNT. Aponta para a ferramenta de
    diagnostico do RS485.
    Claude-Session: https://claude.ai/code/session_01LrifcSzxwDGvnSVdAbHC25
2026-08-23 Corrige o resumo da varredura RS485 e adiciona cacar/monitorar
    BUG QUE DERRUBOU O DIAGNOSTICO DO OPERADOR
    O resumo do modo 3 imprimia baudAtual e paridadeAtual, que sao as
    VARIAVEIS DO LACO da varredura. No fim elas ficam com a ultima
    combinacao tentada, nao com a que funcionou -- e a ultima celula do laco
    e justamente 250000 8O1 (ultimo baud do vetor, ultima paridade).
    A varredura achava o driver de verdade (id 1, funcao 4 -- esses dois
    eram corretos, porque sao gravados no momento do achado) e anunciava a
    velocidade errada. Os modos seguintes passavam a falar em 250000 8O1,
    nao ouviam nada, e a tela ficava vazia.
    Agora os achados vao para uma tabela e o resumo lista TODOS, com baud,
    par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
    [teste_rs485.ino]
2026-08-23 Monitor RS485: velocidade e as duas montagens de 32 bits lado a lado
    O operador conseguiu comunicacao e chegou por conta propria ao mesmo
    conserto do resumo da varredura (guardar baud e paridade no momento do
    achado, nao no fim do laco). A versao dele trouxe uma coluna que a minha
    nao tinha: velocidade em unidades por segundo, que e o que confirma na
    hora se o registrador acompanha o eixo.
    Consolidado numa versao so:
    - coluna de velocidade, calculada pela montagem de 32 bits que variou
    MENOS em modulo -- a montagem errada da saltos enormes e envenenaria a
    conta;
    - as duas montagens (alto|baixo e baixo|alto) continuam lado a lado.
    Muito driver Modbus manda a palavra BAIXA primeiro; ol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
2026-08-23 Encoder por Modbus: leitura ao vivo e grafico do erro
    Aba Encoder nova: comandado, medido e ERRO por junta, com grafico do
    erro nos ultimos instantes. Linha reta em zero quer dizer que o braco foi
    para onde foi mandado; degrau ou deriva quer dizer passo perdido.
    Tarefa propria no core 0, mestre Modbus RTU escrito a mao, um barramento
    RS485 com os dois drivers em enderecos diferentes. Pinos 21/22/4/26.
    O REGISTRADOR E CONFIGURAVEL, e tem de ser: o mapa Modbus do T3D nao e
    publicado e muda por versao de firmware. Numero fixo no codigo seria
    adivinhacao, e o segundo driver pode vir diferente. O despejo que o
    operador trouxe confirma que a faixa 0..255 e a tabela de parametros --
    pares simetri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
    [Arduino.h, HardwareSerial.h, RoboCNC.ino, banco.cpp, config.h, encoder.cpp, encoder.h, estado.cpp]
2026-08-23 Encoder: registrador achado, corrida entre nucleos e as duas rodinhas
    O operador rodou o diagnostico e trouxe os numeros. Eles respondem tudo:
    funcao 4 (input registers), NAO 3 -- a funcao 3 e a tabela de
    parametros, reconhecivel pelos pares simetricos (+250/-250, +80/-80)
    e pelo 0x5E07 repetido trinta vezes. Nada ali muda com o eixo.
    registrador 5 (palavra baixa) + 6 (palavra alta), baixa primeiro.
    girando a mao o par foi de 143535 para 283363: 139828 contagens, ou
    1,067 volta num encoder de 17 bits. Nenhuma outra resolucao fecha.
    os registradores 20 e 34 sao espelhos do mesmo contador.
    Isso virou o padrao de fabrica, e um 0 guardado no NVS por versao
    anterior passou a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
2026-08-23 encoder: fazer a leitura Modbus funcionar na maquina, nao so na bancada
    O operador ligou um driver, abriu a aba Encoder e viu "0 leituras, 222
    falhas" nas duas juntas -- com o mesmo motor, driver e fiacao que
    respondem sem erro ao programa de bancada ferramentas/teste_rs485.
    Quando o teste passa e a maquina falha, a diferenca esta no que o
    sistema faz diferente do teste. Sao cinco:
    1. A pergunta que ninguem nunca fez ao driver. A posicao tem 32 bits, e
    o firmware pedia os DOIS registradores de uma vez. O programa de
    bancada le UM por pergunta, sempre -- entao a unica forma comprovada
    neste driver era a que o sistema nao usava. Agora comeca na dupla
    (atomica, barata), cai sozinh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
2026-08-23 encoder: DE pelo hardware, e desfazer configuracao velha no NVS
    O operador mandou o programa que de fato usou. Ele mata a hipotese da
    rodada anterior: os modos 4 e 6 leem OITO registradores por pergunta e
    funcionam, entao o driver aceita leitura multipla e nao era isso o
    "222 falhas". O recuo automatico fica no codigo como robustez, nao como
    conserto. ACHADOS.md corrige o registro.
    Fechada essa porta, sobra a diferenca que nenhuma leitura de codigo
    descarta: o programa de bancada esta sozinho na placa, o sistema nao.
    1. A janela entre o ultimo bit e baixar o DE. Depois de flush() o
    firmware espera dois tempos de caractere antes de baixar o DE -- e
    durante essa espera o MAX485 continu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
    [banco.cpp, config.h, encoder.cpp, estado.cpp, estado.h, mocks.cpp, pagina_web_gz.h]
2026-08-24 encoder: autoteste da linha RS485 por dentro do sistema rodando
    A tela diz "sem resposta" -- zero bytes de volta -- e a essa altura nao
    da mais para deduzir. O programa de bancada prova a fiacao com o ESP32
    SOZINHO na placa; a pergunta que importa e se a linha funciona aqui
    dentro, com Wi-Fi, servidor web, cartao e as interrupcoes dos motores no
    mesmo nucleo. So medindo aqui dentro.
    Botao "Testar a linha agora" na aba Encoder. Tres passos, com os bytes
    crus de cada um:
    1. ECO -- deixa o receptor ligado enquanto transmite e ve se os
    proprios bytes voltam. Nao precisa do driver ligado. Voltou =
    ESP32<->MAX485 bom DENTRO do sistema, e o que sobra e o barramento
    ou o tempo. Na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
2026-08-24 encoder: registrador 90 na funcao 3, e a cacada dentro da maquina
    O log da bancada fecha a questao do endereco. A cacada girou o eixo a
    mao e comparou os 256 registradores da funcao 3:
    0x005A (90) 61346 -> 39440 (variou -21906)
    0x005B (91) 0 -> 1 (variou +1)
    Um varia muito, o vizinho varia +1: e o par de 32 bits. Montando com a
    palavra baixa primeiro, 61346 -> 104976, ou +43630 contagens -- 1/3 de
    volta num encoder de 17 bits. Ao contrario o numero anda 1,4 bilhao para
    tras, que nao e giro nenhum.
    Segunda prova independente no mesmo log: duas varreduras completas da
    funcao 3, uma atras da outra, identicas em 255 registradores e
    diferentes so no 90 (36998 -> 37000). E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
2026-08-24 rede: sondas de captive portal abrem o painel; encoder loga no serial
    O log do operador comeca com o FIRMWARE rodando, e traz duas coisas.
    1. Doze "[WEB] Rota desconhecida: /connecttest.txt" seguidos de
    "[MSG] Conexao perdida". Isso e o Windows perguntando se a rede tem
    internet -- todo sistema faz, e como a maquina responde a qualquer
    nome (o DNS de captura), a pergunta cai no onNotFound.
    Responder 404 era o pior dos mundos: o sistema conclui que a rede nao
    presta, repete a pergunta de segundos em segundos, e o Windows chega
    a largar a rede sozinho. O "Conexao perdida" logo depois nao e
    coincidencia.
    Agora essas sondas (Windows, Android, iPhone, Firefox) levam 302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
2026-08-24 encoder: a cacada passa a PROVAR o par, e dois modos novos na ferramenta
    Tres cacadas seguidas, em posicoes diferentes do eixo, fecham a questao
    do registrador de um jeito que nenhuma sozinha fecha. Montando 90/91
    como 32 bits com a palavra baixa primeiro:
    A 9361 -> 15841 (+6480)
    B 15842 -> 124571 (+108729)
    C 124574 -> 42069 (-82505)
    As emendas: A termina em 15841 e B comeca em 15842; B termina em 124571
    e C comeca em 124574. O valor e CONTINUO entre cacadas separadas --
    coincidencia nao e continua tres vezes. E o mecanismo aparece: na cacada
    B o 90 deu a volta e o 91 subiu de 0 para 1; na A, que andou pouco, o 91
    nem se mexeu.
    Nas cacadas aparecem tambem 92, 93 e 9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
2026-08-24 encoder: caçada pelo sentido, coluna fixa e analise detalhada
    CORRIGE UM ERRO MEU. Na rodada passada fiz a cacada "provar" o par em vez
    de listar candidatos, e na maquina do operador ela apontou 94/95 --
    errado. O log dele mostra o porque:
    0x005A (90) 62928 -> 52971 (variou -9957)
    0x005E (94) 0 -> 65535 (variou +65535) <- o maior salto
    e o monitor no par apontado:
    reg 94 = 65535 o tempo todo (constante = -1)
    reg 95 = 0, 5, 42, 0, 65527, ... (pula para os dois lados)
    "0 -> 65535" nao e um salto de +65535: e -1. Meu criterio ranqueava pelo
    maior salto lido SEM SINAL, entao a menor variacao possivel virou a maior
    da lista. Resposta confiante e errada e pior qu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
    [HardwareSerial.h, banco.cpp, encoder.cpp, pagina_web_gz.h, testar_ui.js, teste_rs485.ino]
2026-08-24 encoder: velocidade, sentido e passos no firmware; RoboCNC -> Robo2dof
    O operador escreveu um monitor de encoder proprio, que funciona na
    bancada dele, e pediu para trazer para o sistema. Velocidade, RPM,
    sentido, delta, passos acumulados, inversoes e faixa percorrida entram --
    mas o calculo mora na TAREFA DO ENCODER, nao no navegador.
    A razao e a regua: a tarefa le a 20 Hz e o painel consulta a 4 Hz.
    Calcular velocidade no navegador seria medir com uma regua cinco vezes
    mais grossa que a disponivel, e perder toda a variacao entre consultas.
    Quem tem os instantes de verdade e quem le.
    Tres coisas que o monitor dele nao tinha e que mudam o resultado:
    - Zona morta de 3 contagens no sentido.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
    [partitions.csv]
2026-08-24 encoder: refazer colado no monitor do operador -- o DE nunca subia
    "Ate o momento apenas aparece o visual e nada de funcionamento ou
    leitura." A causa estava numa coisa que EU introduzi.
    Na rodada 13 troquei o controle do DE por RS485 meio-duplex por
    hardware: o periferico da UART dirige o DE pela linha RTS e o baixa no
    fim exato do ultimo bit. O raciocinio estava certo -- a janela entre
    flush() e baixar o DE e mesmo o ponto fraco num sistema com Wi-Fi e
    interrupcoes no mesmo nucleo. O problema foi o que fiz com o caminho
    antigo:
    static void modoTransmissao() {
    if (configEncoder.deHardware) return; // <-- nao levanta o DE
    digitalWrite(PIN_RS485_RE, HIGH);
    digitalWrite(PIN_R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
    [HardwareSerial.h, banco.cpp, config.h, encoder.cpp, encoder.h, estado.cpp, estado.h, mocks.cpp]
2026-08-25 correcao de posicao pelo encoder, e o monitor do operador em ferramentas
    ASSENTAMENTO. O incomodo era concreto: "saio de uma posicao e volto, e
    ela nao e mais a mesma". Sem conferencia, o erro de um movimento entra no
    proximo e o desvio cresce sem nunca voltar.
    Agora, quando o braco chega, o encoder diz onde ele REALMENTE parou e o
    sistema da um retoque curto. Nao e malha fechada de servo -- cada leitura
    Modbus custa 5 a 20 ms com jitter, e corrigir o eixo enquanto ele anda
    faria o braco oscilar. E assentamento no fim do movimento, que e
    exatamente o que resolve o incomodo.
    Duas decisoes que fazem isso funcionar de verdade:
    1. O erro se mede contra o ALVO, nao contra o comandado. O comand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
    [FastAccelStepper.h, Robo2dof.ino, banco.cpp, correcao.cpp, correcao.h, estado.cpp, estado.h, monitor_encoder.ino]
2026-08-25 vista 3D alternavel, e MANUAL.md com o sistema inteiro
    VISTA 3D. Botao "3D" na mesa alterna entre a vista de cima e uma
    isometrica com a altura dos elos, a coluna da base e a ferramenta
    descendo ate a peca. A escolha sobrevive ao recarregar.
    A vista de cima continua sendo a de TRABALHO: e nela que se desenha com
    o dedo e se escolhe ponto, porque um traco em perspectiva nao tem onde
    cair na mesa. Entrar na 3D desliga o modo de desenho em vez de deixar o
    operador riscando no vazio.
    pintar3D() e uma funcao separada; pintar() so despacha. A vista 2D nao
    mudou uma linha -- e o que garante que nada quebrou nela.
    MANUAL.md: o sistema inteiro num documento. Ligacoes com os porques (por
    que o MISO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
2026-08-25 calibracao com encoder, travamento, e a coluna que nao atualizava
    AFERIR A ENGRENAGEM ELETRONICA SEM TRANSFERIDOR.
    passosPorGrau = passosPorVolta * reducao / 360. Sao dois numeros, e o
    encoder so alcanca um: ele conta no eixo do MOTOR, antes do redutor,
    entao a REDUCAO continua sendo declarada por quem montou a maquina.
    Mas a ENGRENAGEM ELETRONICA ele mede sozinho -- e e justamente a que mais
    se erra: troca-se o driver, refaz-se um parametro, e o numero declarado
    deixa de bater com o que o driver faz, sem nada apontar o culpado. Marca,
    gira, "Aferir pelo encoder": passos andados dividido por voltas do motor.
    Um numero a menos para errar.
    Recusa medida curta (menos de um quarto de volta me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
2026-08-25 encoder absoluto: a maquina se localiza sozinha, e o braco 3D com volume
    O operador notou o que muda tudo: o encoder do servo guarda a posicao com
    a maquina DESLIGADA. Empurrar o braco a mao com tudo apagado, e ao ligar
    ele sabe. Isso dispensa fim de curso.
    O ZERO VIRA UM NUMERO GRAVADO. Antes era "onde o braco estava quando
    ligou", e o operador tinha de leva-lo a referencia toda vez. Agora e a
    contagem crua do encoder que corresponde a 0 grau, no NVS. Ensina-se uma
    vez, na pagina avancada atras de um cadeado.
    No boot, com leitura boa, a contagem de passos e acertada pelo encoder --
    nenhum pulso sai no fio, so a conta muda. Dali em diante limites,
    cinematica e programa funcionam igual, par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
2026-08-25 Aprendizado com a mao: o botao da ponteira e o eixo solto
    O braco movido a mao agora conta. Com o torque desligado nenhum pulso
    sai no fio, entao a contagem do firmware ficava para tras e "movi com a
    mao" nao dava o mesmo resultado que "mandei ir". seguirEixoSolto()
    acerta a contagem pelo encoder absoluto enquanto o braco esta solto.
    A regra que importa e a negativa: servo ligado, nao segue. Com torque o
    motor esta segurando a posicao; se o eixo saiu do lugar mesmo assim,
    isso e perda de passo, e quem cuida disso e o assentamento. Seguir ali
    seria trocar uma correcao por um disfarce.
    Em cima disso, o modo aprendizado (aprender.h/.cpp): um botao fisico na
    ponteira (GPIO 32) com dois gestos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
2026-08-26 Producao, saude, QR, OTA e modo operador -- e um defeito na emergencia
    A lista inteira que o operador escolheu, menos o Modbus (que ele tirou
    por o driver so operar a 19200).
    PRODUCAO
    - Pausar fecha o arco e guarda em que trecho e a que fracao dele o cordao
    parou; retomar continua dali em vez de refazer por cima do que ja foi
    soldado. O arco reabre com o tempo de abertura, porque a poca esfriou.
    - "Mais uma peca" repete o programa sem reabrir o arquivo.
    - Contador de pecas em NVS: prontas, interrompidas, tempo de arco
    acumulado (o numero que diz quando trocar bico) e ciclos desde a
    manutencao. Ensaio nao conta.
    - Desfazer, um nivel, reversivel: cobre apagar um programa de trinta
    p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
    [partitions_ota.csv]
2026-08-27 Caca a bugs: sete defeitos reais, e a engrenagem de configuracao
    CACA A BUGS
    Nao foi so rodar os testes que ja passavam. Tres ferramentas novas
    acharam o que o olho nao acha: sanitizadores, um varredor de rotas com
    valor hostil, e um analisador de JSON estrito aplicado a toda resposta.
    1. LEITURA ABSURDA DO ENCODER VIRAVA A POSICAO (o pior)
    O firmware escrevia a leitura na contagem de passos sem conferir nada.
    Uma leitura errada -- registrador errado, contagens por volta erradas,
    ruido que passou no CRC -- virava a posicao oficial, e dali toda
    protecao de curso se apoiava num numero inventado. No boot a maquina
    se localiza por UMA leitura e, com "ir ao zero" ligado, sai andan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
    [Arduino.h, Robo2dof.ino, banco.cpp, calibracao.cpp, correcao.cpp, correcao.h, encoder.cpp]
2026-08-27 Calibracao pelo encoder, mesa ensinada, e o desenho mostrando o braco
    A REDUCAO -- e uma correcao de premissa
    O pedido era "com o angulo posso achar a reducao mais facil". A conta nao
    fecha: graus da junta = voltas do motor * 360 / reducao. O angulo que o
    encoder mostra JA e calculado usando a reducao -- tira-la dele seria
    tira-la de uma conta que a usa. Com um sensor so, antes do redutor, a
    relacao do redutor e invisivel. Isso e fisica.
    O que o encoder da e a contagem de VOLTAS DO MOTOR, precisa e imune a
    perda de passo. Falta UMA referencia do lado da junta, e ai a reducao sai
    exata. Referencias, da melhor para a pior: esquadro de 90 graus (preciso
    e todo mundo tem), curso entre batentes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
2026-08-27 Ligar e desligar o som do driver pelo RS485, sem adivinhar o endereco
    O pedido era calar o bip do driver pela tela em vez de ir ao painel dele
    digitar P098. Da para fazer: Modbus tem escrita (funcao 06 e 16) e e o
    mesmo fio que ja le a posicao. O que nao da e supor que "P098" seja o
    registrador 98 e mandar escrever la -- o mapa Modbus do T3D nao esta
    publicado, e o registrador da posicao (90) foi achado procurando.
    Ler no registrador errado da um numero errado na tela. Escrever no
    registrador errado pode trocar a engrenagem eletronica, o modo de
    controle, o sentido do eixo ou o limite de torque. Por isso o caminho
    comeca por uma ferramenta que nao escreve nada:
    /api/encoder/diferenca du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
2026-08-28 SON: o habilita continua no fio, com espelho no RS485
    O pedido anterior foi lido como "o som do sistema" e virou um botao
    generico de parametro. Era SON -- Servo ON, o habilita do motor. A
    diferenca nao e de nome: aquele botao exigia so braco parado, entao
    aponta-lo para o registrador do SON teria virado um jeito de energizar o
    eixo por fora de servosHabilitar(), sem emergencia, alarme nem perda de
    conexao olhando. Isso foi fechado antes de tudo.
    O habilita continua sendo o FIO: PIN_SERVO_ON (GPIO 23), por
    optoacoplador. Fio de SON rompido desabilita o motor; fio de RS485
    rompido nao desabilita nada, deixa o eixo como estava. Um e falha segura,
    o outro nao.
    O que entrou e um ESPELHO, para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
2026-08-28 Apagar tudo, um conjunto so de icones, e a escrita de volta para a bancada
    Quatro coisas pedidas, e uma medida no fim.
    1. APAGAR TUDO, na configuracao.
    Ja havia "restaurar padroes", que devolve so PARAMETROS. O novo limpa
    o espaco de NVS inteiro -- calibracao, mesa ensinada, zero absoluto,
    encoder, contadores -- desliga o torque e reinicia. Limpar o espaco em
    vez de reescrever chave por chave e o que faz sumir tambem o residuo
    de uma versao anterior do firmware.
    Nao toca no cartao SD: peca salva e trabalho do operador, nao
    configuracao da maquina. Exige a palavra APAGAR digitada, conferida na
    tela E na porta -- a tela pode ter um defeito.
    Os dois botoes agora d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
2026-08-28 Celular, modo operador fora, biblioteca em dois cartoes e a gravacao visivel
    PUXAR PARA ATUALIZAR. Rolar uma secao ate o topo e continuar puxando
    recarregava a pagina -- num painel de maquina isso perde a aba aberta, os
    campos meio preenchidos e o heartbeat que segura o movimento.
    overscroll-behavior:none no body nao bastava: quem rola aqui sao os
    paineis de dentro, e o excesso deles sobe em cadeia ate o documento. A
    trava foi para cada rolagem e para o html. Como WebView antigo e iPhone
    velho ignoram a propriedade, ha uma trava de reserva em JavaScript,
    estreita de proposito: so barra quando o dedo desce E o container
    debaixo dele ja esta no topo.
    MODO OPERADOR REMOVIDO. Ele escondia as ab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
2026-08-28 Ajustes em linguagem de operador, calibracao guiada, e a pagina 24% menor
    AJUSTES DA MAQUINA. "Queria algo mais simples, de forma que um operador
    nao experiente consiga entender no que ele esta mexendo." Nenhum numero
    saiu da maquina -- mudou a ordem. Na frente, tres botoes que qualquer um
    entende (Lento / Normal / Rapido; Macia / Media / Firme) e uma linha de
    resumo em palavras. Atras de "Ajustar", os campos de sempre. Atras de
    "Avancado", resolucao, sentido dos eixos e as margens de seguranca, com
    um aviso de que mexer ali sem medir muda a escala de tudo.
    As protecoes viraram uma frase antes de virarem tres chaves, e a frase
    diz o que se perde ao desligar cada uma: nao aumenta a area de t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
2026-08-28 O habilita sai do fio e vai para o RS485, e o alarme ganha modos de bancada
    Na bancada ficou provado que o P098 do painel governa o torque deste
    driver, e que ele e o registrador Modbus 98 (habilita=1, desabilita=0,
    funcao 06). Isso mudou o diagnostico do fio: com o P098 em 1 o terminal
    externo nao tinha efeito, entao o SON do GPIO 23 ja era decorativo antes
    de sair.
    O habilita passou a ir por Modbus. O GPIO 23 ficou livre e encoder.h
    deixou de ser so-leitura -- por uma porta estreita: um registrador, o
    configurado, e nenhum outro. Toda escrita e conferida relendo.
    O QUE ISSO CUSTA, e esta escrito em config.h, LIGACOES.md e RS485_T3D.md:
    fio de SON rompido desabilitava o motor; fio de RS48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
2026-08-28 Habilitar deixa de sequestrar o barramento, e o motor ganha botao no painel
    O sistema parou de fluir depois que o habilita foi para o RS485.
    Regressao minha, e o banco mediu o tamanho dela.
    executarSon() fazia tudo dentro de um unico ciclo(): dois drivers, tres
    tentativas cada, escrita mais releitura -- ate doze transacoes seguidas.
    Com o barramento mudo (cabo solto, driver desligado, endereco errado --
    justamente quando o operador mais aperta o botao), cada uma gastava o
    ENC_TIMEOUT_MS inteiro. O cenario V06 mediu 822 ms presos num ciclo so.
    A tarefa do encoder roda no core 0 com prioridade 2; a tarefa de rede,
    que serve o painel, roda no MESMO core com prioridade 1 -- menor. Nesse
    tempo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
2026-08-28 Habilita por eixo, com um botao para cada, e o zero sem calibracao
    TRES COISAS, e a primeira explica a segunda.
    1. servosHabilitar() exigia que os DOIS drivers confirmassem. Com o
    segundo fora do barramento -- que e o estado da bancada -- habilitar
    recusava tudo dizendo que o driver 2 nao respondeu. Era verdade e nao
    ajudava ninguem: com o eixo 1 ligado e funcionando, nao dava para mexer
    nele.
    A raiz e que o habilita virou Modbus, e cada driver e um escravo
    proprio. Um interruptor so descrevia bem um fio ligado nos dois SON; nao
    descreve dois escravos independentes.
    Passou a ser por junta: J1.habilitado / J2.habilitado, servosHabilitar
    com junta 1, 2 ou 0, e dois botoes no cabecalho -- um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
2026-08-29 Um motor ausente deixa de travar a maquina, calibracao unica, e o braco flui
    TRES COISAS.
    1. FALHA por causa de um motor que nao esta la.
    Com um driver no barramento, servosHabilitar(false, 0) falhava na junta 2
    e eu tratava esse "nao confirmou" como o caso grave: eixo possivelmente
    energizado, sem caminho para cortar, portanto FALHA. Em FALHA todo
    comando e recusado -- inclusive ir ao zero. O robo travava por causa de
    um motor ausente.
    Faltava uma distincao, agora explicita em sonJaEnergizou[2]:
    junta que NUNCA teve torque -> o driver nao esta no barramento.
    Nao ha o que cortar. Diz e segue.
    junta que TINHA torque -> pode estar energizada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
2026-08-29 Aba Mover enxuta, ir-para-angulo por junta, e aprendizado guiado com origem pelo braco
    ABA MOVER. As notas longas do "zerar aqui", do joystick e do passo a
    passo repetiam o que o proprio botao ja diz. Ficou so o que NAO esta no
    botao: que o curso e contado a partir da referencia, e onde trocar o
    sentido do eixo.
    O "ir para um angulo" tinha um botao so para as duas juntas. Agora sao
    tres -- junta 1, junta 2 e as duas. Levar uma so e mandar a outra para
    onde ela ja esta: o firmware recebe um destino completo, nao precisa de
    rota nova, e a junta que nao se quer mexer nao anda um pulso. Com um
    motor no barramento da para levar o eixo que tem torque sem que o outro
    entre na conta.
    APRENDIZADO G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
2026-08-29 Posicionar por angulo respeita o Precisao, e o habilita diz onde esta o problema
    VELOCIDADE. Digitar um angulo e apertar o botao mandava o braco sempre em
    velAuto (deslocamento, 12 graus/s de fabrica), com o operador olhando de
    perto e sem jeito de pedir mais devagar. O botao Precisao ja existe e
    fica na MESMA aba, logo acima desses campos -- ele so nao valia ali.
    Agora vale: o mesmo gesto que deixa o jog fino deixa o posicionamento
    fino. Cenario V11 mede os dois no mesmo tempo de relogio.
    Um detalhe do proprio banco apareceu junto: reiniciarSistema() nao zera o
    modo precisao, entao o cenario novo o deixava ligado e os seguintes
    andavam a 2 graus/s -- esgotavam a espera e reprovavam por um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
    [Robo2dof.ino, banco.cpp, motores.cpp, pagina_web_gz.h]
2026-08-29 Leitura absurda do encoder deixa de ser tratada como confiavel
    Com os dois encoders conectados o braco desenhado girava sem parar.
    leituraPlausivel() conferia o angulo contra o curso CALIBRADO, e abria
    mao de conferir quando a junta nao estava calibrada:
    if (!j.calibrada) return true; // qualquer numero passava
    Maquina em comissionamento nunca esta calibrada. Entao, com os dois
    encoders no barramento e um deles mal configurado -- contagens por volta
    erradas, formato de 32 bits errado, registrador do vizinho -- o angulo
    saia em dezenas de milhares de graus, era marcado CONFIAVEL, ia para o
    status como m2ok:true, e a tela passava a desenhar o braco pelo medido.
    O braco desenhado gi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
2026-08-29 Angulo medido pela propria maquina, velocidade por motor, e a tela sem prosa
    O ANGULO NA TELA ERA O DA CONTA, NAO O DO BRACO.
    Ele saia de dois numeros digitados do catalogo:
    voltasMotor = (bruto - referencia) / contagensPorVolta
    graus = voltasMotor * 360 / reducao + grausHome
    Errar qualquer um dos dois sai em escala errada e nada na tela denuncia:
    o braco em 90 graus mostra 47, ou 300. Pior, os dois erros se compensam
    em parte, entao acertar um so piora antes de melhorar.
    Entrou uma escala DIRETA, medida pela propria maquina:
    contagensPorGrau[2] -- contagens do encoder por grau DA JUNTA. Um numero
    so, e nao se digita: marque, leve a junta ate um angulo que voce conhece,
    dig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
2026-08-29 Interface de operacao: 2D sem o tracejado de erro, eixos clicaveis, passo em graus
    TRACEJADO DE ERRO FORA DA VISTA DE CIMA. Ele desenhava o comandado atras
    do medido para mostrar o desvio entre os dois -- medicao de diagnostico,
    nao de operacao. E um tracejado em volta do braco se confundia com a
    trajetoria de solda, que e outro conceito. A vista 3D continua com o
    dela, como pedido.
    EIXOS SELECIONAVEIS NO DESENHO. Tocar num elo escolhe aquela junta e o
    seletor da aba Mover segue. A cor do elo diz se ela tem torque -- verde
    tem, vermelho nao, cinza enquanto o barramento nao confirma. Um anel
    marca a selecionada: cor diz torque, anel diz foco.
    Tocar SOBRE o braco escolhe o eixo e NAO manda a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
2026-08-29 Erro do encoder fora da tela, cor na bolinha da junta, configuracao em linhas
    O ERRO SAIU DA TELA. O painel mostrava tres numeros por junta --
    comandado, medido e erro. Numa maquina em montagem a contagem de pulsos
    do firmware anda sozinha, e o painel chegou a mostrar comandado 1986,79 /
    medido -230,05 / erro +2216,85. Nenhum dos tres ajudava a operar, e o do
    meio -- o unico que descreve o braco de verdade -- ficava perdido entre
    dois que nao descrevem nada.
    Sairam junto o grafico do erro, a linha "Avisos de desvio" na Saude e a
    legenda do desvio. Ficou o MEDIDO: onde a junta esta. O firmware continua
    calculando o erro internamente (e dele que vivem o assentamento e o vigia
    de travamento),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
2026-08-29 Reancora o contador, libera angulo sem calibracao e enxuga a aba Mover
    O erro de +2216 graus vinha do contador de passos: ele so vale enquanto
    cada pulso vira movimento. Agora, com o braco parado e a divergencia
    passando de 45 graus, o firmware reescreve o contador a partir do
    encoder e diz que reancorou.
    Ir para um angulo nomeado deixou de exigir calibracao -- precisa de
    escala, nao de limites; a trava de seguranca e a junta habilitada
    continuam valendo.
    Na aba Mover, os incrementos de passo sairam (o gesto do jog voltou a
    ser unico) e entraram controle de velocidade e teste de rele. "Gravar
    ponto" virou botao quadrado. Os eixos nascem vermelhos, nao cinza.
    O catch de encAtualizar deixou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
2026-08-29 Braco 2D com corpo e mancais, e Configuracao em colunas
    O braco deixou de ser dois tracos grossos. Cada elo virou um corpo:
    capsula afunilada, sombreada ao longo da espessura como um tubo
    iluminado de cima, com o elo 2 pintado por cima do 1 -- o cotovelo
    passou a ter ordem. As juntas viraram mancais: carcaca, aro, parafusos
    de flange e, no centro, o disco que diz se aquele eixo tem torque. A
    base ganhou flange com chumbadores e a ponta ganhou o bico da tocha,
    que agora aponta para onde o cordao vai.
    A vista 3D nao mudou: as cores dela seguem nas mesmas chaves da
    paleta, e o unico codigo compartilhado que se mexeu foi a funcao de
    clarear/escurecer cor, que subiu de dentro da 3D para o nivel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
2026-08-29 Programa: a lista vira sequencia e pre-requisito deixa de gritar
    Cada trecho ganhou um trilho a esquerda -- laranja onde ha cordao,
    cinza onde so desloca -- e a chave do cordao foi para a direita, junto
    com os outros controles. No rodape, as duas contas que se faz antes de
    executar: percurso total e quanto dele e cordao.
    "Entre no modo aprendizado primeiro" saia na mesma cor de "deu errado".
    O que a funcao de bloqueio escreve e sempre pre-requisito, nunca falha:
    virou nota cinza com um ponto na frente, e o laranja voltou a
    significar so o que deu errado.
    Bancos: firmware 423/0 (limpo tambem sob ASan/UBSan), interface 245/0.
    Claude-Sess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
2026-08-29 Conserta o braco que arrancava e parava, e poe a velocidade em mm/s
    Duas causas para a mesma cena. O seguimento de eixo solto -- que existe
    para empurrar o braco desenergizado com a mao -- era travado por
    servosLigados, verdadeiro so com AS DUAS juntas energizadas: com um
    driver so ele ficava permanentemente ligado sobre uma junta COM torque,
    reescrevendo a contagem logo depois de um destino ter sido calculado a
    partir dela. A regra virou por junta.
    E o vigia de travamento julgava pela razao entre dois numeros de
    catalogo (pulsos por volta e contagens por volta). Com o driver
    configurado com outro numero de pulsos, o esperado sai varias vezes
    maior que o real e um braco andando normalmente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
2026-08-29 Calibracao vira quatro marcas, e deixa de ser exigencia
    Calibrar era onze estados, duas etapas de volta automatica ao zero e
    dois numeros medidos a mao (o angulo declarado na referencia e o curso
    com transferidor). Agora sao quatro marcas: junta 1 no limite positivo,
    junta 1 no negativo, e o mesmo na junta 2. Nada digitado.
    Do que foi marcado sai o curso de cada junta, o zero -- que passa a ser
    o MEIO do curso, a unica escolha que nao pede numero -- e a escala do
    encoder em contagens por grau, que antes era uma tela separada com
    marca, movimento e um valor a informar. Entre as duas marcas ha um
    tanto de contagens e um tanto de graus; a divisao e a escala, com sinal.
    O batente se alcanca co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
2026-08-29 Tira o travamento: regua medida para parar, e barramento sem espera a toa
    O vigia comparava a velocidade medida com uma esperada tirada de pulsos
    por volta x contagens por volta -- dois numeros digitados. Um deles fora
    do que o driver faz e um braco andando normalmente vira eixo travado
    meio segundo depois de arrancar, com o vigia cortando o movimento.
    Agora ele so PARA quando a escala do encoder foi medida; sem ela avisa
    e nao encosta no braco.
    O ciclo do encoder alternava as duas juntas sempre. Com um driver so,
    metade das leituras era espera ate o timeout, na mesma tarefa que
    divide o nucleo 0 com a rede -- o sintoma nao era o motor, era a tela
    engasgando. Depois de cinco falhas seguidas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
2026-08-30 Conserta o movimento cortado, o toque que movia o braco e o risco azul
    "Anda dois segundos e trava": ao separar acusar de parar no vigia de
    travamento eu deixei o contador subindo nos dois casos -- e e esse
    contador que o laco principal observa para interromper o movimento
    automatico. O vigia "so avisava" e o movimento morria do mesmo jeito.
    Agora quem conta e quem para, e o criterio mudou de forma: com escala
    medida exige proporcao; sem ela, exige o sinal que nao depende de
    escala nenhuma -- pulso correndo e encoder parado. A protecao voltou a
    valer em qualquer maquina, e o falso positivo por numero de catalogo
    continua fechado.
    O relogio da tela disparava a cada 220 ms sem esperar a volta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
2026-08-30 Varredura: codigo morto fora, portao no assentamento, zero avisos
    O grafico do erro era codigo morto desde que o erro deixou a tela: o
    canvas saiu, mas o historico continuava sendo alimentado a cada
    consulta. Saiu junto a unica funcao sem chamador do firmware e uma
    variavel nao usada no vigia -- o firmware compila agora sem um unico
    aviso.
    O assentamento e o unico caminho que move o braco sem vir de um comando
    do operador. pararTudo() ja o cancela, mas depender disso e confiar em
    ordem de chamada: a trava do portao passou a valer ali tambem.
    E um cenario novo varre as dezoito rotas que a interface pode disparar
    com o braco andando, para nenhuma delas voltar a encostar no movimento.
    Bancos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
2026-08-30 Alarme fora, braco livre por padrao, e calibrar vira dois gestos
    O ALM dos drivers saiu do firmware: ele lia dois pinos que ninguem
    nunca ligou e carregava um caminho de falha inteiro disparado por ruido
    de pino solto. Quem corta de verdade continua sendo o contator. GPIO 34
    e 35 estao livres.
    As tres protecoes nascem DESLIGADAS. Protecao ligada sobre numero
    errado nao protege nada: recusa movimento legitimo e deixa o operador
    olhando um braco que nao anda, sem saber por que. Ligada, ela vale --
    quem liga sabe o que esta protegendo.
    Calibrar virou dois gestos. Toque: a maquina leva os dois eixos ao zero
    e solta os motores. O operador empurra com a mao ate o extremo de um
    lado -- os dois ei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
2026-08-30 Tela de operacao: numero grande, origem atras do cadeado, ajuda por aba
    Quatro mudancas na tela de trabalho, todas de leitura:
    - A regua do rodape passou a corpo 28. E o numero que o operador le de
    pe, a um metro da bancada; o rotulo em cima e o medido embaixo ficam
    pequenos de proposito, para a hierarquia ser obvia de relance.
    - "Zerar a maquina aqui" ficava a um botao de distancia de "Ir para o
    zero da maquina". Um ANDA ate a referencia, o outro MUDA onde ela
    fica -- e o segundo desloca a area util inteira. Virou "Declarar esta
    posicao como referencia", atras do mesmo cadeado que ja guarda o zero
    absoluto na gaveta.
    - O "?" do cabecalho voltou, com outro papel: nao esconde n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
2026-08-30 Arquivos: uma biblioteca so. Configuracao: um comeco e uma busca
    ARQUIVOS
    Havia dois cartoes lado a lado -- "Programas salvos" e "Trajetorias
    salvas" --, cada um com o seu campo de nome, o seu Salvar e a sua
    lista. Para usar era preciso saber ANTES em qual das duas palavras o
    que voce acabou de fazer se encaixa; quem nunca operou nao sabe, e o
    segundo cartao ainda nascia fechado.
    Agora e um so: um campo de nome, um Salvar, uma lista. O tipo virou
    etiqueta em cada linha -- depois de salvo, quando ja nao e uma decisao.
    A escolha de tipo so aparece quando a maquina tem MESMO as duas coisas
    para guardar; nos outros casos ela se faz sozinha. Sem nenhuma das
    duas, o texto volta a falar de program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
2026-08-30 Desenho 2D/3D: posicao vem so do encoder, nunca do comandado
    Relato: "o desenho esta fora de posicao, a posicao dele deve ser
    influenciada apenas pelos encoders ou a reducao, apenas isso".
    postura() -- a funcao unica que alimenta o 2D, o 3D e a detecao de
    clique nos dois -- ja preferia o angulo medido quando havia leitura,
    mas por junta, sem leitura confiavel, caia de volta no COMANDADO (a
    conta de pulsos do firmware). Isso escondia justamente o caso em que
    mostrar a diferenca importa: passo perdido, folga do redutor ou uma
    escala mal medida nunca aparecem no comandado, so no que o encoder ve.
    Agora, sem leitura confiavel, a junta CONGELA na ultima postura medida
    de verdade -- nunca volta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
2026-08-30 Encoder calado pelo curso medido, jog morto pela coluna, Levar sacudindo o outro eixo
    Tres defeitos, um por relato.
    1) "MOVO O MOTOR E O BRACO NAO ACOMPANHA" (firmware)
    leituraPlausivel() recusava qualquer leitura fora do curso medido. Na
    maquina da foto a junta 1 tinha um curso de ~4 graus (calibracao
    abortada) e o braco estava em -65,9: TODA leitura do encoder era
    descartada. E como leituraConfiavel() e o portao de tudo, calou junto a
    reancoragem da contagem, o seguimento de eixo solto, o assentamento e o
    m1ok do status -- com o desenho (que so obedece ao encoder) congelado.
    A premissa envelheceu: desde que o limite de curso virou OPCAO, o curso
    medido deixou de ser afirmacao sobre onde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
2026-08-30 Painel de jog: quadro fixo, sem rolagem, sem os restos
    Rolar e o defeito, nao o sintoma: se a coluna rola, a seta que estava
    sob o dedo saiu dali. A captura de ponteiro ja tinha feito o gesto
    sobreviver a isso; faltava a coluna parar de precisar rolar.
    A 1280x800 o conteudo passava 119 px do quadro:
    - A ajuda por aba nasce FECHADA. Aberta ocupava 97 px bem em cima das
    setas -- sozinha, 80% do estouro. Continua a um toque no "?", com a
    escolha gravada no navegador.
    - "Mudar a origem" saiu do painel e foi para a gaveta, no cartao "Zero
    absoluto", que ja e sobre origem e ja tem o mesmo cadeado. Mudou de
    lugar, nao sumiu: este painel e o de MEXER no braco.
    - O rodape do joystick saiu: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
    [pagina_web_gz.h, testar_ui.js]
2026-08-30 Ir a um angulo parte de onde o BRACO esta, nao da contagem
    Relato: "quando clico para ir ao ponto zero ou a um angulo ele esta se
    baseando no erro para a chegada; o braco nao chega ao angulo, so o
    erro".
    O destino de "ir para o zero" e absoluto EM PULSOS, calculado sobre a
    contagem que o firmware mantem. Com a contagem adiantada do braco --
    perda de passo, folga, escala recem-medida -- mover a CONTAGEM ate o
    alvo deixa o BRACO parado no tanto do erro. Na tela isso e literal: o
    fantasma tracejado vermelho E a contagem, e era ele que chegava ao
    angulo pedido.
    O banco reproduz o numero exato. Contagem em 5 graus, braco em 12, "ir
    ao zero": antes chegava contagem 0,00 / braco 6,98; agora chega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
2026-08-30 Mesa de tracado: saem os botoes IR e DES
    Dois botoes na barra da mesa disputavam o mesmo toque: IR (ligado,
    tocar na mesa mandava a PONTA ate o ponto tocado) e DES (riscar o
    caminho com o dedo, e o traco virava programa de pontos).
    Sairam os dois. O toque na mesa passou a ter um proposito so: escolher
    o eixo, tocando num elo. Levar o braco a um lugar se faz pelas setas e
    por "ir para um angulo", que dizem para onde vao ANTES de ir; o caminho
    se ensina por pontos gravados ou importando um DXF.
    Saiu com eles a barra #barraDes, o modo de desenho inteiro (desOn, o
    traco, o simplificador enxugar(), o cursor de mira) e a regra de
    exclusao mutua entre os dois modos -- que so existia porque os doi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
2026-08-30 Chegada baseada no encoder: tres portoes que impediam o braco de chegar
    Relato: "ainda nao chega; quem chega e apenas o tracejado. Para
    movimento para angulo o braco deve se basear no ENCODER, nao no erro,
    com suavidade na chegada."
    O commit anterior consertou o PONTO DE PARTIDA (ancorar a contagem no
    encoder antes de calcular o destino). Faltava a CHEGADA. Quem fecha a
    conta depois que o eixo para e o assentamento -- e ele estava barrado
    por tres portoes independentes, cada um bastando sozinho:
    1. faltaPara() exigia CURSO MEDIDO. Mesmo defeito de R143 noutro lugar:
    junta sem calibracao nao recebia assentamento nenhum. Agora usa
    leituraConfiavel(), que confere registrador, validade,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
2026-08-30 A aba de jog virou painel de comando; Programa vira quadro fixo
    EIXO 1, EIXO 2 e PARAR sairam do cabecalho e foram para uma linha no
    alto da aba Mover, junto das setas que a mao ja esta usando. No lugar
    deles entrou o atalho Arquivos.
    O que isso custa, dito na cara: o PARAR deixou de estar em toda tela --
    nao aparece na aba Programa nem com a gaveta aberta. O que para a
    maquina de qualquer lugar passou a ser a tecla de espaco, e e ela que o
    banco prende agora, no lugar do teste antigo de "PARAR clicavel com a
    gaveta aberta". Nada disso e a parada de emergencia: essa sempre foi o
    contator no fio, o unico corte que funciona com o ESP32 travado.
    Saiu a tarja de estado ("PRONTA / UM EIXO COM T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
    [pagina_web_gz.h, testar_ui.js]
2026-08-30 A maquina diz qual binario roda, e se o movimento saiu pelo encoder
    A foto do relato mostra contagem -3,3 graus, encoder 63,00 e erro
    +66,31 -- com a mensagem "Indo para 0.0 / 0.0 graus". Essa frase e a
    ANTERIOR ao ancoramento: com 66 graus de correcao o firmware corrigido
    diria "a contagem estava 66,31 graus fora e foi acertada pelo encoder".
    A placa esta rodando um binario sem as correcoes.
    E nao havia nada na tela que dissesse isso. Diagnosticar o fonte
    enquanto a maquina roda outro binario e trabalho jogado fora.
    1) A SAUDE PUBLICA O MD5 DO BINARIO GRAVADO, na primeira linha.
    __DATE__ nao serviria: e do momento em que AQUELE arquivo foi
    compilado, e uma correcao noutro .cpp nao m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
    [Arduino.h, Robo2dof.ino, banco.cpp, correcao.cpp, correcao.h, pagina_web_gz.h, servidor_falso.py]
2026-08-30 Tira o fantasma tracejado do comandado
    Ele desenhava o braco onde a contagem de pulsos achava que ele estava,
    em vermelho tracejado, sempre que contagem e encoder discordavam de mais
    de meio grau.
    O criterio de aparecer estava errado por construcao: durante TODO
    movimento a contagem vai a frente do braco por causa da rampa. O
    firmware ja sabe disso e ignora esse periodo no proprio alerta de
    fora-de-posicao; o desenho nao ignorava. Resultado: o tracejado piscava
    a cada viagem, em condicao perfeitamente normal. Alarme que toca em
    condicao normal ensina a ignorar alarme -- e ai ele nao serve nem quando
    o desvio e de verdade.
    Saiu junto tudo que so existia para ele: DESVIO_VISIVEL e os campos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
2026-08-30 Arquivos vira gaveta de tela cheia, no molde da Configuracao
    Era um terco de coluna ao lado do desenho do braco -- e ali uma lista de
    trabalhos nunca coube. Guardar e abrir trabalho e uma biblioteca: quer
    largura, e nao se olha para o braco enquanto se escolhe arquivo.
    Virou gaveta de tela cheia no MESMO molde da Configuracao (veu cfgVeu +
    cx cfgCx + cfgRol), aberta pelo atalho "Arquivos" do cabecalho. Duas
    gavetas com a mesma forma sao uma coisa so de aprender: mesmo lugar do
    titulo, mesmo Fechar, Esc fecha, tocar fora fecha, e so uma fica aberta
    por vez.
    A aba saiu das DUAS barras (a de baixo, do celular, e a de cima, do
    computador), do mapa PANES e da ajuda por aba. A tela de trabalho f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
2026-08-30 Trava no meio e passa do ponto: uma regua, dois sintomas
    Relato: "comeca bem, mas no meio do caminho da alguns travamentos e
    nunca chega; e quando o caminho e curto ele passa e nao tem ajuste que o
    faca ir para o ponto certo".
    Parecem dois defeitos. Sao a MESMA condicao: passosPorGrau (catalogo:
    pulsos por volta x reducao) discordando de contagensPorGrau (medido).
    Discordar e o normal antes de calibrar.
    1) A TRAVA NO MEIO DO CAMINHO.
    O vigia de travamento tinha dois criterios e ESCOLHIA entre eles. O ramo
    proporcional divide por passosPorGrau e compara com o encoder: com as
    reguas discordando, o esperado sai varias vezes maior que o real, o eixo
    entrega menos de um quinto do previsto, e um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
2026-08-31 Recusar leitura do encoder que teleporta, mas so se nao se repetir
    O relato era "o braco esta pulando angulo e travando no meio do
    trajeto". A tela mostrava pior erro -369,736 graus e bruto 128885 --
    131072 x 0,983, uma volta de motor inteira num degrau de ~360 graus.
    Nenhuma junta anda uma volta de motor entre duas amostras de 50 ms.
    Isso nao e o eixo, e a leitura: quadro corrompido que passou no CRC,
    palavra baixa de um instante casada com a alta do seguinte, contador
    dando a volta. Chegam como inteiro plausivel, entao nenhuma trava de
    valor absoluto pega -- o que os denuncia e a distancia ate a leitura
    anterior.
    Obedecer virava tudo: o desenho saltava, ancorarNoEncoder() reescrevia
    a co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
2026-09-01 Etapa 0: o erro deixa de ser criterio de parada em tres lugares
    O relato: "ainda esta sendo considerado erro entao ele nunca vai ao
    ponto corretamente, apos uns 36 seg o braco comeca a travar e parar o
    movimento -- parece que o erro calculado e um indicador de parada".
    O diagnostico estava certo e era mais literal do que parecia. A raiz de
    tudo e uma regua DIGITADA.
    A ALGEBRA. Esta maquina nunca rodou a calibracao guiada, entao
    contagensPorGrau e 0. Aih a contagem converte por
    passos x 360/(ppv_cfg x red) e o encoder por (passos/ppv_real) x 360/red:
    A REDUCAO CANCELA, e a razao entre as duas reguas e exatamente
    ppv_cfg/ppv_real. O braco passava do ponto porque passosPorVolta -- a
    engrenage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
2026-09-01 Etapa 1: a mao livre ganha casa, e tres travas caem
    O relatorio pede a Trajetoria Mao Livre como funcao de destaque: aba
    propria, dois modos, reta entre pontos e funcionamento com um eixo so.
    A EXPLORACAO MUDOU O TAMANHO DA ETAPA. Quase tudo ja existia: aprender.cpp
    solta os motores e grava ponto com a mao (secao 9), programa.cpp faz reta
    entre pontos (secao 10) e trajetoria.cpp grava continuo preservando curva
    (secao 11). O firmware da mao livre nunca foi apagado quando a tela dela
    saiu. O trabalho real foi dar a esses tres uma casa clara e derrubar o que
    ainda os impedia.
    RETA EM TODO TRECHO. O deslocamento era interpolado nas juntas -- mais
    rapido, e a ponta fazia uma curva. Num caminho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
2026-09-01 Etapa 2: a tela enxuta, e a tira que estava sendo esmagada
    Prioridade 2 do relatorio. Nenhum .cpp foi tocado: as funcoes protegidas
    da secao 30 ficaram intactas.
    SECAO 6 -- A SOBREPOSICAO ERA UMA TIRA ESPREMIDA.
    Li o CSS e nao achei culpado: o cabecalho e z-index 80 e nada da coluna
    sobe acima dele. Chutar correcao para defeito visual nao visto e como se
    entrega nao-correcao, entao rodei a tela larga e OLHEI. Estava na captura,
    e e medivel: a tira de abas da coluna aparecia cortada ao meio.
    Mover, Encoder .rol block 34,3 px
    Mao livre, Programa .rol flex 20 e 18,3 px
    As abas de quadro fixo transformam o .rol em coluna flex, para o miolo
    rolar por dentro. Ali a tira vira I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
    [pagina_web_gz.h, testar_ui.js]
2026-09-01 Etapa 3: um controle de velocidade, e um angulo por junta
    RELATORIO TECNICO §3, §4, §25, §26 e o que faltava da §27.
    Havia QUATRO maneiras de escolher a velocidade -- cinco degraus, os
    apelidos lento/normal/rapido, o botao Precisao e os perfis da aba
    Maquina --, cada uma numa escala diferente e gravando por cima da
    anterior. Era isso o "muito complexo" do pedido: subir a velocidade num
    lugar e ve-la nao mudar noutro.
    Fica UM controle, em mm/s, na tira do rodape, valendo para o jog e para
    o ir-para-angulo. O °/s na junta desce para o texto de apoio.
    - §4 saem #velNiveis, os atalhos data-vel, #btPrec, velDoNivel(),
    nivelDaVel(), VEL_NIVEIS e o CSS que os servia
    - §4 o modo P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
2026-09-01 Etapa 4 + os tres defeitos da bancada
    ETAPA 4 -- Arquivos vira gerenciador (RELATORIO §12, §15, §16)
    - §15/§16 a gaveta de Arquivos ganha DUAS areas: entrada estreita
    (cartao, salvar, DXF) e biblioteca larga (a lista). Ela e item de uma
    grade de colunas automaticas; #pnArq passa a mandar no proprio arranjo,
    senao a coluna de 410 px fatiava as duas em pedacos iguais.
    - §12 o bloco #eDxf sai do painel do Programa e entra na area de
    entrada. "Posicionar na mesa" passa a FECHAR a gaveta antes de trocar
    de aba: sem isso o operador aperta e continua vendo a mesma tela.
    OS TRES DEFEITOS DA BANCADA
    Sao tres sintomas de duas causas, e as duas sao a mesma ideia levada
    longe demais: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
2026-09-01 Ir ao angulo 3 e um tiro so: sete retoques viraram zero
    Da bancada: "anteriormente o braco ia bem ate tal angulo, so preciso que
    ao colocar para ir ao angulo 3 ele va sem enrosco. O braco do 2D e
    justamente o desenho do encoder: se o encoder diz 3 graus, ele esta em 3
    graus."
    MEDIDO ANTES DE MEXER. O cenario V27 monta o caso da bancada -- regua
    digitada errada por um fator de dois -- e conta os retoques: SETE, para
    um pedido de 3 graus. E a maquina ja sabia a engrenagem certa (10000)
    enquanto obedecia a digitada (20000).
    Por que enrosca: pedir 3 graus com a regua dobrada manda o braco a 6, e
    o assentamento o traz de volta em passos de no maximo 3 graus, cada um
    custando 250 ms de espera ma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
2026-09-01 Freio do encoder: o braco para quando a medida diz que chegou
    REGRESSAO QUE EU CAUSEI, E O CONSERTO DE VERDADE.
    Da bancada: "esta muito ruim, quando peco para ir a um angulo ele fica
    dando voltas sem parar". Isso foi obra do commit anterior e e mais grave
    do que o defeito original.
    Por que: a adocao automatica da engrenagem divide pulsos contados por
    voltas lidas. Num barramento com 7% de falha e 4,5 leituras por segundo,
    uma leitura PARADA enquanto o eixo anda deixa o divisor pequeno demais e
    a engrenagem sai enorme -- e regua enorme transforma um pedido de 3 graus
    em centenas de voltas. O teto que existia (2 milhoes de pulsos por volta)
    e duzentas vezes o valor real: nao segurava nada. E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
2026-09-02 Ir a um angulo: afina ao chegar, e para no numero
    Da bancada: "o sistema atual nao para no ponto especificado. Se eu peco
    para ir ao angulo 45 ele vai, minimiza a velocidade e para exatamente no
    angulo 45. Atualmente esta todo atrapalhado."
    MEDIR ANTES DE MEXER -- e a medicao desmontou a minha suposicao.
    Eu ia reescrever o caminho de posicionamento inteiro. Antes disso
    instrumentei: cinco angulos seguidos, registrando o erro final, quanto o
    braco PASSA do alvo e quantas vezes ele INVERTE de sentido.
    regua certa: erro 0,012 grau | passou 0 | 0 inversoes
    regua errada 2x: erro 0,048 grau | passou 1,3 | 2 inversoes
    A precisao ja estava boa -- o assentamento fechava. O que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
2026-09-02 A micro variacao era o ritmo do barramento, nao o alvo
    Da bancada, com a captura do painel: "micro variacao e nunca fica no
    ponto setado. A velocidade parece nao influenciar em nada, pois o sistema
    funcionava bem antes -- ele ia ao ponto, ia desacelerando com rampa e
    parava exatamente. Agora ele fica tentando acertar."
    O NUMERO ESTAVA NA CAPTURA: 4,6 leituras por segundo, 213 falhas em 4955.
    Nao era o alvo, nao era a velocidade, nao era a rampa. Era o RITMO da
    medida. Corrigir o eixo a partir de uma leitura so converge se a PROXIMA
    leitura chegar a tempo de mostrar o resultado da correcao. A 4,6 por
    segundo a maquina age, o eixo anda, e so ~217 ms depois ela ve onde
    parou -- e age de novo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
    [Robo2dof.ino, banco.cpp, config.h, correcao.cpp, correcao.h]
2026-09-02 A velocidade alta era a regua, e o instrumento mentia
    O freio pelo encoder tinha ficado atras do mesmo portao do assentamento,
    na rodada anterior. Foi erro de escopo: o assentamento retoca nos DOIS
    sentidos e por isso caca o ponto num barramento lento; o freio so REDUZ e
    PARA, e freio tardio ainda e freio. Sem ele sobrou a regua digitada
    mandando no eixo -- com ela quatro vezes maior, "va a 40 graus" virou 160
    e o braco comecava e nao parava mais.
    O portao agora vale so para o assentamento. E a velocidade passou a sair
    da medida: a cada leitura nova a maquina compara o que o eixo andou com o
    que foi mandado naquela janela e encolhe o comando na mesma proporcao.
    Quatro decisoes, cada uma co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
2026-09-02 Tres comandos por viagem, e a rampa faz o resto
    As duas versoes em que o controle de rotacao funcionava melhor -- a de
    antes do encoder e a de antes do freio -- concordam numa coisa so: nada
    toca na velocidade enquanto o eixo anda. moveTo() e a rampa correm
    inteiras.
    E elas mesmas explicam por que, no proprio comentario:
    "Reprogramar a cada ciclo obriga o gerador a refazer a rampa mil vezes
    por segundo, o que aparece como aspereza no movimento."
    Esse aviso nunca saiu do codigo -- esta em motores.cpp:235, dizendo que
    TODA escrita de velocidade passa por programarVelocidade(). A correcao
    furava os dois: recalculava a velocidade a cada leitura do encoder E
    chamava setSpeedInHz() direto,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
2026-09-02 Chegou, para de mexer -- o driver e servo
    "Quando chega ao objetivo fica oscilando ate acertar o grau certo, e como
    se trata de um servo motor isso nao e necessario."
    Esta certo, e a razao e estrutural: o freio ja para o eixo quando o
    encoder diz que ele chegou ao angulo pedido. Depois disso o que resta e o
    escorrego da rampa de parada mais o ruido da leitura -- decimos de grau,
    abaixo do que a maquina repete. O assentamento perseguia esse resto
    contra uma tolerancia de 0,10 grau, e com a regua digitada errada cada
    retoque anda o dobro do pedido e erra para o outro lado.
    A regra nova cabe numa linha: JUNTA QUE A MEDIDA CONFIRMOU NAO ENTRA NO
    RETOQUE. Duas situacoes marcam a confirmacao, as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
2026-09-03 "Passa longe": a junta curta saia no talo
    moverCoordenado() NAO da a mesma velocidade as duas juntas: da a cada uma
    a que faz as DUAS chegarem juntas -- a que anda pouco vai devagar, e e
    isso que deixa o caminho reto no espaco das juntas.
    A largada pelo fator da regua, que eu escrevi duas rodadas atras,
    sobrescrevia as duas com velAuto. A junta de percurso curto saia na
    velocidade da outra, chegava muito antes, no talo, e passava do ponto
    pelo tanto que o barramento leva para contar.
    Todo cenario de angulo mexia UMA junta so -- V29, V30, V31, V32, V34,
    todos com t2=0. A maquina de verdade sempre mexe as duas, e por isso a
    bancada via em todo movimento o que o banco nao via em nenhum. V35 e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
2026-09-03 A busca: andar ate a medida bater, e so isso
    Quatro rodadas de conta cada vez mais elaborada errando o ponto -- freio
    pela medida, lei raiz(2.a.falta), governador por leitura, tres comandos,
    quatro comandos com reducao na metade. Cada uma consertava o defeito da
    anterior e trazia um novo.
    Tudo isso saiu. Ir a um angulo passou a ser:
    falta = angulo pedido - o que o encoder diz
    dentro da tolerancia? para.
    ainda nao? segue, na mesma velocidade.
    parou. olha de novo.
    ainda nao bateu? vai de novo, mais devagar.
    Nenhum destino em passos, nenhuma rampa planejada, nenhuma distancia de
    frenagem. Nada aqui depende de passosPorVolta estar certo: a regua entra
    so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
2026-09-03 Quatro defeitos com o banco verde, e o que o banco nao perguntava
    Antes de trocar o caminho de posicionamento, os consertos que nao
    dependem de troca nenhuma. 543 cenarios passavam com todos eles dentro.
    REFERENCIAR NAO ZERAVA O ENCODER. A chave de fechar do bloco de recusa
    estava depois de encoderZerar(0), dentro dele e depois do break: a
    chamada era INALCANCAVEL. Referenciar zerava a contagem de passos e
    deixava a do encoder onde estava -- as duas reguas passando a contar de
    pontos diferentes, que e o "senao o erro nasce torto" escrito na linha
    de cima. O compilador nao avisa de codigo morto assim.
    A CALIBRACAO ESCREVIA VELOCIDADE POR FORA DA PORTA. irAoZero() chamava
    setSpeedInHz() dire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
2026-09-03 O ritmo que decide sai na tela, medido por quem le
    A tela ja mostrava "por segundo" na aba do encoder, mas contando as
    respostas que chegam AO NAVEGADOR -- e ele consulta a 4 Hz, uma regua
    cinco vezes mais grossa que a disponivel. O numero que decide se o
    encoder da conta e outro: o intervalo entre leituras BOAS, medido pelo
    firmware, que e quem tem os instantes de verdade.
    Ele agora sai em /api/encoder por junta e aparece como "ritmo real", com
    a palavra "lento" ao lado quando passa de 100 ms.
    E e ele que denuncia o rodizio: com as duas juntas ligadas o ciclo de
    leitura alterna, entao cada uma e lida a cada DOIS periodos. Quem digita
    50 ms e ve "50 ms" no campo nao tem como adivinhar que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
2026-09-03 A rampa leva o eixo, e o encoder confere
    Ir a um angulo disparava DOIS controladores no mesmo eixo.
    moverCoordenado() programava um moveTo() -- que para exatamente no passo
    comandado -- e logo depois a busca chamava runForward(), que DESCARTA o
    alvo da rampa. O braco passava a andar em velocidade constante, as cegas,
    ate o encoder dizer que ja tinha passado.
    Um liga-desliga com sensor atrasado nao para num ponto: o comando de
    parar so sai quando a medida diz que JA passou, e ate a medida chegar o
    eixo andou. Nao e defeito de ajuste, e o desenho -- as quatro rodadas de
    constante que o commit da busca lista sao a prova. Dai sairam os tres
    sintomas: passa e volta, para do nada, e nao chega.
    A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
2026-09-04 A Configuracao volta a rolar, e as abas voltam a ser um ficharo
    Da bancada: "a aba quando aberta apresenta itens cortados e como nao tem
    rolagem na tela nao consigo ver o que esta escrito para baixo a menos que
    eu ajuste o zoom".
    E uma REGRESSAO, e nao uma escolha de layout. Um commit de limpeza apagou
    de uma vez o roteiro "por onde comecar", a engrenagem animada e -- no meio
    do mesmo bloco -- duas regras que nao tinham nada a ver com aquilo:
    .cfgAbas{...} o estilo das quatro abas
    .cfgRol{flex:1;overflow-y:auto;...} a area que rola
    Os tres primeiros sairam do HTML junto e a remocao estava certa. As duas
    ultimas ficaram orfas, e dai os dois sintomas, que sao o mesmo defeito:
    - .cf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
    [pagina_web_gz.h, testar_ui.js]
2026-09-04 0 e 360 sao o mesmo lugar
    Dois relatos da bancada, e sao um defeito so:
    "peco 0 grau, ele passa mesmo que minimamente, e ai se atrapalha com o
    360 e continua a trajetoria"
    "esta em 340 e peco 5: ele vai pelo caminho mais dificil"
    O angulo desta maquina e linear de ponta a ponta -- sai de
    (bruto - referencia)/escala + grausHome, e nao ha resto de divisao em
    lugar nenhum do firmware. Isso e uma escolha boa: e o que deixa a maquina
    descrever um eixo que da varias voltas sem se perder. Mas quem digita o
    destino pensa em circulo, e o firmware nao sabia disso.
    Com o braco em 359,95 e um pedido de 0, a conta da -359,95 e o eixo da a
    volta inteira. De 340 para 5 ela da -335 onde o certo er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
2026-09-04 A maquina trabalha em uma volta so
    Da bancada: "peco para ir a zero, ele chega e continua 360, 350...".
    Eu tinha lido isso como o bra\co indo para o lugar errado, e nao era. O
    banco reproduziu, e o relato estava certo:
    pedi 0 (estava em 256): parou em 360.000, andou +104
    pedi 0 (estava em 350): parou em 360.000, andou +10
    pedi 0 (estava em 360): parou em 360.000, andou +0
    O BRACO SEMPRE FOI PARA O LUGAR CERTO. Quem estava errado era o NUMERO.
    A volta mais proxima leva o eixo ao ponto do zero pelo caminho curto, e
    o painel passa a dizer 360 -- e fica dizendo. Pedir 0 de novo nao move
    nada, porque a maquina acha que ja chegou. E com um curso que vai ate
    350, 360 fica FORA dele: o b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
